jaestefaniah27/scroll_wheel/KEYBOARD_ORBY_V3/RASPBERRY_PROJECT/ORBY_V4/task.md

# Tareas: Diseño y Desarrollo del Firmware Orby

- [x] Analizar el código base existente (`main.cpp`, `pinout.h`, `hardware_oled.h`, `main_diag.cpp`).
- [x] Crear el Plan de Implementación inicial y plantear las preguntas de diseño al usuario.
- [x] Obtener feedback del usuario para determinar el camino a seguir (Opción A vs Opción B).
- [x] Completar y refinar el documento `interaccion_humano_maquina.md`:
    - [x] Detallar la especificación del hardware elegido.
    - [x] Agregar el Diagrama JSD (Jackson System Development).
    - [x] Agregar el Diagrama STN (State Transition Network) de los menús.
    - [x] Definir el protocolo formal de comunicación serial PC-Teclado.
- [x] Desarrollar e implementar el firmware en C++ según el diseño acordado.
- [x] Desarrollar o adaptar la interfaz gráfica en `OrbyGUI` para integrarla con el firmware.
- [ ] Validar e implementar pruebas de verificación integradas.

## Firmware 2.0 — scroll de alta resolución (hecho)

- [x] Descriptor HID de ratón con Resolution Multiplier (usage 0x48) y rueda de 16 bits.
- [x] Callbacks GET/SET_FEATURE para negociar el multiplicador con Windows.
- [x] PID cambiado a 0x4006 para invalidar el descriptor cacheado por el host.
- [x] Intervalo del endpoint HID bajado de 5 ms a 1 ms.
- [x] AS5600: muestreo a 1 kHz, salida a 250 Hz, filtro EMA sobre la posición,
      banda muerta de arranque y comprobación del imán cada 500 ms en vez de por
      cada iteración del bucle.
- [x] Acumulador de scroll que conserva el resto (era la causa directa de los saltos).
- [x] Sensibilidad configurable de 6 a 240 clics por vuelta (por defecto 60).
- [x] Telemetría `WHEEL:` agregada a 20 Hz para no saturar el CDC.

## Firmware 2.0 — configuración editable (hecho)

- [x] Perfiles mutables en RAM con persistencia versionada en Flash.
- [x] Banco de bitmaps OLED personalizados (20 huecos por perfil).
- [x] Escritura en Flash por perfil, para no dejar el USB mudo durante el borrado.
- [x] Comandos `GET_STATE`, `GET_PROFILE`, `SET_NAME`, `SET_LABEL`, `SET_KEYMAP`,
      `SET_SCROLL`, `SET_SCROLL_INV`, `GET_SCROLL`, `OLED_CHUNK`, `OLED_CLEAR`,
      `RESET_DEFAULTS`.

## OrbyGUI 2.0 (hecho)

- [x] Sin recursos remotos: tipografía del sistema e iconos SVG en línea.
- [x] Empaquetado con electron-builder (`npm run dist`).
- [x] Consola con búfer circular, filtro, pausa e historial.
- [x] Botón «Guardar en Flash» con indicador de cambios pendientes.
- [x] Editor de perfiles real, leyendo del firmware (sin datos duplicados).
- [x] Captura de atajos pulsándolos en el teclado del PC.
- [x] Vista de calibración de la rueda con estado de la alta resolución.
- [x] Editor de iconos OLED con importación de imagen y difuminado.
- [x] Editor OLED v2: lienzo a altura completa con zoom 3×-28×, selector de
      destino como réplica del teclado (icono real + atajo de cada tecla),
      capa flotante movible y escalable para imagen y texto, suavizado de
      bordes previo al umbral y 11 fuentes del sistema.
- [x] `GET_OLED` en el firmware para leer los bitmaps guardados.

## Encoders y rueda configurables (hecho)

- [x] Modelo `RotaryAction` con 8 huecos por perfil: dos encoders (giro horario,
      antihorario y pulsación) más los dos sentidos de la rueda magnética.
- [x] Tipos: nada, multimedia, atajo de teclado, desplazamiento vertical,
      desplazamiento horizontal (AC Pan) y zoom (Ctrl + rueda).
- [x] Tabla de teclas de consumo ampliada a 16 entradas conservando los índices
      antiguos. Corregidas las de brillo: el código usaba 0x00B0/0x00B1, que en
      la página de consumo son Play y Pause, no brillo.
- [x] Cola de paneo horizontal junto a la vertical en el informe de ratón.
- [x] Comandos `SET_ROTARY` y volcado `PROF:<n>:ROT:...` en `GET_PROFILE`.
- [x] Editor en la vista Perfiles, con espejado automático del sentido contrario
      en las acciones de desplazamiento.

## Protección de la configuración (hecho)

- [x] Migración de ajustes entre versiones de formato en vez de descartarlos.
      Los bitmaps OLED viven en su propia región de Flash y sobreviven al
      flasheo, pero la máscara de huecos ocupados está en el sector de ajustes:
      invalidarla equivalía a perder los iconos.
- [x] Rutas de migración desde `0xDEB001CE` (v1) y `0xDEB00204` (v2).
- [x] Copia de seguridad completa a un archivo JSON del PC (perfiles, mandos e
      iconos en hexadecimal) con restauración.
- [x] Guía de uso en `OrbyGUI/README.md`.

## Auto-cambio de perfil por aplicación (hecho)

- [x] Detector de ventana activa sin módulos nativos: PowerShell de vida larga
      con P/Invoke a `GetForegroundWindow`, arrancado con `-EncodedCommand`.
- [x] Motor de reglas con prioridad por orden y comparación contra ejecutable,
      título de ventana o ambos.
- [x] Perfil de reserva cuando ninguna regla encaja.
- [x] Configuración local en `%APPDATA%\OrbyGUI\orby-config.json` (no ocupa Flash).
- [x] Vista con estado en vivo, sugerencias rápidas y botón «añadir la app actual».

## Arranque de la app (hecho)

- [x] `OrbyGUI.bat`: doble clic → instala si hace falta, compila y abre.
- [x] Eliminada la dependencia `wait-on` (no estaba instalada y rompía `npm run dev`);
      Electron reintenta la carga del servidor de Vite.
- [x] Modo desarrollo por flag `--dev` en vez de deducirlo de `app.isPackaged`.
- [x] Aviso claro al conectar un teclado con firmware anterior al 2.0.

## Firmware 3.0 — perfiles variables, capa SUPER en los mandos y rueda por perfil (hecho)

- [x] Perfiles con alta y baja en caliente: `ADD_PROFILE`, `DUP_PROFILE`,
      `DEL_PROFILE`. Al borrar se desplazan también el tramo del banco de
      bitmaps y su máscara, que van indexados por perfil.
- [x] Los mandos giratorios pasan de 8 a 16 huecos: 0-7 capa normal y 8-15 capa
      SUPER. Al migrar y al crear un perfil, SUPER arranca copiando la normal,
      así que quien no la toque no nota el cambio.
- [x] La calibración de la rueda deja de ser global: vive en el perfil y con un
      valor por capa (`SET_PSCROLL`, volcado `PROF:<n>:SCR:<capa>:...`).
- [x] Menú físico de perfiles con tantas opciones como perfiles haya, en lugar
      de las cuatro fijas.
- [x] Formato de ajustes `0xDEB00300` con migración desde `0xDEB00205` (v3),
      `0xDEB00204` (v2) y `0xDEB001CE` (v1): no se descarta nada.
- [x] `GET_STATE` informa del recuento y del tope (`STATE:PROFILES:<n>:<max>`).

## OrbyGUI 3.0 (hecho)

- [x] Dashboard con la disposición real: 12 teclas a la izquierda y, a su
      derecha, los dos encoders arriba y la rueda como disco grande debajo, que
      gira los mismos grados que la rueda física.
- [x] Perfiles y macros con la réplica del teclado del editor de iconos: cada
      tecla enseña su icono real, y el inspector tiene «Editar icono», que salta
      al editor con ese perfil, tecla y capa ya seleccionados.
- [x] Caché compartida de bitmaps (`src/oled-cache.js`) entre el editor de
      perfiles y el de iconos: leer los 20 huecos por el CDC es lento y se hacía
      dos veces.
- [x] El interruptor NORMAL/SUPER afecta a todo el perfil: teclas, mandos y rueda.
- [x] Crear, duplicar y eliminar perfiles desde la app, con contador de huecos.
- [x] La vista de rueda desaparece del menú lateral y pasa a ser una tarjeta más
      dentro de cada perfil, con su ajuste por capa.
- [x] Cambio automático con tarjetas por aplicación (programa + perfil) y
      tarjeta aparte para el perfil por defecto.
- [x] Fuera el ajuste de brillo de pantallas.
- [x] Copia de seguridad v2: perfiles variables, 16 mandos y rueda por capa;
      al restaurar crea los perfiles que falten.
- [x] Telemetría `WHEEL:<incremento>:<ángulo>`: el firmware manda también el
      ángulo absoluto del AS5600, así que la app dibuja la rueda donde está de
      verdad en vez de acumular incrementos que se descuadran al reconectar.
- [x] Calibración del marcador (`src/wheel-dial.js`): sentido de giro, desfase
      en grados y forma (círculo o raya), compartida por el dashboard y el
      editor y guardada en la configuración local.

## Variaciones de perfil por aplicación (hecho)

- [x] `src/variants.js`: un perfil puede tener variaciones que guardan **solo
      las diferencias** (teclas, mandos y etiquetas) para una app concreta, en
      vez de obligar a duplicar el perfil entero por un atajo.
- [x] Se escriben en la RAM del teclado al detectar la app y se revierten al
      salir, releyendo el valor base de `store.state.profiles`.
- [x] `withBase()` protege «Guardar en Flash»: revierte, guarda y vuelve a
      aplicar, para que la variación no acabe grabada como el perfil.
- [x] Editar el perfil base con una variación puesta reafirma después el hueco
      redefinido (`reassertSlot`), que si no quedaría pisado.
- [x] Interfaz: barra «Según la app» bajo las pestañas, tarjeta de ajustes de la
      variación, marcas ámbar en los huecos redefinidos y botón «Volver al valor
      base» en el inspector.
- [x] Las variaciones siguen a su perfil al borrar otro (reindexado) y se van
      con él si se borra el suyo.
- [x] Cada variación admite **varias aplicaciones** (`matches`), porque el mismo
      retoque suele valer para más de un programa. Migración automática de las
      que guardaban una sola (`match`).

## Firmware 3.1 — tope de 16 perfiles (hecho)

- [x] `MAX_PROFILES` de 8 a 16. El banco de iconos pasa a 116 KB de RAM (BSS
      total 136 KB de 264 KB) y la Flash reservada llega hasta 1672 KB.
- [x] `custom_oled_dirty` de 8 a 16 bits: con un `uint8_t` los perfiles del 9 en
      adelante nunca se habrían llegado a grabar.
- [x] Los ajustes ya no caben en un sector: pasan a dos, y la región de bitmaps
      se desplaza uno. Migración `0xDEB00300` → `0xDEB00310` que rescata los
      iconos de su posición antigua y los marca para reescribir.
- [x] Guarda de disposición (`static_assert`) para que ampliar el tope no se
      coma el final de la Flash sin avisar.
- [x] Menú físico por ventanas de diez pantallas que siguen al cursor, y que se
      abre sobre el perfil que esté puesto en vez de sobre el primero.

## Dueño único de las pantallas (hecho)

Arreglo de un fallo latente que salió a la luz al meter la primera intro: se
veía la chispa y a los dos segundos las diez pantallas se quedaban en negro para
siempre.

**Causa:**

- Hay **dos instancias de `HardwareOled`**: `oleds` en Core 1 y `main_oled_ctrl`
  en Core 0 (`main.cpp`), esta última solo para encender y apagar las pantallas
  al entrar y salir del reposo.
- El constructor llama a `gpio_init(Pins::OLED_RST)`, y `gpio_init()` del SDK
  hace `gpio_put(gpio, 0)` antes de nada. Al construir la instancia de Core 0 se
  deja **OLED_RST a nivel bajo**, es decir, las diez SSD1306 en reset
  permanente. Nadie vuelve a subirlo: solo lo hace `init_all_screens()`, que
  Core 0 no llama.
- Hoy no se nota por los pelos: Core 0 llega a construir `main_oled_ctrl` unos
  microsegundos después de lanzar Core 1, y los 21 ms de `init_all_screens()`
  de Core 1 llegan después y vuelven a subir RST. Es una carrera que se gana por
  casualidad.
- La intro movía el arranque de Core 1 dos segundos antes, así que Core 0 pasaba
  a construir su instancia **después** del `init_all_screens()` de Core 1: RST se
  quedaba abajo y las pantallas se apagaban. De ahí el círculo que desaparece.
- El constructor además llama a `spi_init()`, que resetea el periférico. Si pilla
  a Core 1 dentro de un `spi_write_blocking()`, este se queda esperando datos en
  una FIFO que ya no llegarán.

**Arreglado así:**

- [x] Fuera `main_oled_ctrl` de Core 0. El reposo se pide con `displays_on` y
      `display_power_req`, y lo ejecuta Core 1 en su bucle, que es el único
      dueño del bus SPI y de los pines del OLED.
- [x] `gpio_put(Pins::OLED_RST, 1)` en el constructor de `HardwareOled`, para
      que construir la clase no pueda volver a dejar las pantallas en reset.

## Intro de arranque, segundo intento: horneada (hecho)

El problema del primer intento no era solo el reset: diseñar la animación a
ciegas y recompilar el firmware en cada prueba es un ciclo lentísimo. Ahora la
animación se diseña en el PC y el firmware solo la reproduce.

- [x] `tools/anim/index.html`: editor con vista previa, reproducción, barra de
      tiempo y unos treinta parámetros (fases, tipografía, tamaños, ondas,
      gravedad, rozamiento, temblor de la arena...). Doble clic, sin npm.
- [x] La animación se **hornea a píxeles**: se trocea en los diez framebuffers
      de 360 bytes del SSD1306 y eso es lo que se graba. No hay dos
      implementaciones que se puedan desincronizar, y la vista previa se pinta
      desde esos mismos framebuffers ya binarizados.
- [x] Comprimido por longitud de carrera y con máscara de pantallas que cambian:
      95 fotogramas ocupan 38 KB y solo cambian 3,7 pantallas de media, así que
      se ahorra el 63 % del SPI. El peor fotograma son 2,9 ms sobre 33.
- [x] `include/oled_intro.h` pasa a ser un reproductor de 60 líneas. Si no
      existe `orby_intro_data.h` la intro no hace nada y el firmware compila
      igual.
- [x] Verificado de punta a punta: la huella FNV‑1a de los 95×10 framebuffers
      del editor coincide con la que sale de descomprimir el flujo en C.
- [x] Cualquier tecla o pulsador la corta (`intro_skip_req`).

## Calidad del dispositivo (hecho)

### Antirrebote de las teclas

- [x] Las doce teclas se leían en crudo (`!gpio_get()` y a actuar). Los
      pulsadores de los encoders sí tenían antirrebote, las teclas no. Un
      pulsador mecánico rebota de 1 a 5 ms y el bucle gira cada 250 us: un solo
      toque podía colar hasta veinte flancos y repetir el atajo, y un rebote al
      soltar podía reenviar la macro entera.
- [x] Antirrebote por bloqueo de 5 ms: se acepta el primer flanco al instante
      (cero latencia añadida) y se ignora lo que llegue después. SUPER y la
      tecla 12 leen del mismo estado filtrado.

### Salida HID de verdad (`include/hid_out.h`)

- [x] **Había un solo hueco de los seis**: `uint8_t keycodes[6] = {keycode,...}`.
      Mantener A y pulsar B soltaba A, y soltar B mandaba un informe a cero que
      soltaba las dos. Ahora las teclas físicas son estado, cada hueco recuerda
      lo que envió y el informe se recompone de los huecos ocupados.
- [x] **Se bloqueaba hasta 100 ms** (200 en las multimedia) esperando al
      endpoint, dentro del mismo bucle que muestrea el AS5600 a 1 kHz: pulsar
      algo mientras girabas abría un agujero en el muestreo del scroll. Ahora
      nada espera: `pump()` suelta como mucho un informe por vuelta cuando el
      canal está libre, y la rueda tiene preferencia.
- [x] Los giros de encoder van a una cola aparte, porque son eventos puntuales
      que no se pueden fundir con el estado. Dos pasos seguidos del mismo
      encoder producen pulsa-suelta-pulsa-suelta, no una sola pulsación.
- [x] Soltar una tecla ya no consulta el perfil: cambiar de capa con la tecla
      hundida no puede dejarla pegada.
- [x] El Ctrl del zoom pasa a ser un modificador pegajoso que dura mientras se
      siga girando, en vez de pulsarse y soltarse en cada detent con la rueda
      enviada en medio. La rueda no sale hasta que el Ctrl ha llegado al host.
- [x] 30 comprobaciones en `tools/test/` que corren en el PC contra un TinyUSB
      de mentira: rollover, modificadores compartidos, cambio de capa con tecla
      hundida, pulsaciones puntuales, endpoint ocupado, suspensión y zoom.

### Arranque y resistencia

- [x] Los dos segundos de `sleep_ms(2000)` del arranque no llamaban ni una vez
      a `tud_task()`: el teclado estaba en el bus sin contestar a la
      enumeración. Ahora son 300 ms atendiendo al USB mientras tanto.
- [x] `tud_umount_cb` y `tud_suspend_cb` sueltan todo. Si el PC se suspende o
      se tira del cable con una tecla hundida, ya no se queda pegada. Al
      despertar no se reenvía nada a propósito, que sería escribir sin permiso.
- [x] Watchdog de 8 segundos, alimentado por Core 0 solo mientras Core 1 siga
      dando latido (`core1_heartbeat`): un cuelgue de cualquiera de los dos
      cores acaba en reinicio en vez de en un teclado muerto. Los bucles de
      espera largos (mantener la tecla 12, grabar los perfiles) lo alimentan.
- [x] Si el reinicio vino del watchdog se salta la intro, para dejar el teclado
      operativo cuanto antes.

## Rueda: modificadores pegados y paneo de alta resolución (hecho)

### «La rueda no hace scroll si hay alguna tecla pulsada»

No era la contienda por el endpoint: una prueba que reproduce el bucle real
(`tools/test/test_wheel.cpp`) demuestra que con una tecla mantenida salen los 50
informes de rueda de 200 ms y **no se pierde ni una unidad**. El firmware
mandaba el scroll perfectamente.

La causa era el host: una tecla mapeada a `Ctrl+algo` mantiene el Ctrl puesto
mientras esté hundida, y con Ctrl puesto la rueda deja de hacer scroll y hace
zoom (con Shift, scroll horizontal). Es lo mismo que pasaría en cualquier
teclado; lo que lo hacía visible es que un macropad manda atajos, no teclas.

- [x] Las combinaciones con modificador (`mod != 0 && key != 0`) se envían como
      pulsación breve en vez de mantenerse: `ORBY_COMBO_AS_TAP`. Mantener Ctrl+C
      dos segundos no copiaba dos veces, solo dejaba el Ctrl puesto.
- [x] Las teclas sueltas y los modificadores a pelo (Ctrl sin tecla, para usarlo
      con el ratón) **siguen manteniéndose**: hacen falta para el autorrepetido
      y para modificar clics.
- [x] Se pierde el autorrepetido de combinaciones tipo Ctrl+Z. Está en un
      `#define` para poder volver atrás.
- [x] Arreglada de paso una fuga en la compuerta del zoom: si al dejar de girar
      quedaban unidades a medias, se quedaba esperando un Ctrl que ya no iba a
      volver y la rueda enmudecía para siempre.

### Paneo horizontal de alta resolución

- [x] `AC Pan` pasa de 8 a 16 bits y gana **su propio multiplicador de
      resolución**, en una Logical Collection aparte: el host los negocia por
      separado (`g_hires_pan`).
- [x] El paneo acumula en unidades de alta resolución igual que el vertical, con
      el resto conservado. Antes viajaba en detents enteros, así que iba a
      tirones aunque el vertical fuese suave, y por encima de 127 se recortaba.
- [x] Feature report reorganizado: dos bits de multiplicador vertical, dos de
      horizontal y cuatro de relleno, en un byte.
- [x] **PID de 0x4006 a 0x4007.** Windows cachea el descriptor por VID/PID; sin
      subirlo leería el informe descuadrado.
- [x] `SCROLL:OK` gana un cuarto campo con el estado del paneo, al final para no
      romper a quien lea solo tres. La app lo muestra junto al del vertical.
- [x] `tools/test/check_descriptor.py`: valida que las Collection cuadran, que el
      informe declarado coincide con `orby_mouse_report_t` (56 bits, 7 bytes) y
      que hay dos multiplicadores. Un descriptor mal formado no da un error
      bonito: Windows rechaza el dispositivo entero.
- [x] La salida de la rueda sale de `main.cpp` a `include/wheel_out.h`, que es lo
      que permite probarla en el PC.
- [x] Sentido por defecto del paneo **invertido** (`ORBY_PAN_INVERT`), solo el
      horizontal. Se hace en `add_pan()`, que es el único punto por el que pasa
      todo el movimiento horizontal, así que la rueda magnética y los encoders
      configurados como paneo quedan igual. El vertical no se toca y el
      interruptor de invertir de cada perfil sigue funcionando encima.
- [x] (2026-11-04) Los encoders iban al revés: girar a la derecha desplazaba a la
      izquierda. `ORBY_PAN_INVERT` desaparece: `add_pan()` sigue el AC Pan del HID
      (horario = derecha) y la inversión pasa a `wheel_accumulate()`, solo para
      la rueda magnética, que queda como estaba.

## SUPER y menú intercambiados (hecho)

- [x] Ahora **SUPER es la tecla 12** y **el menú la 10**; estaban al revés.
- [x] En el firmware las dos teclas de sistema pasan a tener nombre
      (`KEY_IDX_SUPER` y `KEY_IDX_MENU`, base 0): cambiarlas de sitio otra vez
      es cambiar dos líneas, en vez de perseguir índices sueltos por el bucle.
- [x] La telemetría `KEY_EV` de SUPER sale con el número de tecla correcto, y la
      app deja de comparar contra el 10 a pelo.
- [x] Lo mismo en la app: `KEY_SUPER` y `KEY_MENU` en `store.js`, usados por el
      dashboard, la vista de perfiles y el editor de iconos. Los textos que
      explicaban qué hace cada tecla se generan de esas constantes.
- [x] `tools/test/check_keys.py`: comprueba que firmware y app coinciden en qué
      tecla es cada cosa, y que ninguna de las dos tiene pantalla asignada. Si
      se desincronizan, la app pinta los papeles al revés y el interruptor
      NORMAL/SUPER deja de seguir a la tecla real: un fallo silencioso.
- [x] README de la app actualizado.

## Firmware 4.0 — páginas por perfil (firmware hecho, app pendiente)

Cada perfil tiene de una a cuatro páginas, y una página es un juego completo de
lo que hace el teclado: teclas, etiquetas, mandos, rueda **e iconos**.

### El banco de iconos se muda a la Flash

El problema era solo uno: lo barato de una página son 260 bytes, pero los iconos
son 7424 por página. Con 16 perfiles × 4 páginas serían 464 KB de los 264 KB de
RAM del chip.

- [x] El banco sale de la RAM y vive en Flash de 1024 a 1536 KB: 64 tramos de
      8 KB, uno por (perfil, página). Se **pinta directamente desde ahí** — el
      RP2040 mapea la Flash (XIP), así que al SPI se le pasa un puntero y no hay
      que copiar ni descomprimir.
- [x] **BSS de 140.064 a 53.988 bytes: 86 KB liberados.**
- [x] En RAM solo queda un búfer de 7,4 KB con la página en edición, para que un
      icono recién subido se vea antes de grabarlo.
- [x] Cada perfil se queda con su tramo (`Profile.oled_bank`) mientras viva, así
      borrar un perfil solo reordena metadatos. Con el banco indexado por
      posición habría que arrastrar medio megabyte de Flash.
- [x] Descartada la idea de comprimir: ahorraría Flash que no falta (512 KB de
      1400 libres) a cambio de registros de tamaño variable —cambiar un icono
      obligaría a reescribir el perfil entero— y de que un blob corrupto se lleve
      el perfil en vez de un icono. Buena palanca si algún día hacen falta 8
      páginas o 32 perfiles.

### Migración

- [x] Formato `0xDEB00400`, con rutas desde los cinco anteriores. Lo guardado
      pasa a ser la página 0 de cada perfil.
- [x] **El orden importa**: los iconos viejos se copian antes de reescribir los
      ajustes, porque la región de ajustes nueva pisa la del banco antiguo. Las
      zonas de origen y destino son disjuntas, así que la copia no se destruye a
      sí misma. Lo comprueba `tools/test/check_flash_map.py`.
- [x] Se graba en el formato nuevo en cuanto migra, para no repetir la migración
      —y su desgaste de Flash— en cada arranque.
- [x] Arreglado un cuelgue de arranque que introduje yo: la migración escribe en
      Flash desde `load_settings()`, que corre **antes** de lanzar Core 1, y
      pedía el `multicore_lockout` a un core que todavía no existía. Ahora se
      consulta `multicore_lockout_victim_is_initialized(1)`.
- [x] Los literales de los perfiles de fábrica no se han tocado: tienen su propio
      tipo sin páginas (`DefaultProfile`) y se copian a la página 0, en vez de
      reestructurar 150 líneas de llaves anidadas.

### Las tres formas de cambiar de página

- [x] **Botón de menú, pulsación corta**: siguiente página, en ciclo. La larga
      sigue abriendo el menú de perfiles.
- [x] **Tecla «ir a la página N»** (`0xFD` en el modificador, número en base 1 en
      el keycode).
- [x] **Tecla «estado de páginas»** (`0xFC`): su pantalla enseña `P2/4`, y al
      pulsarla entra al gestor, donde cada pantalla lleva un número, la página
      actual sale en negativo y pulsar un número salta a esa página. La pantalla
      10 sale sin cambiar nada.
- [x] Las acciones especiales van en el campo `modifier`, que un atajo normal
      nunca alcanza, así que no hace falta cambiar la estructura ni migrar.
- [x] Al cambiar de perfil la página vuelve a la primera: el perfil nuevo puede
      tener menos.

### Protocolo

- [x] `SET_PAGE`, `ADD_PAGE`, `DEL_PAGE`, `STATE:PAGE:<actual>:<total>:<tope>` y
      `MAXPAGES` en el ACK (FW=4.0).
- [x] `GET_PROFILE` vuelca primero la página sin numerar —la que lee la app
      actual— y después una por página con el número delante. Los comandos de
      edición que no llevan página actúan sobre la que esté puesta, así que **la
      app actual sigue funcionando** aunque no vea las páginas todavía.

## OrbyGUI 4.0 — páginas en la app (hecho)

- [x] El modelo del perfil pasa a tener `pages[]`, y `labels`, `keys`, `rotary`,
      `scroll` y `oledMask` se convierten en **accesos** (`Object.defineProperty`)
      a la página seleccionada. Así las 2100 líneas de las vistas siguen escritas
      igual y no puede haber dos copias que se desincronicen. No son enumerables,
      para que la copia de seguridad vea la estructura de páginas de verdad.
- [x] `GET_PROFILE` lee todas las páginas; si el firmware es anterior al 4.0 y no
      manda ninguna numerada, lo que llega sin numerar se toma como la única.
- [x] Pestañas de página en el editor de perfiles, con **+** (añade copiando la
      actual) y **−** (elimina, con confirmación). Solo aparecen si el firmware
      las soporta: con `maxPages` a 1 la vista queda exactamente como antes.
- [x] Elegir una pestaña **cambia también la página en el teclado**, porque los
      comandos de edición del firmware actúan sobre la activa. Efecto secundario
      bueno: las pantallas enseñan siempre lo que estás tocando. Solo se permite
      en el perfil activo; en los demás se edita su primera página.
- [x] Las dos acciones nuevas en el inspector de teclas, con su explicación.
      Multimedia y páginas se apropian del campo del modificador, así que tocar
      un modificador sale de ese modo en vez de mezclarse con él.
- [x] **La caché de iconos lleva la página en la clave.** Sin eso, el mismo
      (perfil, hueco) es un icono distinto en cada página y la app enseñaría los
      de la anterior.
- [x] Copia de seguridad v3: guarda `pages` con **todas** las páginas. Antes de
      esto habría guardado solo la que estuviese seleccionada y el usuario no se
      habría enterado hasta querer restaurarla. Al restaurar crea las páginas que
      falten antes de escribir en ellas.
- [x] `tools/test/check_keys.py` comprueba también que firmware y app usan los
      mismos códigos para las tres acciones especiales (`0xFE`, `0xFD`, `0xFC`):
      si divergen, la app graba algo que el teclado no reconoce y la tecla se
      queda muda sin dar ningún error.

## Pendiente

- [ ] Probar en hardware: flashear `build/ORBY_V4.uf2` y verificar el scroll
      suave, la capa SUPER de los mandos y el alta/baja de perfiles.
- [ ] Probar en hardware el arreglo del dueño único, sobre todo que las
      pantallas siguen despertando bien al salir del reposo.
- [ ] Probar en hardware el antirrebote, el rollover (mantener dos teclas a la
      vez) y que el zoom con Ctrl sigue funcionando en el navegador.
- [ ] Probar el paneo horizontal en algo que lo aproveche (Excel, un lienzo de
      Figma, una línea de tiempo) y comprobar que la app enseña «Paneo
      horizontal en alta resolución» tras enchufarlo.
- [ ] `BOOT_SETTLE_MS` está en 300 ms. Si algún arranque se ve raro, era el
      único valor de los tres cambios que es un juicio y no un cálculo.
- [ ] **Páginas: probar en hardware.** Hay copia de seguridad hecha. Lo primero
      que hay que comprobar es que los iconos siguen ahí después de migrar, y
      después el ciclo con el botón de menú, la tecla de salto y el gestor.
- [ ] **Páginas en la app**: hoy la app edita la página que esté puesta y no sabe
      que existen las demás. Falta la interfaz (pestañas de página, alta y baja,
      las dos acciones nuevas en el inspector de teclas) y llevar las páginas a la
      copia de seguridad y a las variaciones por aplicación.
- [ ] Afinar la animación a gusto en `tools/anim` y volver a exportar. Los
      huecos (`Hueco horizontal` y `Hueco vertical`) son lo único que conviene
      calibrar mirando el teclado de verdad.
- [ ] Pruebas de verificación integradas.
