jaestefaniah27/scroll_wheel/KEYBOARD_ORBY_V3/RASPBERRY_PROJECT/ORBY_V4/docs/notas-fw-4.18.md

# Firmware 4.18

## Los mandos giran al revés por defecto

El sentido de giro normal de los dos mandos pasa a ser el contrario al de antes:
el que había que marcar en Ajustes → **Sentido de mandos y rueda**. Vale para
las acciones, los menús y las páginas. La rueda no cambia.

**Si tenías marcados los dos mandos como invertidos**, después de actualizar
vuelven a girar como antes. Desmárcalos en Ajustes para quedarte con el sentido
nuevo. Si no tenías nada marcado, notarás que los mandos giran al revés: es el
cambio.

Trae también la 4.17: la animación al elegir perfil en el menú (los iconos se
recogen hacia el perfil elegido y salen los del perfil nuevo).

Sin cambios en el protocolo ni en el formato de la Flash.
