jaestefaniah27/scroll_wheel/KEYBOARD_ORBY_V3/RASPBERRY_PROJECT/ORBY_V4/OrbyGUI/docs/PUBLICACION.md

# Publicar ORBY como producto

Qué hace falta para que ORBY deje de parecer un proyecto de escritorio: que
Windows no avise al instalar la app, que el teclado se presente como un aparato
con identidad propia, y que haya una página donde descargarlo.

Este documento es la parte operativa del punto correspondiente de
[TODO.md](../../TODO.md). Lo que ya está hecho está hecho; lo que queda son
gestiones con terceros o cosas que cuestan dinero.

---

## 1. Identidad USB

### Estado

Hecho en `src/usb_descriptors.c`:

- VID y PID salen de `ORBY_USB_VID` / `ORBY_USB_PID`, en un solo sitio.
- `bcdDevice` vale `0x0410`, la versión de firmware real (4.1). Antes decía 1.0.
- El número de serie se genera con el ID único de la flash de la Pico, así que
  cada teclado tiene el suyo. Antes todos decían `123456`.
- Los strings dicen lo que el aparato es: `Orby` / `Orby V4` / `Orby V4 Control`
  / `Orby V4 Input`.

Pendiente: **el VID sigue siendo `0xCafe`**, que es el de los ejemplos de
TinyUSB. No es nuestro y no se puede distribuir con él.

### Pedir un PID a Raspberry Pi

Raspberry Pi reparte PIDs gratis bajo su VID `0x2E8A` a productos basados en
RP2040. Es la vía buena: no cuesta nada y el aparato queda enumerado bajo un VID
legítimo con un PID que es solo nuestro.

> Un VID propio de USB-IF cuesta unos 6.000 $ de una vez. No tiene sentido aquí.
> La otra alternativa gratis es pid.codes (VID `0x1209`), que exige proyecto de
> código abierto.

El proceso es una *pull request* al repositorio `raspberrypi/usb-pid`. **Lee su
README antes de abrirla**, porque el formato de la tabla ha cambiado alguna vez.
El contenido a aportar es este:

- **Producto:** ORBY V4
- **Descripción:** teclado macro de 12 teclas con 10 pantallas OLED, dos
  encoders y rueda de scroll de alta resolución, sobre RP2040.
- **Interfaces USB:** HID (teclado, ratón con scroll de alta resolución,
  consumidor) + CDC para la configuración.
- **Repositorio:** https://github.com/jaestefaniah27/scroll_wheel
- **Contacto:** jaestefaniah27@gmail.com

### Cuando lo concedan

Cambiar **en el mismo commit** los dos sitios, o la app deja de encontrar el
teclado:

1. `src/usb_descriptors.c` → `ORBY_USB_VID` a `0x2E8Au` y `ORBY_USB_PID` al
   asignado.
2. `OrbyGUI/electron/serial.js` → añadir la entrada al array `KNOWN_IDS`,
   **sin quitar** la de `cafe`: los teclados ya flasheados siguen ahí fuera.

Ojo con una consecuencia: Windows cachea el *report descriptor* HID por VID/PID.
Al cambiar el VID, el host trata el teclado como un aparato nuevo y vuelve a
leer el descriptor, que es lo que queremos. Pero también significa que las
asociaciones que Windows tuviera guardadas (número de puerto COM, por ejemplo)
se pierden: el teclado aparecerá en un COM distinto la primera vez.

---

## 2. Firmar la aplicación

El aviso azul al instalar es **SmartScreen**, y sale porque el `.exe` no va
firmado. No hay forma de quitarlo sin una firma: la reputación de SmartScreen
para binarios sin firmar se calcula por hash de fichero, así que cada versión
nueva empieza de cero y con el volumen de este proyecto no se limpia nunca.

Un certificado autofirmado **no sirve**: SmartScreen lo ignora y encima obliga
al usuario a instalar la CA a mano. Es peor que no firmar.

Desde junio de 2023 el CA/B Forum obliga a guardar la clave privada en hardware
(FIPS 140-2 nivel 2). Ya no existe la opción de un `.pfx` en el disco.

### Opciones, de menos a más dinero

| Vía | Coste | Requisitos | Resultado |
|---|---|---|---|
| **SignPath Foundation** | 0 € | proyecto de código abierto con licencia OSI, repo público, build en CI | certificado OV real |
| **Microsoft Store** | ~19 €, pago único | cuenta de desarrollador individual, empaquetar en MSIX | firma de Microsoft, **cero SmartScreen** |
| Azure Trusted Signing | ~10 €/mes | entidad legal verificada | OV; la reputación se acumula |
| OV con token USB | 250–400 €/año | entidad legal verificada | igual que el anterior |
| EV con token USB | 400–700 €/año | entidad legal registrada | el mejor, casi inmediato |

**Empezar por SignPath.** Es gratis y es la única opción que no exige ser una
empresa. Si dicen que no, la Store por 19 € es lo siguiente.

### Solicitud a SignPath Foundation

Se pide en `signpath.org` (sección Foundation / open source). Borrador:

> Asunto: Free code signing for ORBY V4 — open-source macro keyboard
>
> Hello,
>
> I maintain ORBY V4, an open-source macro keyboard built on the RP2040. The
> project has two parts: the firmware for the keyboard itself (C++, Pico SDK)
> and OrbyGUI, an Electron desktop app that configures it.
>
> I would like to apply for a free code signing certificate for the OrbyGUI
> Windows installer. Right now it ships unsigned, and every user has to click
> through the SmartScreen warning, which is exactly the habit I do not want to
> teach people who install my software.
>
> - Repository: https://github.com/jaestefaniah27/scroll_wheel
> - What gets signed: the NSIS installer and the app executable, both produced
>   by electron-builder.
> - Build: GitHub Actions, from public sources, reproducible from a tagged
>   commit.
>
> One question before I apply formally: I am considering selling optional
> profile packs for the app in the future, while the app and firmware stay
> open source. Would that conflict with the Foundation's eligibility criteria?
>
> Thank you,
> Jorge

**Antes de mandarlo hay que decidir la licencia.** El repositorio no tiene
ninguna, y SignPath exige una licencia OSI. Es una decisión con consecuencias:
una licencia permisiva (MIT, Apache-2.0) deja que cualquiera fabrique y venda
el teclado; una copyleft fuerte (GPL-3.0) obliga a quien lo haga a publicar sus
cambios. Para hardware que se quiere vender, GPL-3.0 en el firmware y MIT en la
app es un reparto habitual. **No está decidido: hay que elegir a mano.**

### Cuando haya certificado

En `OrbyGUI/package.json`:

1. Subir `electron-builder` de 24.13.3 a 26 o superior (el soporte de Azure
   Trusted Signing, `azureSignOptions`, llegó ahí).
2. Añadir `win.publisherName` con el nombre exacto del certificado.
   `electron-updater` lo usa para validar la firma del instalador que descarga;
   sin él, la actualización automática no comprueba nada.

Hacer las dos cosas el mismo día que se contrate: el trabajo es gratis pero no
sirve de nada suelto.

---

## 3. Publicar una versión

> **La app se actualiza sola, y eso convierte este apartado en obligatorio.**
> `tauri-plugin-updater` pide el `latest.json` de la última release y rechaza
> cualquier instalador cuya firma no cuadre con la clave pública que lleva
> dentro. Una release **sin `latest.json`, o con una firma que no case, deja
> mudo al actualizador de todo el parque instalado y no avisa de nada**: la app
> sigue funcionando y nadie se entera de que dejó de actualizarse.

### La clave de firma

El par se generó una vez con `npm run tauri signer generate` y **no se puede
sustituir sin romper las instalaciones existentes**: cada copia instalada lleva
la clave pública compilada dentro y rechaza lo que venga firmado con otra.

| Qué | Dónde |
|---|---|
| Clave privada | `%USERPROFILE%\.tauri\orby.key` — **fuera del repositorio**, sin contraseña: el fichero *es* el secreto |
| Clave pública | `src-tauri/tauri.conf.json`, en `plugins.updater.pubkey` |

**Si se pierde la privada, no hay arreglo remoto**: hay que publicar una versión
con una clave nueva y que cada usuario la instale a mano. Merece una copia de
seguridad en el gestor de contraseñas o donde vayan las cosas que no se pueden
volver a generar.

### Los pasos

```powershell
cd OrbyGUI
$env:TAURI_SIGNING_PRIVATE_KEY = "$env:USERPROFILE\.tauri\orby.key"
$env:TAURI_SIGNING_PRIVATE_KEY_PASSWORD = ""
npm run tauri:build
```

Con esas dos variables puestas, el empaquetado deja **dos** ficheros en
`src-tauri/target/release/bundle/nsis/`: el `OrbyGUI_<version>_x64-setup.exe` y
su `OrbyGUI_<version>_x64-setup.exe.sig`. Sin ellas el `.sig` no se genera y la
release nace rota.

Con el `.sig` se compone el `latest.json`, que es lo que el actualizador lee:

```json
{
  "version": "1.0.2",
  "notes": "…",
  "pub_date": "2026-08-28T00:00:00Z",
  "platforms": {
    "windows-x86_64": {
      "signature": "<el contenido entero del fichero .sig>",
      "url": "https://github.com/jaestefaniah27/scroll_wheel/releases/download/v1.0.2/OrbyGUI_1.0.2_x64-setup.exe"
    }
  }
}
```

**Los tres ficheros van como assets de la release**: el `.exe`, el `.sig` y el
`latest.json`. El endpoint que consulta la app es
`releases/latest/download/latest.json`, así que la release tiene que ser la
última **y no ir marcada como prerelease** — que es justo el motivo por el que
las de firmware sí lo van.

La huella SHA256 sigue publicándose para quien instale a mano: mientras no haya
certificado, es lo único que distingue nuestro instalador de cualquier otro
fichero con el mismo nombre.

```powershell
Get-FileHash .\src-tauri\target\release\bundle\nsis\OrbyGUI_*_x64-setup.exe -Algorithm SHA256
```

En las notas de la versión, pegar la salida y el recordatorio del aviso:

```markdown
## Instalación

Windows mostrará el aviso de SmartScreen: el instalador todavía no va firmado
(ver docs/PUBLICACION.md). Para continuar: **Más información → Ejecutar de
todas formas**.

Antes de ejecutarlo, comprueba que el fichero es el que publicamos:

    Get-FileHash .\OrbyGUI-Setup.exe -Algorithm SHA256

    SHA256: <pegar aquí>
```

---

## 4. La landing

Vive en `web/index.html`, en la raíz del proyecto ORBY_V4. Es un único fichero
estático, sin build ni dependencias.

Se publica a mano, solo cuando se pide: GitHub Actions no corre en esta cuenta y
Pages sirve la rama `gh-pages` (Settings → Pages → *Deploy from a branch*). Empujar a
`main` **no** publica nada. Para subir landing y WebGUI:

```bash
tools/publicar-web.sh        # necesita GH_TOKEN
```

Queda en `https://jaestefaniah27.github.io/scroll_wheel/`.

Un dominio propio cuesta unos 12 €/año y se conecta desde la misma pantalla de
Pages (campo *Custom domain* + un registro CNAME en el proveedor del dominio).

---

## 5. Lo que queda bloqueado por dinero

Nada de esto se puede adelantar sin presupuesto, pero conviene saber el orden y
el motivo:

- **Certificado de firma** — ver la tabla de arriba. Sin él, SmartScreen sigue.
- **Marca "Orby"** — la CA verifica el nombre legal al emitir el certificado.
  Además, comprobar antes que la marca esté libre.
- **Marcado CE** para vender el teclado en la UE: directiva EMC 2014/30/UE más
  RoHS. La declaración la firma uno mismo, pero hace falta informe de
  laboratorio (EN 55032 emisiones clase B, EN 55035 inmunidad): 1.500–4.000 €.
  Es el mayor coste del proyecto. Solo cuando el hardware esté congelado.
- **Registro RAEE** en España y Ecoembes por el embalaje, que van con lo
  anterior.
- **FCC Part 15 clase B** si se vende en EEUU.
- **Kickstarter**: exige entidad legal, cuenta bancaria, vídeo y coste unitario
  cerrado. Y enviar a la UE sin CE no es una opción.

---

## Apéndice: qué se descartó

**Descriptores Microsoft OS 2.0 (BOS/WCID).** Estaban en la lista y se han
dejado fuera a propósito. En un dispositivo compuesto CDC + HID, Windows ya
enlaza `usbser.sys` por clase desde Windows 10: los descriptores MS OS solo
servirían para colgar una propiedad de registro (`DeviceInterfaceGUIDs`) que
hoy no usa nadie, porque `serial.js` encuentra el puerto por VID/PID. A cambio
obligan a subir `bcdUSB` a `0x0201` y a añadir un descriptor binario escrito a
mano; si sale mal, el aparato no enumera. Coste real, beneficio cero.

Si algún día `serial.js` necesita localizar el puerto por GUID en vez de por
VID/PID, se retoma. Y si se retoma: **nunca declarar un ID de compatibilidad**
en el subconjunto de función del CDC. Declarar `WINUSB` ahí sustituye a
`usbser.sys` y deja el puerto serie inservible.
