jaestefaniah27/scroll_wheel/KEYBOARD_ORBY_V3/RASPBERRY_PROJECT/ORBY_V4/docs/superpowers/plans/2026-11-01-consejos.md

# Consejos Implementation Plan

> **For agentic workers:** REQUIRED SUB-SKILL: Use superpowers:subagent-driven-development (recommended) or superpowers:executing-plans to implement this plan task-by-task. Steps use checkbox (`- [ ]`) syntax for tracking.

**Goal:** Una vista Consejos (bombilla en la barra) con vídeos cortos y accesos directos, y avisos ocasionales dentro de la app que llevan a ella.

**Architecture:** Los consejos son datos en `src/tips.js`; qué consejo toca y cuándo lo decide un módulo puro y probado (`src/web/tips-pick.mjs`). Los vídeos viven en git, un manifiesto con hashes dice cuáles son, y el backend (con la lógica de "qué falta" en `orby-core`) los baja una vez a `%APPDATA%\OrbyGUI\tips\`. La vista y el aviso son JS vanilla sobre `ui.js`, `store.js` y `window.orby`.

**Tech Stack:** JS vanilla ES (sin framework ni TypeScript), `node --test`, Rust (`orby-core` + `src-tauri`), `reqwest` blocking + `sha2` si no está ya en el árbol (comprobar antes de añadir; si hay que añadirlo, sin nada en C).

**Spec:** [docs/superpowers/specs/2026-11-01-consejos-design.md](../specs/2026-11-01-consejos-design.md)

## Global Constraints

- Todo en castellano (UI, comentarios, commits, docs). Los comentarios explican el **por qué**.
- Sin framework y sin TypeScript en el renderer.
- Colores solo por tokens de `:root` con valor en claro **y** oscuro; nada de `rgba()` a mano (usa `rgba(var(--primary-rgb), a)`).
- Avisos con el aspecto de los `toast` de `src/ui.js`; **no** notificaciones de Windows.
- Un método nuevo en `window.orby` toca las tres vías: `src/tauri/orby-tauri.js`, `electron/preload.js`, `src/web/orby-web.js`; `test/superficie-orby.test.mjs` debe seguir pasando.
- Lógica que se pueda probar sin red ni teclado va en `orby-core`, no en `src-tauri/src/`.
- Vídeos: mp4 H.264, ≤ 480 px de ancho, 5-10 s, sin audio, ≤ 300 KB cada uno; en `OrbyGUI/tips-video/`.
- Cadencia: como mucho 1 aviso al día y no antes de 2 minutos de uso; solo con ventana visible, teclado conectado, `state.dirty === false` y sin otro `toast` en pantalla; nunca repetir un consejo.
- Config local (`getConfig`/`setConfig`) guarda `consejos` (bool, por defecto `true`), `consejosVistos` (ids), `consejoUltimoAviso` (ms epoch).
- El código funciona con **ningún** vídeo presente (hueco «Vídeo próximamente»).
- Descarga de vídeos desde `raw.githubusercontent.com/jaestefaniah27/scroll_wheel/main/KEYBOARD_ORBY_V3/RASPBERRY_PROJECT/ORBY_V4/OrbyGUI/tips-video/`.
- No publicar release ni subir versión en este plan.

## Review Focus

1. Manifiesto roto, vacío o con un `sha256` mal escrito: no debe romper el arranque ni dejar la app sin consejos (se ignora y se usa lo ya descargado).
2. Descarga cortada o con hash que no coincide: el fichero parcial no se queda como válido ni se enseña.
3. Config sin las claves nuevas, o con `consejosVistos` que incluye ids que ya no existen: se tratan como vacío / se ignoran.
4. Reloj que va hacia atrás (`consejoUltimoAviso` en el futuro): no bloquea los avisos para siempre.
5. Consejo cuyo `requiere` no tiene el firmware conectado, o ningún teclado conectado: no se avisa y en la lista sale atenuado.

---

### Task 1: Lógica del manifiesto de vídeos en `orby-core`

**Files:**
- Create: `OrbyGUI/src-tauri/crates/orby-core/src/consejos.rs`
- Modify: `OrbyGUI/src-tauri/crates/orby-core/src/lib.rs` (añadir `pub mod consejos;`)

**Interfaces:**
- Produces:
  - `pub struct EntradaVideo { pub id: String, pub fichero: String, pub bytes: u64, pub sha256: String }`
  - `pub fn leer_manifiesto(json: &str) -> Vec<EntradaVideo>` — tolerante: JSON inválido → vacío; entradas sin id/fichero/sha de 64 hex o con `fichero` que contenga `/`, `\` o `..` se descartan una a una.
  - `pub fn faltan(manifiesto: &[EntradaVideo], presentes: &[(String, String)]) -> Vec<EntradaVideo>` — `presentes` son pares `(fichero, sha256 calculado)` de lo que hay en disco; devuelve las entradas cuyo fichero no está o cuyo hash no coincide.
  - `pub fn sha256_hex(datos: &[u8]) -> String`

- [ ] **Step 1: Tests** (en el propio `consejos.rs`, `#[cfg(test)]`): `manifiesto_valido_se_lee`, `json_invalido_da_vacio`, `entrada_con_ruta_peligrosa_se_descarta` (`"../x.mp4"`, `"a/b.mp4"`), `sha_mal_formado_se_descarta`, `faltan_devuelve_los_que_no_estan`, `faltan_devuelve_los_de_hash_distinto`, `faltan_vacio_si_todo_coincide`, `sha256_de_cadena_vacia_es_el_conocido` (`e3b0c442...b855`).
- [ ] **Step 2:** `cd OrbyGUI/src-tauri && cargo test -p orby-core consejos` → FALLA (no compila).
- [ ] **Step 3: Implementar** lo de Interfaces. Comprobar antes `Cargo.toml` de `orby-core` y del árbol por `sha2`; si no está, añadirlo con `default-features = false`.
- [ ] **Step 4:** el mismo comando → todos PASAN.
- [ ] **Step 5: Commit** `feat(consejos): lógica del manifiesto de vídeos en orby-core`.

### Task 2: Descarga de vídeos y `window.orby.tips` en las tres vías

**Files:**
- Create: `OrbyGUI/src-tauri/src/tips.rs`
- Modify: `OrbyGUI/src-tauri/src/main.rs` (módulo + `generate_handler!` + lanzar `tips::sincronizar_al_arrancar` en `setup`), `OrbyGUI/src-tauri/tauri.conf.json` (permitir servir ficheros locales al webview solo desde la carpeta de vídeos), `OrbyGUI/src/tauri/orby-tauri.js`, `OrbyGUI/electron/preload.js`, `OrbyGUI/src/web/orby-web.js`, `OrbyGUI/src/platform.js` (`PC_ONLY` solo si hace falta)
- Test: `OrbyGUI/test/superficie-orby.test.mjs` (existente, debe seguir pasando)

**Interfaces:**
- Consumes: `orby_core::consejos::{leer_manifiesto, faltan, sha256_hex, EntradaVideo}`.
- Produces (`window.orby`, mismos nombres en las tres vías):
  - `tips.videoSrc(id: string): Promise<string | null>` — URL usable en `<video src>`; `null` si ese vídeo no existe o no está bajado. Tauri: fichero local ya verificado; Web: URL cruda de GitHub (HEAD no necesario: el `<video>` gestiona el `error`); Electron: `null`.
  - `tips.sync(): Promise<{ descargados: number, fallos: number }>` — baja los que falten. Web y Electron: `{descargados:0, fallos:0}`.

- [ ] **Step 1:** Ejecutar `node --test test/superficie-orby.test.mjs` y anotar que pasa antes de tocar nada.
- [ ] **Step 2: `tips.rs`**: carpeta `%APPDATA%\OrbyGUI\tips\` (la misma base que `config.rs`, **no** `app_config_dir()`, ver el comentario de `config::ruta`); comandos `#[tauri::command] tips_video_src(id) -> Option<String>` y `tips_sync() -> Value`; escritura a `*.part` y renombrado solo tras comprobar `sha256_hex`; manifiesto bajado de `…/tips-video/manifest.json` con el agente `firmware::AGENTE`, y, si no hay red, el último guardado en la carpeta. `sincronizar_al_arrancar` corre en un hilo, sin bloquear el arranque, ignora los errores (los registra con `log`).
- [ ] **Step 3:** Registrar comandos y módulo en `main.rs`; en `tauri.conf.json` habilitar el protocolo de assets con alcance **solo** a la carpeta de vídeos reales (`%APPDATA%\OrbyGUI\tips\**`; ojo: `$APPDATA` de Tauri resuelve a `com.orby.gui`, no a `OrbyGUI`).
- [ ] **Step 4:** Añadir el espacio de nombres `tips` en las tres vías con las firmas de Interfaces.
- [ ] **Step 5:** `node --test test/superficie-orby.test.mjs` → PASA; `cargo build` en `src-tauri` compila.
- [ ] **Step 6: Commit** `feat(consejos): descarga única de vídeos y window.orby.tips`.

### Task 3: Qué consejo toca y cuándo (módulo puro)

**Files:**
- Create: `OrbyGUI/src/web/tips-pick.mjs`
- Test: `OrbyGUI/test/tips-pick.test.mjs`

**Interfaces:**
- Produces:
  - `export const MIN_USO_MS = 120000; export const ENTRE_AVISOS_MS = 86400000;`
  - `export function puedeAvisar(c: { ahora:number, inicioApp:number, ultimoAviso:number|null, activo:boolean, visible:boolean, conectado:boolean, sinGuardar:boolean, hayAviso:boolean }): boolean`
  - `export function siguienteConsejo(tips: Array<{id:string, requiere?:string}>, vistos: string[], soporta: (clave:string)=>boolean): string | null` — primero de la lista no visto cuyo `requiere` (si lo hay) cumple `soporta`.

- [ ] **Step 1: Tests** (`node:test`): `no_avisa_antes_de_dos_minutos`, `avisa_pasados_dos_minutos`, `no_avisa_dos_veces_el_mismo_dia`, `avisa_al_dia_siguiente`, `ultimoAviso_en_el_futuro_no_bloquea` (reloj hacia atrás: se trata como si hubiera pasado el plazo), `no_avisa_con_cambios_sin_guardar`, `no_avisa_desconectado`, `no_avisa_con_la_ventana_oculta`, `no_avisa_con_otro_aviso_en_pantalla`, `no_avisa_si_consejos_apagados`, `siguiente_salta_vistos`, `siguiente_salta_los_que_requieren_algo_que_falta`, `siguiente_ignora_ids_vistos_que_ya_no_existen`, `siguiente_devuelve_null_si_no_queda_ninguno`.
- [ ] **Step 2:** `node --test test/tips-pick.test.mjs` → FALLA.
- [ ] **Step 3: Implementar** las dos funciones sin tocar DOM ni almacenamiento.
- [ ] **Step 4:** mismo comando → PASA. También `node --test test/*.mjs` completo.
- [ ] **Step 5: Commit** `feat(consejos): reglas de cuándo avisar y qué consejo toca`.

### Task 4: Datos de los consejos y vista Consejos con la bombilla

**Files:**
- Create: `OrbyGUI/src/tips.js`, `OrbyGUI/src/views/tips.js`
- Modify: `OrbyGUI/index.html` (botón `btn-tips` entre `btn-theme` y `btn-profiles`; contenedor `view-tips`), `OrbyGUI/src/main.js` (`VIEWS`, `VIEW_TITLES`, `switchView` marca `on`, listener conmutador como `btn-settings`), `OrbyGUI/src/icons.js` (icono `bulb`), `OrbyGUI/src/views/settings.js` (`openTarget` acepta `{ card: <id> }` además de `section`), `OrbyGUI/src/styles/index.css` (tarjeta de consejo, vídeo pequeño)
- Test: `OrbyGUI/test/tips-datos.test.mjs`

**Interfaces:**
- Consumes: `tips.videoSrc(id)` (Task 2), `compat.supports(info, clave)`.
- Produces:
  - `export const TIPS: Array<{ id, categoria, titulo, texto, requiere?, accion?: { etiqueta, vista, destino? } }>` con los 19 consejos de la tabla del spec; `accion.vista` es una clave de `VIEWS` y `accion.destino` el id de tarjeta/apartado que esa vista abre vía `openTarget`.
  - `export function render()`, `export function init()`, `export function openTarget(params: { id?: string })` (hace scroll a la tarjeta de ese consejo y la marca vista) en `views/tips.js`.

- [ ] **Step 1: Tests de datos**: `ids_unicos`, `categorias_validas` (las seis del spec), `cada_requiere_existe_en_FEATURES` (importar `FEATURES` de `compat.js`), `cada_accion_apunta_a_una_vista_real` (la lista de vistas válidas se escribe en el test), `textos_no_vacios`. `node --test test/tips-datos.test.mjs` → FALLA.
- [ ] **Step 2:** Escribir `tips.js` (texto de cada consejo verificado contra `docs/COMPATIBILIDAD.md` y el comportamiento real) hasta que pase el test.
- [ ] **Step 3:** Vista: tarjetas por categoría; vídeo `<video muted loop playsinline autoplay>` ~320 px de ancho, cargado con `videoSrc`; si es `null` o da `error`, hueco «Vídeo próximamente»; consejo con `requiere` no soportado → atenuado con «Necesita firmware X» (tomar `since` de `FEATURES`) y sin botón; botón de acceso directo llama a `switchView`/navegación con `openTarget`. Usar `nav.js` si ya expone el navegador (`setNavigator`).
- [ ] **Step 4:** Para cada `accion` de `TIPS`, comprobar a mano con `npm run tauri:dev` que el botón llega a la tarjeta correcta (anotar en el commit cuáles). Si una tarjeta no tiene `id`, añadírselo.
- [ ] **Step 5:** Tests de todo `node --test test/*.mjs` → PASAN.
- [ ] **Step 6: Commit** `feat(consejos): vista Consejos con bombilla y accesos directos`.

### Task 5: Aviso en la app y ajuste para apagarlo

**Files:**
- Create: `OrbyGUI/src/tips-notice.js`
- Modify: `OrbyGUI/src/ui.js` (`toast` acepta `{ onClick, ms, icon }` sin romper las llamadas actuales), `OrbyGUI/src/main.js` (arrancar el planificador tras el arranque), `OrbyGUI/index.html` y `OrbyGUI/src/views/settings.js` (interruptor «Mostrar consejos» en General), `OrbyGUI/src/styles/index.css` (aviso con bombilla y X)

**Interfaces:**
- Consumes: `puedeAvisar`, `siguienteConsejo`, `MIN_USO_MS` (Task 3), `TIPS` (Task 4), `getConfig`/`setConfig`, `state.connected`, `state.dirty`.
- Produces: `export function iniciarAvisos(): void` — comprueba cada 60 s; al avisar guarda `consejosVistos` + `consejoUltimoAviso` y muestra un toast de ~8 s «¿Sabías que…? {título}» que, al pulsarlo, abre la vista Consejos en esa tarjeta; la X lo cierra.

- [ ] **Step 1:** Ampliar `toast` con opciones; las llamadas existentes (`toast(msg, kind, ms)`) siguen igual.
- [ ] **Step 2:** `tips-notice.js`: lee config al arrancar (claves ausentes = valores por defecto de Global Constraints), llama a `puedeAvisar` con `hayAviso = document.querySelector('#toast-host .toast') !== null`.
- [ ] **Step 3:** Interruptor en Ajustes → General que escribe `consejos`; con `false` no hay avisos pero la bombilla sigue funcionando.
- [ ] **Step 4:** Verificar en `npm run tauri:dev` con `MIN_USO_MS` reducido temporalmente (volver a 120000): sale el aviso, pulsarlo abre el consejo, no vuelve a salir hasta mañana, con el interruptor apagado no sale.
- [ ] **Step 5:** `node --test test/*.mjs` → PASAN.
- [ ] **Step 6: Commit** `feat(consejos): aviso dentro de la app y ajuste para apagarlo`.

### Task 6: Carpeta de vídeos, manifiesto y documentación

**Files:**
- Create: `OrbyGUI/tips-video/manifest.json` (`{"schema":1,"videos":[]}` inicial), `OrbyGUI/tips-video/README.md` (cómo grabar y qué formato: ver Global Constraints), `tools/consejos/manifiesto.py` (recorre `tips-video/*.mp4` y regenera `manifest.json` con `id` = nombre sin extensión, `bytes`, `sha256`; aborta si algún mp4 pesa más de 300 KB)
- Modify: `CLAUDE.md` de `ORBY_V4` (una entrada breve: dónde están los consejos, los vídeos y cómo se añade uno), `docs/COMPATIBILIDAD.md` solo si cambia algo (no debería)

**Interfaces:**
- Consumes: el formato que lee `leer_manifiesto` (Task 1): `{ "schema":1, "videos":[{ "id", "fichero", "bytes", "sha256" }] }`.

- [ ] **Step 1:** Escribir el script y probarlo con dos mp4 de prueba (no se commitean); comprobar que el JSON generado lo acepta `cargo test -p orby-core consejos` (añadir ese caso de lectura con el JSON real).
- [ ] **Step 2:** Documentar el flujo: grabar → comprimir → copiar a `tips-video/<id>.mp4` → `python tools/consejos/manifiesto.py` → commit; la app lo baja en el siguiente arranque.
- [ ] **Step 3:** `cargo test -p orby-core` y `node --test test/*.mjs` → PASAN.
- [ ] **Step 4: Commit** `feat(consejos): carpeta de vídeos, generador de manifiesto y docs`.

---

## Autocomprobación

- **Cobertura del spec:** bombilla y vista (T4), aviso en la app y cadencia (T3, T5), acceso directo (T4), datos (T4), vídeos en git + descarga única + hueco (T1, T2, T4, T6), interruptor (T5), contrato de las tres vías (T2), 19 consejos (T4). Tareas del tablero: fuera del repo (spec).
- **Tipos:** `tips.videoSrc`/`tips.sync` (T2) las usa T4; `puedeAvisar`/`siguienteConsejo`/`MIN_USO_MS` (T3) las usa T5; `TIPS` (T4) las usa T5; formato del manifiesto (T1) lo produce T6.
- **Proporción:** el plan da firmas, nombres de test y valores del spec; los cuerpos los escribe quien construye.
