jaestefaniah27/scroll_wheel/KEYBOARD_ORBY_V3/RASPBERRY_PROJECT/ORBY_V4/OrbyGUI/docs/notas-v1.1.2.md

# OrbyGUI 1.1.2

Va con el **firmware 4.13**: la app avisa al conectar y lo instala desde Ajustes.

## Novedades

- **SUPER + menú en el teclado:** con SUPER mantenida, la pulsación corta de
  la tecla de menú retrocede de página y la larga abre el menú principal.
- **Pantallas del Inicio a resolución real:** las réplicas OLED del dashboard
  se dibujan ajustando cada píxel a la rejilla del monitor. Ya no se pierden
  columnas cuando la réplica mide menos de 72 px.

## Compatibilidad

Reconoce el firmware 4.13 y aprovecha sus nuevos comandos.
