jaestefaniah27/scroll_wheel/3d/ORVY_V4_KEYBOARD.step

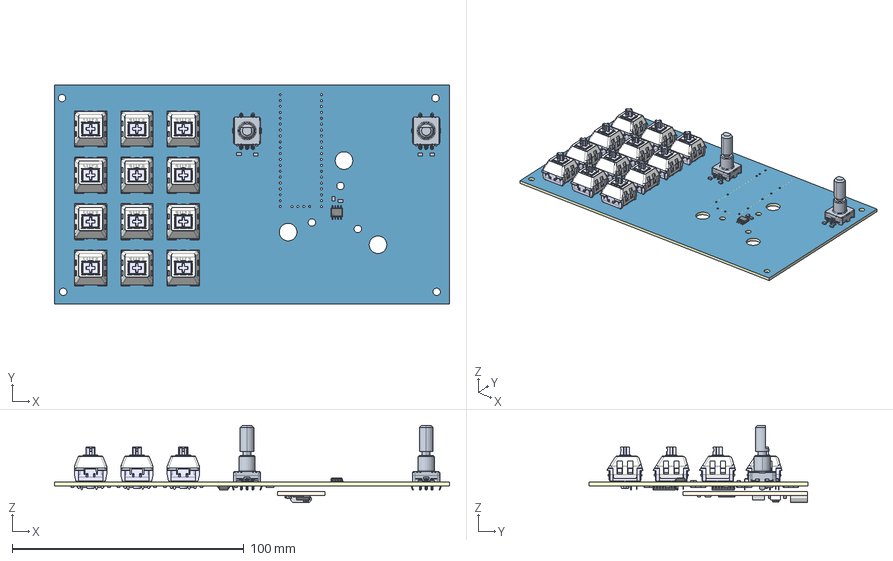
[picture p14: CAD file, 2026-05-25]
3d/ORVY_V4_KEYBOARD.step
170.4 x 94.4 x 33.4 mm
Board~DWvM
TopCopper~DWvM
BottomCopper~DWvM
TopFpcStiffener~DWvM
BottomFpcStiffener~DWvM
SW-TH_EC11E18244A5~ec11e18244a5.stp~DWvM x 2
RP PICO PURPLE~Purple Pico.step~DWvM
Key with slot Socket~Kailh Polia.step~DWvM x 60
SOIC-8_L5.0-W4.0-P1.27-LS6.0-BL~SOIC-8_L5.0-W4.0-P1.27-LS6.0-BL~DWvM
SW-SMD_4P-L4.2-W3.4-P2.15-LS5.2~SW-SMD_ 4P-L4.2-W3.4-H2.5-P2.15-LS5.2~DWvM
FPCC10~FPC-SMD_16P-P0.50_XUNPU_FPC-0.5HF-16PWBR-H20~FPC-SMD_16P-P0.50_ XUNPU_FPC-0.5HF-16PWBR-H20~DWvM x 10
R1~R0805~R0805_L2.0-W1.3-H0.6~DWvM x 2
C4~C0805~C0805_L2.0-W1.3-H1.3~DWvM x 46
SOIC-16_L9.9-W3.9-P1.27-LS6.0-BL~SOIC-16_ L9.9-W3.9-H1.8-LS6.0-P1.27~DWvM x 2
