jaestefaniah27/scroll_wheel/KEYBOARD_ORBY_V3/3D/Rejilla.3mf

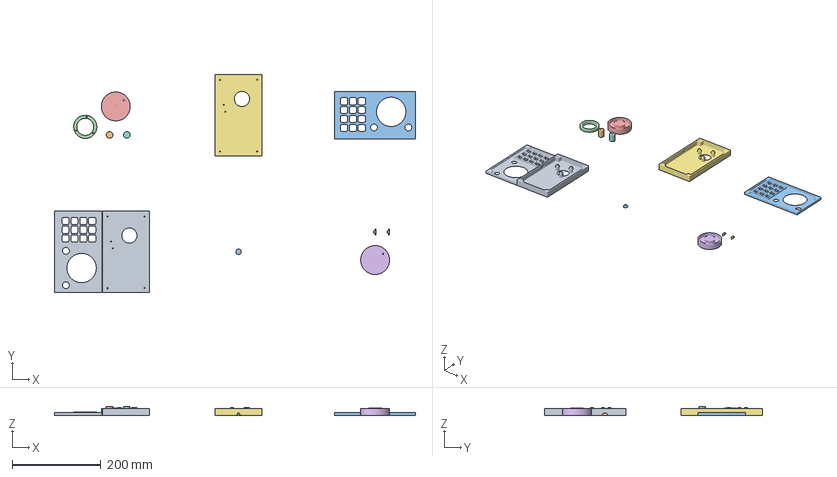
[picture p15: CAD file, 2026-08-01]
KEYBOARD_ORBY_V3/3D/Rejilla.3mf
811.9 x 489.6 x 21.0 mm
Base x 2
MiniTapa x 3
Tapa x 2
tapaEncoder x 2
Rejilla x 2
Outter_rodamiento
