jaestefaniah27/scroll_wheel/KEYBOARD_ORBY_V3/3D/MiniTapa.3mf

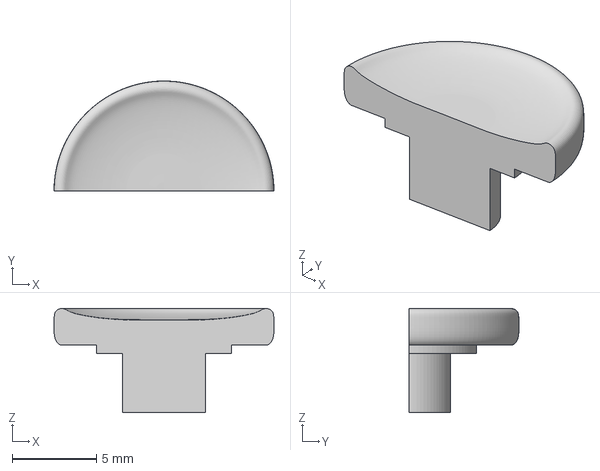
[picture p16: CAD file, 2026-08-01]
KEYBOARD_ORBY_V3/3D/MiniTapa.3mf
13.1 x 6.53 x 6.18 mm
