jaestefaniah27/scroll_wheel/KEYBOARD_ORBY_V3/3D/Tapa.3mf

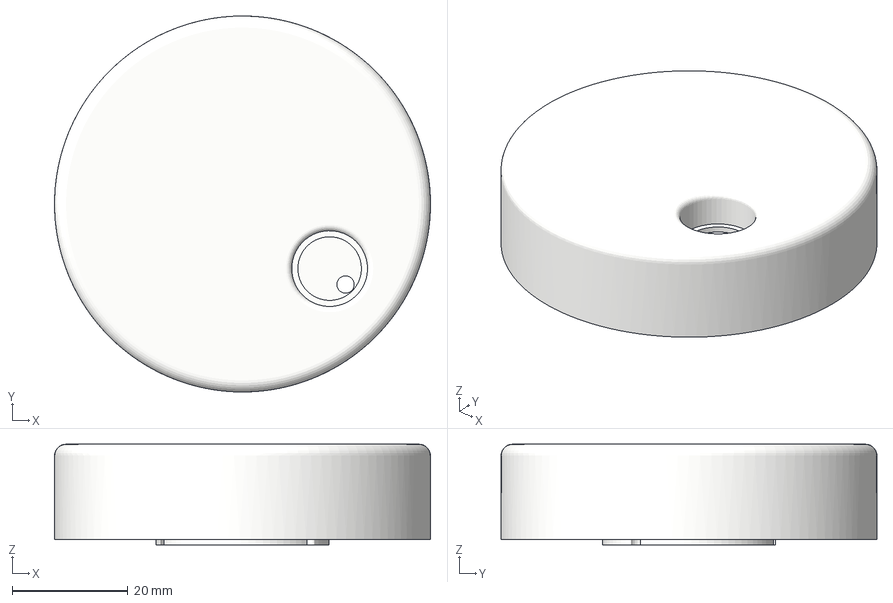
[picture p17: CAD file, 2026-08-01]
KEYBOARD_ORBY_V3/3D/Tapa.3mf
65.0 x 65.0 x 17.4 mm
