jaestefaniah27/scroll_wheel/KEYBOARD_ORBY_V3/3D/Outter_rodamiento.3mf

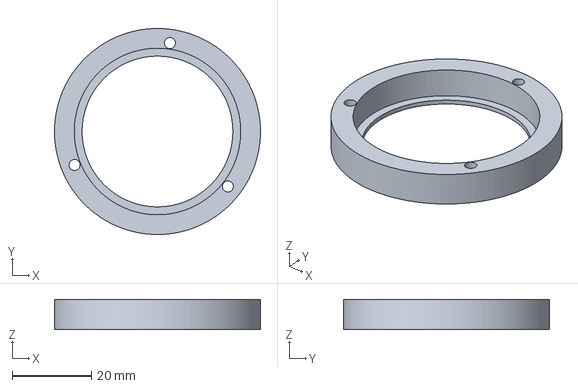
[picture p18: CAD file, 2026-07-27]
KEYBOARD_ORBY_V3/3D/Outter_rodamiento.3mf
52.1 x 52.1 x 7.70 mm
