jaestefaniah27/scroll_wheel/KEYBOARD_ORBY_V3/3D/tapaEncoder.3mf

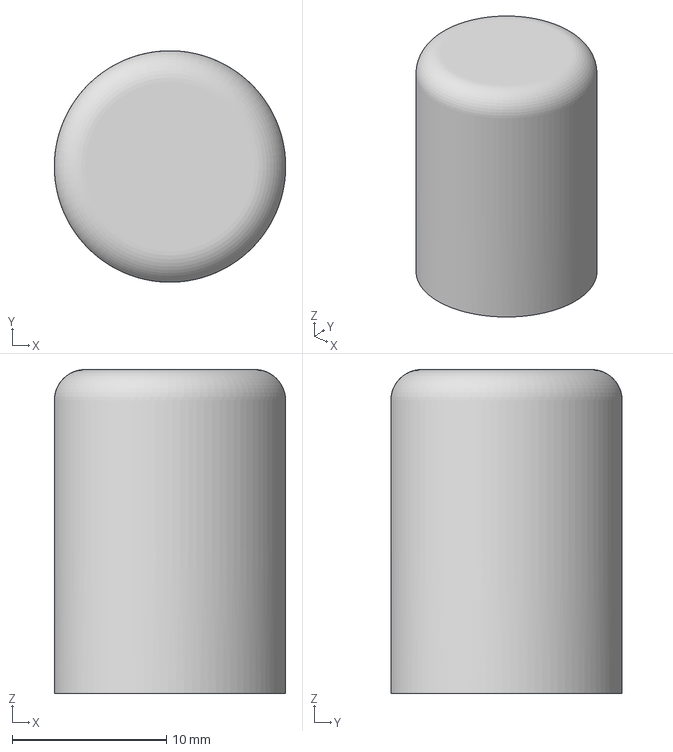
[picture p19: CAD file, 2026-07-27]
KEYBOARD_ORBY_V3/3D/tapaEncoder.3mf
15.0 x 15.0 x 21.0 mm
