jaestefaniah27/scroll_wheel/KEYBOARD_ORBY_V3/3D/Base.3mf

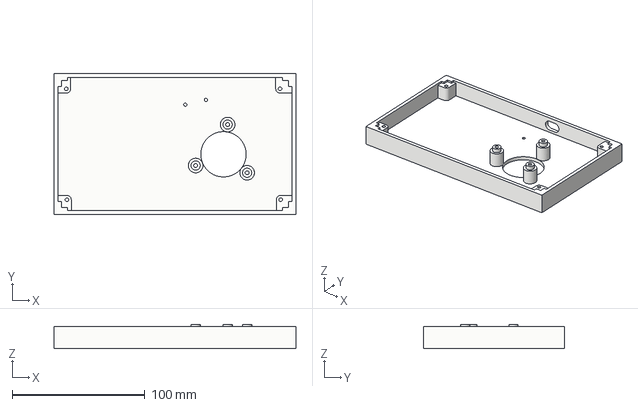
[picture p20: CAD file, 2026-07-27]
KEYBOARD_ORBY_V3/3D/Base.3mf
182.4 x 106.4 x 18.4 mm
