jaestefaniah27/scroll_wheel/KEYBOARD_ORBY_V3/3D/ORBY.step

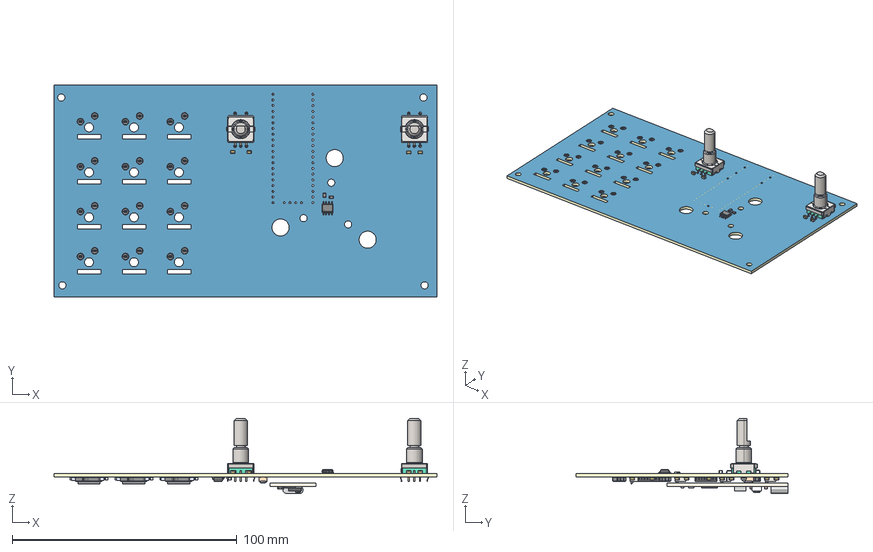
[picture p21: CAD file, 2026-03-11]
KEYBOARD_ORBY_V3/3D/ORBY.step
170.4 x 94.4 x 33.4 mm
Board~GKqA
TopCopper~GKqA
BottomCopper~GKqA
TopFpcStiffener~GKqA
BottomFpcStiffener~GKqA
R0805~R0805_L2.0-W1.3-H0.6~GKqA x 2
SOIC-8_L5.0-W4.0-P1.27-LS6.0-BL~SOIC-8_L5.0-W4.0-P1.27-LS6.0-BL~GKqA
Key with slot Socket~PG151101S11--3DModel-STEP-1.STEP~GKqA x 12
RP PICO PURPLE~Purple Pico.step~GKqA
C0805~C0805_L2.0-W1.3-H1.3~GKqA x 46
SW-TH_EC11E18244A5~SW-TH_ EC11E18244A5-L11.7-W12.0-H24.5-P2.5-LS14.5~GKqA x 2
SW-SMD_4P-L4.2-W3.4-P2.15-LS5.2~SW-SMD_ 4P-L4.2-W3.4-H2.5-P2.15-LS5.2~GKqA
FPC-SMD_16P-P0.50_XUNPU_FPC-0.5HF-16PWBR-H20~FPC-SMD_16P-P0.50_XUNPU_ FPC-0.5HF-16PWBR-H20~GKqA x 10
SOIC-16_L9.9-W3.9-P1.27-LS6.0-BL~SOIC-16_ L9.9-W3.9-H1.8-LS6.0-P1.27~GKqA x 2
