jaestefaniah27/scroll_wheel/(list of files, cad)

Other CAD files:
KEYBOARD_ORBY_V3/3D/MiniTapa_media.3mf
