jaestefaniah27/scroll_wheel/KEYBOARD_ORBY_V3/RASPBERRY_PROJECT/ORBY_V4/OrbyGUI/docs/TODO.md

### Consejos: commiteados, sin publicar (2026-11-02)

La vista Consejos (bombilla de la barra), los avisos y la descarga de vídeos están en `main`
pero **no se ha subido versión ni publicado nada**: salen con la próxima release de la app, junto
con el resto de cambios. Diseño y plan en `docs/superpowers/` (`specs/` y `plans/`, 2026-11-01).

* [ ] Al preparar esa release: subir la versión (tres ficheros, ver `docs/PUBLICACION.md`) y
  comprobar que `OrbyGUI/tips-video/manifest.json` está en `main` (la app lo baja de GitHub).
* [ ] Verlo en `npm run tauri:dev`: solo se ha comprobado midiendo el DOM en un arnés, sin
  captura. Mirar el aspecto de la vista, del aviso y de la tarjeta en modo claro y oscuro.
* [ ] Probar con el teclado conectado que cada acceso directo cae en su tarjeta y que los
  consejos con `requiere` salen atenuados con un firmware antiguo.
* [ ] Vídeos (tablero orvy.es/admin/tablero, tareas 55-58): probar los gestos, grabarlos,
  comprimirlos a `tips-video/<id>.mp4` y ejecutar `python tools/consejos/manifiesto.py`.
  La descarga única a `%APPDATA%\OrbyGUI\tips\` no se ha probado de punta a punta hasta que
  haya al menos un vídeo subido.
* [ ] Revisar los textos de `OrbyGUI/src/tips.mjs` (tarea 58 del tablero).

### Pendiente con el teclado y el PC delante (firmware 4.17, 2026-10-30)

La animación de elegir perfil (succión y explosión, tipo `PICK`) está en `main` y solo se ha
probado en simulación (`tools/test/test_anim.cpp`) y compilando en Linux. Falta en casa:

* [x] Flashear la 4.17 con `.\flash.ps1` (cerrar antes OrbyGUI desde la bandeja: **Salir**).
* [x] Probarla en el teclado de verdad, con cada forma de elegir perfil:
  * tecla de menú mantenida y tocar un perfil («menú + perfil»);
  * menú principal → Perfiles → elegir;
  * mando de menú (`SET_MENUENC`): mantener, girar y soltar;
  * con más de diez perfiles, eligiendo uno de la segunda ventana (el origen es
    `perfil - perf_menu_first`: comprobar que sale de la pantalla correcta);
  * elegir el perfil que ya estaba puesto: tiene que cerrar el menú como antes, sin succión.
* [x] Juzgar el ritmo en los OLED reales. Si la succión va demasiado rápida o lenta, se cambia
  `SUCK` en `include/oled_anim.h` **y** en `OrbyGUI/src/oled-anim.mjs`, y se regenera el
  dorado (`tools/test/anim_golden.cpp`). Cambiar solo la velocidad del grupo «perfil»
  en Ajustes también la mueve, pero junto con la onda de cambiar de perfil.
* [ ] Ver en `npm run tauri:dev` que el Inicio repite la animación con el espejo
  (`EV:SCR:GO:9:<ritmo>:<origen>`) y que sale de la misma pantalla que en el teclado.
* [x] Pasar `tools/test/run.ps1` en Windows: en verde (2026-10-30), y los 62 tests de Node con Node 22.
* [x] Publicada (prerelease) como `fw-v4.18` en vez de `fw-v4.17`, junto con los mandos
  al revés por defecto, y con Orvy 1.1.4, que es la que la instala (2026-10-30).

* [ ] Añadir biblioteca de perfiles para que los usuarios no tengan que crear los suyos desde cero. Los usuarios pueden aportar al pool de perfiles en el apartado perfiles de la comunidad. Los usuarios tienen que aportar Nombre del perfil y descripción. EN la biblioteca de perfiles sale el número total de atajos, el número de páginas, etc.
* [ ] He pensado en monetizar perfiles o paquetes de perfiles: el software básico es gratis pero hay que pagar una baja cantidad de € para obtener acceso a un paquete de perfiles para unos cuantos programas como Altium, excel, word, etc, o pagar cada uno por separado. Estudiar viavilidad de esto.
* [ ] **Que ORBY parezca un producto, no un proyecto.** La app ya es algo que usaría a diario
  y por lo que pagaría. Hace falta: que Windows no avise al instalar, que el teclado no se
  presente como un cacharro de pruebas al enchufarlo, y una web para venderlo.
  Evaluado el 2026-08-08 y partido en las tareas de abajo.
  Guía operativa: [OrbyGUI/docs/PUBLICACION.md](OrbyGUI/docs/PUBLICACION.md).

  **Se puede hacer ya, pero depende de terceros (0 €)**

  * [ ] Pedir un PID gratis bajo el VID de Raspberry Pi (`0x2E8A`) con una PR a
    `raspberrypi/usb-pid`. El texto está redactado en PUBLICACION.md § 1.
    Sigue con `0xCafe`, el VID de los *ejemplos* de TinyUSB: no es nuestro y no se puede
    distribuir así. Ocupar un PID del VID de Raspberry Pi sin concesión sería peor.
    Hacerlo **antes** de vender la primera unidad: cambiar el VID después deja a las ya
    vendidas en otro puerto COM.
  * [ ] Elegir licencia del repositorio. No tiene ninguna, y SignPath exige licencia OSI.
    Decisión con consecuencias: permisiva deja que cualquiera fabrique y venda el
    teclado; copyleft obliga a publicar los cambios. Bloquea lo de abajo.
  * [ ] Escribir a SignPath Foundation: certificados OV **gratis** para proyectos open source.
    Borrador listo en PUBLICACION.md § 2, con la pregunta sobre si los paquetes de
    perfiles de pago chocan con su criterio.

  **Casi gratis, cuando haya algo suelto**

  * [ ] 💰 Cuenta de desarrollador de Microsoft Store: ~19 €, **pago único**. La Store firma
    con el certificado de Microsoft → cero SmartScreen, sin certificado propio. Requiere
    empaquetar en MSIX (`electron-builder` ya trae target `appx`). Mejor relación
    resultado/dinero de toda la lista.
  * [ ] 💰 Dominio propio, ~12 €/año.

  **💰 BLOQUEADO — sin presupuesto ahora mismo**

  * [ ] Certificado de firma propio, si SignPath no sale. Desde junio de 2023 la clave privada
    tiene que vivir en hardware (FIPS 140-2 nivel 2): ya no vale un `.pfx` en disco.
    Azure Trusted Signing ~10 €/mes es lo barato; OV con token 250–400 €/año;
    EV 400–700 €/año. Todos exigen entidad legal verificada (autónomo vale).
  * [ ] Subir `electron-builder` de 24.13.3 a 26 (soporte de `azureSignOptions`) y añadir
    `win.publisherName` en `package.json`, que `electron-updater` lo necesita para validar
    la firma de las actualizaciones. El trabajo es gratis pero no sirve de nada sin
    certificado: hacerlo el mismo día que se contrate.
  * [ ] Registrar la marca "Orby". La CA verifica el nombre legal al emitir el certificado, y
    si se vende conviene tenerla antes.
  * [ ] Marcado CE para vender el teclado en la UE: directiva EMC 2014/30/UE + RoHS. La
    declaración la firmas tú, pero necesitas informe de laboratorio (EN 55032 emisiones
    clase B, EN 55035 inmunidad): 1.500–4.000 €. Es el mayor coste del proyecto entero.
    Solo cuando el hardware esté congelado.
  * [ ] Registro RAEE en España y Ecoembes por el embalaje. Va con lo anterior.
  * [ ] FCC Part 15 clase B si se vende en EEUU.
  * [ ] Kickstarter: exige entidad legal, cuenta bancaria, vídeo y coste unitario cerrado.
    Y enviar a la UE sin CE no es una opción.
* [ ] Añadir la opción a multimedia de una tecla que sea la hora. Añadir también la opción de una tecla que sea la fecha.
* [ ] Necesito investigar si gracias a la nueva funcionalidad de plugins, se puede hacer un plugin para que en chrome poder ejecutar ciertas acciones como: ir a la página número N del documento que tengo abierto ahora mismo. Y de manera similar a esto, si se podría hacer un plugin por ejemplo para altium, y poder realizar acciones de altium más fácilmente gracias al plugin, por ejemplo que el plugin detecte automáticamente si estás en un esquemático, en un diseño pcb, etc, y cambie de página de un perfil automáticamente (por ejemplo tener una página para esquemáticos, otra para layout, etc, y que el plugin ayude con la experiencia de crear los atajos ofreciendo ayudas). Lo mismo con un plugin para work o excel y cosas así. Después, evaluar si merece la pena que la existencia de estos plugins venga directamente en la app como funcionalidades disponibles, o es mejor que se mantengan como plugins separados disponibles a descargar desde la propia app por ejemplo.

  * **Investigación (2026-08-10):**
    * **Chrome:** Es posible mediante una *Chrome Extension* utilizando **Native Messaging** para comunicarse con la app de escritorio (OrbyGUI). La app registra un "Native Messaging Host" en el registro de Windows. La extensión puede leer la URL actual, inyectar scripts para leer el contexto (HTML) y comunicarse bidireccionalmente. *Nota:* Interactuar con el visor de PDFs nativo de Chrome para ir a una página concreta es muy limitado (sandboxing), aunque sí se puede controlar el scroll y estado de páginas web normales.
    * **Altium Designer:** Altium no expone fácilmente su contexto en tiempo real a ejecutables externos de forma directa. Para lograrlo (saber si estás en esquemático o PCB), hay que desarrollar un **Custom Plugin (Extensión DLL)** usando el Altium SDK (Delphi/C#) que corra *dentro* de Altium y acceda a `SchServer` y `PCBServer`. Este plugin podría comunicarse con OrbyGUI vía WebSockets o IPC para avisarle de cambios de contexto y que OrbyGUI cambie de página de perfil automáticamente.
    * **Word/Excel (Office):** Windows ofrece la interfaz **COM (ActiveX)**. Se pueden usar scripts (PowerShell) o pequeños binarios C# que se conecten a la instancia de Word/Excel, lean el estado actual del documento e intercepten eventos.
    * **¿Integrados o separados?** Dado que requieren componentes de terceros (una extensión en la Chrome Web Store, una DLL compilada para Altium, interacciones COM), **es mejor mantenerlos como plugins separados**. Incluirlos en la app base aumentaría el peso, la probabilidad de falsos positivos en antivirus y la complejidad de mantenimiento. OrbyGUI debería ofrecer un sistema de "Marketplace" o descargas bajo demanda.

### Ideas Estratégicas para la Tienda de Plugins (Marketplace)

Para hacer que el ecosistema Orby resulte muy atractivo "out-of-the-box" aprovechando su hardware único (10 OLEDs, encoders rotativos, rueda magnética alta resolución), se priorizarán los siguientes plugins de terceros:

* [ ] **Hardware Monitor (CPU / GPU / RAM):**

  * Leer estadísticas vía API de Windows (WMI/LibreHardwareMonitor).
  * Aprovechar las pantallas OLED para dibujar gráficos de barras, porcentajes y temperaturas en tiempo real. Un "dashboard" de hardware autónomo.
* [ ] **Control de Streaming (OBS Studio):**

  * Conectarse vía WebSocket a OBS.
  * Actualizar texto/iconos OLED según las escenas disponibles. Feedback de luces intermitentes en la OLED al estar grabando (REC) o transmitiendo.
* [ ] **Integración de Teletrabajo / Audio (Teams / Discord / Spotify):**

  * Muteo universal a nivel de sistema/aplicación, con un icono en la OLED mostrando si el micrófono está capturando audio para dar seguridad.
  * Uso de los encoders para controlar los niveles de volumen de aplicaciones específicas de manera separada (audio routing).
* [ ] **Desarrollo de la Tienda de Plugins (Marketplace):**

  * Crear la interfaz de usuario dentro de OrbyGUI para explorar, descargar e instalar plugins creados por la comunidad o de forma oficial.
  * Diseñar la arquitectura del repositorio/backend donde se alojarán los plugins para su descarga.
