jaestefaniah27/scroll_wheel/KEYBOARD_ORBY_V3/RASPBERRY_PROJECT/ORBY_V4/image/TODO/1786187446749.png

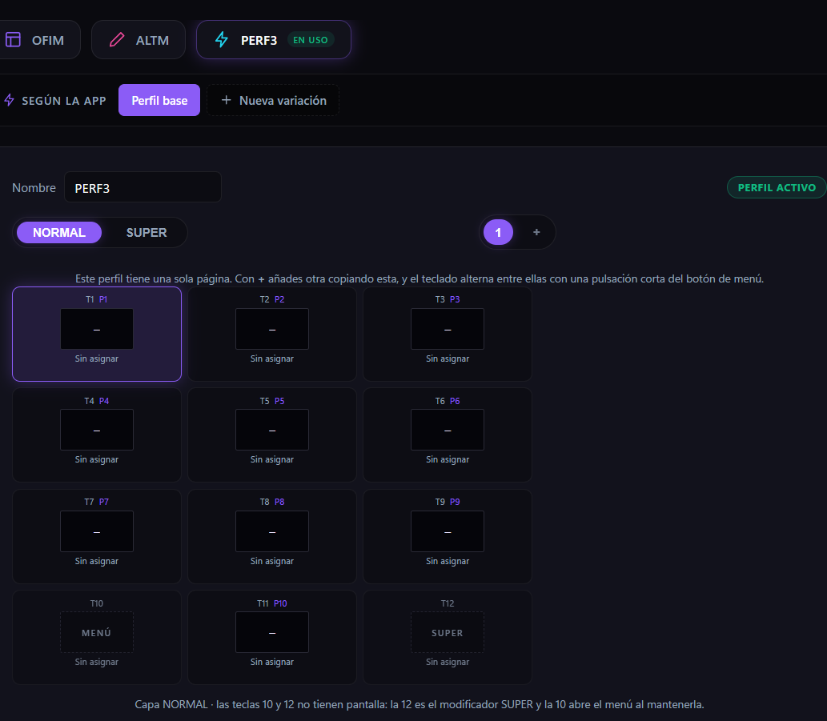
KEYBOARD_ORBY_V3/RASPBERRY_PROJECT/ORBY_V4/image/TODO/1786187446749.png
