jaestefaniah27/scroll_wheel/KEYBOARD_ORBY_V3/RASPBERRY_PROJECT/ORBY_V4/main.cpp

#include <stdio.h>
#include <string.h>
#include <stdlib.h>
#include <stdarg.h>
#include "pico/stdlib.h"
#include "pico/multicore.h"
#include "pico/rand.h"
#include "hardware/flash.h"
#include "hardware/sync.h"
#include "hardware/watchdog.h"
#include "pico/bootrom.h"
#include "bsp/board.h"
#include "tusb.h"
#include "class/cdc/cdc_device.h"
#include "orby_version.h"
#include "pinout.h"
#include "config_hash.h"
#include "hardware_encoder.h"
#include "hardware_oled.h"
#include "oled_ui.h"
#include "oled_anim.h"
#include "macro_store.h"
#include "oled_intro.h"
#include "hid_hires.h"
#include "hid_out.h"
#include "wheel_out.h"
#include "ptp_out.h"
#include "hardware_as5600.h"

// Las combinaciones con modificador (Ctrl+C y compañía) se envían como
// pulsación breve en vez de mantenerse mientras la tecla esté hundida.
//
// El motivo: un macropad manda atajos, y mantener Ctrl+C dos segundos no copia
// dos veces, solo deja el Ctrl puesto en el host. Con el Ctrl puesto, la rueda
// deja de hacer scroll y pasa a hacer zoom; con Shift, pasa a scroll
// horizontal. Se pierde el autorrepetido de combinaciones como Ctrl+Z: si lo
// prefieres al revés, pon esto a 0.
//
// Las teclas sueltas (sin modificador) y los modificadores a pelo (Ctrl sin
// tecla, para usarlos con el ratón) SÍ se mantienen.
#define ORBY_COMBO_AS_TAP 1

// Acciones especiales de tecla. Van en el campo `modifier` del mapeo, que para
// un atajo normal nunca llega tan alto, así que no hace falta cambiar la
// estructura ni migrar nada.
#define KEYACT_CONSUMER   0xFE  // keycode = índice de la tabla multimedia
#define KEYACT_GOTO_PAGE  0xFD  // keycode = número de página (1..MAX_PAGES)
#define KEYACT_PAGE_STATE 0xFC  // enseña la página actual y abre el gestor
#define KEYACT_MACRO      0xFB  // keycode = id de la macro; la ejecuta el PC, no el teclado

// Las dos teclas de sistema: no llevan pantalla y no envían atajos. Son índices
// base 0 dentro de key_pins, así que la tecla N está en N-1.
//   - SUPER, mantenida, cambia de capa todo el perfil (teclas, mandos y rueda).
//   - MENÚ, mantenida un segundo, abre el menú de perfiles en las pantallas.
// Antes estaban al revés (SUPER en la 10 y el menú en la 12); cambiarlas de
// sitio es cambiar estas dos líneas.
#define KEY_IDX_SUPER 11   // Tecla 12
#define KEY_IDX_MENU   9   // Tecla 10

// Mapeos nativos de teclado para las 12 teclas
struct KeyAction {
    uint8_t modifier;
    uint8_t keycode;
};

// ==========================================
// ACCIONES DE LOS MANDOS GIRATORIOS
// ==========================================
// Cubren los dos encoders EC11 y la rueda magnética. Antes estaban cableadas
// en el bucle principal (volumen y brillo fijos), así que no había forma de
// cambiarlas por perfil.
enum RotaryType : uint8_t {
    ROT_NONE = 0,
    ROT_CONSUMER,   // keycode = índice de la tabla de teclas de consumo
    ROT_KEY,        // modifier + keycode HID
    ROT_SCROLL_V,   // rueda vertical (bidireccional por sí misma)
    ROT_SCROLL_H,   // paneo horizontal AC Pan
    ROT_ZOOM,       // pellizco de touchpad (4.24); Ctrl + rueda si el host no lo admite
    // Navegación (4.15): para poder dejar libre la tecla de menú. ROT_PAGE es
    // bidireccional como los desplazamientos (una acción cubre los dos
    // sentidos: horario avanza de página, antihorario retrocede). ROT_MENU es
    // discreta, para el clic: keycode = qué menú abre (ROT_MENU_*).
    ROT_PAGE,
    ROT_MENU,
};
#define ROT_TYPE_LAST ROT_MENU

enum RotaryMenu : uint8_t {
    ROT_MENU_PROFILES = 0,  // selector de perfiles
    ROT_MENU_PAGES    = 1,  // gestor de páginas
    ROT_MENU_MAIN     = 2,  // menú principal (ajustes)
};

struct RotaryAction {
    uint8_t type;
    uint8_t modifier;
    uint8_t keycode;
};

// Índices de la tabla get_consumer_key_from_index(). Los del 1 al 6 se
// conservan tal cual para no invalidar los perfiles ya existentes; del 7 en
// adelante son los que necesitan los encoders configurables.
#define CONS_VOL_UP        7
#define CONS_VOL_DOWN      8
#define CONS_MUTE          9
#define CONS_BRIGHT_UP    10
#define CONS_BRIGHT_DOWN  11

// Huecos de acciones giratorias dentro de cada perfil. La lista se repite dos
// veces: 0-7 en capa normal y 8-15 con SUPER mantenida, igual que las teclas.
enum RotarySlot : uint8_t {
    ROT_ENC1_CW = 0, ROT_ENC1_CCW, ROT_ENC1_CLICK,
    ROT_ENC2_CW,     ROT_ENC2_CCW, ROT_ENC2_CLICK,
    ROT_WHEEL_CW,    ROT_WHEEL_CCW,
    ROT_LAYER_STRIDE
};
#define ROT_SLOT_COUNT (ROT_LAYER_STRIDE * 2)

// Índice del hueco giratorio según la capa activa.
static inline uint8_t rot_slot(uint8_t base, bool super) {
    return (uint8_t)(base + (super ? ROT_LAYER_STRIDE : 0));
}

// La sensibilidad de la rueda también es un ajuste del perfil, y con dos
// valores: uno por capa. Así un mismo perfil puede desplazar fino en normal y
// a saltos largos con SUPER.
#define SCROLL_DETENTS_MIN     3
#define SCROLL_DETENTS_MAX   240
#define SCROLL_DETENTS_DEFAULT 60

// ==========================================
// PÁGINAS
// ==========================================
// Una página es un juego completo de «lo que hace el teclado»: teclas,
// etiquetas, mandos, rueda e iconos. Un perfil tiene de una a MAX_PAGES y se
// alterna entre ellas con la pulsación corta del botón de menú, con una tecla de
// salto directo o desde el gestor de páginas.
//
// Cada página cuesta 260 bytes de RAM, así que multiplicarlas es barato. Lo que
// NO cabía eran los iconos (7680 bytes por página): por eso el banco de iconos
// se ha mudado a la Flash y se pinta directamente de ahí. Ver FLASH_OLED_OFFSET.
#define MAX_PAGES 4

struct Page {
    char oled_labels[20][8];    // 0-9 Normal, 10-19 SUPER
    KeyAction key_mappings[24]; // 0-11 Normal, 12-23 SUPER
    RotaryAction rotary[ROT_SLOT_COUNT];
    uint8_t scroll_detents[2];  // [0] normal, [1] SUPER
    uint8_t scroll_invert[2];
};

struct Profile {
    char    name[8];
    uint8_t page_count;         // 1..MAX_PAGES
    // Tramo del banco de iconos de la Flash que le pertenece. Es fijo mientras
    // el perfil viva: así borrar un perfil solo reordena metadatos, en vez de
    // obligar a arrastrar medio megabyte de iconos por la Flash.
    uint8_t oled_bank;
    uint8_t padding[2];
    Page    pages[MAX_PAGES];
};

// Cuántos perfiles caben. Los cuatro primeros son los de fábrica; el resto se
// crean desde la app con ADD_PROFILE o DUP_PROFILE.
#define MAX_PROFILES      16
// Cuántos perfiles puede tener activos el teclado (desde la 4.27). La Flash
// sigue reservando sitio para MAX_PROFILES: quien ya tenía más de nueve no
// pierde ninguno, pero no puede crear más hasta desactivar alguno (la app los
// guarda comprimidos en el archivo de perfiles, PSTORE_*).
#define MAX_ACTIVE_PROFILES 9
#define DEFAULT_PROFILES  4

// Los perfiles de fábrica se declaran sin páginas —solo nombre, etiquetas y
// teclas— y se copian a la página 0 al arrancar. Así los literales de abajo, que
// son 150 líneas de llaves anidadas, no hay que tocarlos al añadir páginas.
struct DefaultProfile {
    char name[8];
    char oled_labels[20][8];
    KeyAction key_mappings[24];
};

// Perfiles de fábrica. Se copian a `profiles` (RAM) al arrancar; la app de
// escritorio puede editar la copia en RAM y persistirla con SAVE_STATE.
const DefaultProfile default_profiles[DEFAULT_PROFILES] = {
    // OFIM (Ofimática y Productividad General)
    {
        "OFIM",
        {
            // Normal Labels (0-9)
            "COPY", "PAST", "CUT", "UNDO", "REDO", "ALL", "SAVE", "FIND", "CLSE", "SNAP",
            // SUPER Labels (10-19)
            "EXCL", "WORD", "BROW", "CALC", "TASK", "LOCK", "PLAY", "STOP", "NEXT", "PREV"
        },
        {
            // Normal Key Mappings (0-11)
            { KEYBOARD_MODIFIER_LEFTCTRL, HID_KEY_C }, // Tecla 1 -> Ctrl+C
            { KEYBOARD_MODIFIER_LEFTCTRL, HID_KEY_V }, // Tecla 2 -> Ctrl+V
            { KEYBOARD_MODIFIER_LEFTCTRL, HID_KEY_X }, // Tecla 3 -> Ctrl+X
            { KEYBOARD_MODIFIER_LEFTCTRL, HID_KEY_Z }, // Tecla 4 -> Ctrl+Z
            { KEYBOARD_MODIFIER_LEFTCTRL, HID_KEY_Y }, // Tecla 5 -> Ctrl+Y
            { KEYBOARD_MODIFIER_LEFTCTRL, HID_KEY_A }, // Tecla 6 -> Ctrl+A
            { KEYBOARD_MODIFIER_LEFTCTRL, HID_KEY_S }, // Tecla 7 -> Ctrl+S
            { KEYBOARD_MODIFIER_LEFTCTRL, HID_KEY_F }, // Tecla 8 -> Ctrl+F
            { KEYBOARD_MODIFIER_LEFTCTRL, HID_KEY_W }, // Tecla 9 -> Ctrl+W
            { 0,                          0         }, // Tecla 10 -> NADA (menu)
            { KEYBOARD_MODIFIER_LEFTGUI | KEYBOARD_MODIFIER_LEFTSHIFT, HID_KEY_S }, // Tecla 11 -> Win+Shift+S (OLED 10)
            { 0,                          0         }, // Tecla 12 -> NADA (SUPER)
            
            // SUPER Key Mappings (12-23)
            { KEYBOARD_MODIFIER_LEFTCTRL | KEYBOARD_MODIFIER_LEFTALT | KEYBOARD_MODIFIER_LEFTSHIFT, HID_KEY_E }, // Tecla 1 -> Excel (Ctrl+Alt+Shift+E)
            { KEYBOARD_MODIFIER_LEFTCTRL | KEYBOARD_MODIFIER_LEFTALT | KEYBOARD_MODIFIER_LEFTSHIFT, HID_KEY_W }, // Tecla 2 -> Word (Ctrl+Alt+Shift+W)
            { 0xFE,                       1         }, // Tecla 3 -> Browser (Consumer idx 1)
            { 0xFE,                       2         }, // Tecla 4 -> Calculator (Consumer idx 2)
            { KEYBOARD_MODIFIER_LEFTCTRL | KEYBOARD_MODIFIER_LEFTSHIFT, HID_KEY_ESCAPE }, // Tecla 5 -> Task Manager (Ctrl+Shift+Esc)
            { KEYBOARD_MODIFIER_LEFTGUI,  HID_KEY_L }, // Tecla 6 -> Lock PC (Win+L)
            { 0xFE,                       3         }, // Tecla 7 -> Play/Pause (Consumer idx 3)
            { 0xFE,                       4         }, // Tecla 8 -> Stop (Consumer idx 4)
            { 0xFE,                       5         }, // Tecla 9 -> Next (Consumer idx 5)
            { 0,                          0         }, // Tecla 10 -> NADA (menu)
            { 0xFE,                       6         }, // Tecla 11 -> Prev (Consumer idx 6)
            { 0,                          0         }  // Tecla 12 -> NADA (SUPER)
        }
    },
    // PHTS (Adobe Photoshop)
    {
        "PHTS",
        {
            // Normal Labels (0-9)
            "BRSH", "ERAS", "PENC", "UNDO", "REDO", "LASS", "CROP", "MOVE", "NEWL", "DUPL",
            // SUPER Labels (10-19)
            "ZOOM", "HAND", "TEXT", "GRAD", "PEN", "SHAP", "EYE", "SELC", "SLIC", "PATH"
        },
        {
            // Normal Key Mappings (0-11)
            { 0,                          HID_KEY_B }, // Brush (B)
            { 0,                          HID_KEY_E }, // Eraser (E)
            { 0,                          HID_KEY_N }, // Pencil (N)
            { KEYBOARD_MODIFIER_LEFTCTRL, HID_KEY_Z }, // Undo (Ctrl+Z)
            { KEYBOARD_MODIFIER_LEFTCTRL | KEYBOARD_MODIFIER_LEFTSHIFT, HID_KEY_Z }, // Redo (Ctrl+Shift+Z)
            { 0,                          HID_KEY_L }, // Lasso (L)
            { 0,                          HID_KEY_C }, // Crop (C)
            { 0,                          HID_KEY_V }, // Move (V)
            { KEYBOARD_MODIFIER_LEFTCTRL | KEYBOARD_MODIFIER_LEFTSHIFT, HID_KEY_N }, // New Layer (Ctrl+Shift+N)
            { 0,                          0         }, // Tecla 10 -> NADA (menu)
            { KEYBOARD_MODIFIER_LEFTCTRL, HID_KEY_J }, // Duplicate Layer (Ctrl+J)
            { 0,                          0         }, // Tecla 12 -> NADA (SUPER)
            
            // SUPER Key Mappings (12-23)
            { 0,                          HID_KEY_Z }, // Zoom (Z)
            { 0,                          HID_KEY_H }, // Hand (H)
            { 0,                          HID_KEY_T }, // Text (T)
            { 0,                          HID_KEY_G }, // Gradient (G)
            { 0,                          HID_KEY_P }, // Pen (P)
            { 0,                          HID_KEY_U }, // Shape (U)
            { 0,                          HID_KEY_I }, // Eyedropper (I)
            { 0,                          HID_KEY_M }, // Marquee Selection (M)
            { 0,                          HID_KEY_K }, // Slice (K)
            { 0,                          0         }, // Tecla 10 -> NADA (menu)
            { 0,                          HID_KEY_A }, // Path Selection (A)
            { 0,                          0         }  // Tecla 12 -> NADA (SUPER)
        }
    },
    // ALTM (Altium Designer)
    {
        "ALTM",
        {
            // Normal Labels (0-9)
            "WIRE", "PORT", "PAD", "UNDO", "REDO", "VIA", "MOVE", "TRAC", "FIT", "3D",
            // SUPER Labels (10-19)
            "SCH", "PCB", "LIB", "COMP", "GRID", "MEAS", "RULE", "ERC", "DRC", "GEN"
        },
        {
            // Normal Key Mappings (0-11)
            { 0,                          HID_KEY_W }, // Place Wire (W)
            { 0,                          HID_KEY_R }, // Place Port (R)
            { 0,                          HID_KEY_P }, // Place Pad (P)
            { KEYBOARD_MODIFIER_LEFTCTRL, HID_KEY_Z }, // Undo (Ctrl+Z)
            { KEYBOARD_MODIFIER_LEFTCTRL, HID_KEY_Y }, // Redo (Ctrl+Y)
            { 0,                          HID_KEY_V }, // Place Via (V)
            { 0,                          HID_KEY_M }, // Move (M)
            { 0,                          HID_KEY_T }, // Track (T)
            { 0,                          HID_KEY_F }, // View Fit (F)
            { 0,                          0         }, // Tecla 10 -> NADA (menu)
            { 0,                          HID_KEY_3 }, // 3D View (3)
            { 0,                          0         }, // Tecla 12 -> NADA (SUPER)
            
            // SUPER Key Mappings (12-23)
            { 0,                          HID_KEY_D }, // SCH Doc options (D)
            { KEYBOARD_MODIFIER_LEFTALT,  HID_KEY_D }, // PCB Options (Alt+D)
            { 0,                          HID_KEY_L }, // Library options (L)
            { KEYBOARD_MODIFIER_LEFTCTRL, HID_KEY_Z }, // Undo (Ctrl+Z)
            { KEYBOARD_MODIFIER_LEFTCTRL, HID_KEY_Y }, // Redo (Ctrl+Y)
            { 0,                          HID_KEY_G }, // Grid Toggle (G)
            { KEYBOARD_MODIFIER_LEFTCTRL, HID_KEY_M }, // Measure (Ctrl+M)
            { KEYBOARD_MODIFIER_LEFTALT,  HID_KEY_R }, // Design Rules (Alt+R)
            { KEYBOARD_MODIFIER_LEFTALT,  HID_KEY_D }, // Run DRC (Alt+D)
            { 0,                          0         }, // Tecla 10 -> NADA (menu)
            { KEYBOARD_MODIFIER_LEFTALT,  HID_KEY_O }, // Options (Alt+O)
            { 0,                          0         }  // Tecla 12 -> NADA (SUPER)
        }
    },
    // PREM (Adobe Premiere Pro)
    {
        "PREM",
        {
            // Normal Labels (0-9)
            "CUT", "SELC", "PLAY", "UNDO", "REDO", "MARK", "LINK", "RIPL", "EXPO", "NEST",
            // SUPER Labels (10-19)
            "SLIP", "SLID", "PEN", "HAND", "TEXT", "ZOOM", "TRIM", "RATE", "ROLL", "SPED"
        },
        {
            // Normal Key Mappings (0-11)
            { 0,                          HID_KEY_C }, // Razor Tool (C)
            { 0,                          HID_KEY_V }, // Selection Tool (V)
            { 0,                          HID_KEY_SPACE }, // Play/Pause (Space)
            { KEYBOARD_MODIFIER_LEFTCTRL, HID_KEY_Z }, // Undo (Ctrl+Z)
            { KEYBOARD_MODIFIER_LEFTCTRL, HID_KEY_Y }, // Redo (Ctrl+Y)
            { 0,                          HID_KEY_M }, // Marker (M)
            { KEYBOARD_MODIFIER_LEFTCTRL, HID_KEY_L }, // Link (Ctrl+L)
            { KEYBOARD_MODIFIER_LEFTSHIFT, HID_KEY_DELETE }, // Ripple Delete (Shift+Delete)
            { KEYBOARD_MODIFIER_LEFTCTRL, HID_KEY_M }, // Export (Ctrl+M)
            { 0,                          0         }, // Tecla 10 -> NADA (menu)
            { 0,                          HID_KEY_N }, // Nest (N)
            { 0,                          0         }, // Tecla 12 -> NADA (SUPER)
            
            // SUPER Key Mappings (12-23)
            { 0,                          HID_KEY_Y }, // Slip Tool (Y)
            { 0,                          HID_KEY_U }, // Slide Tool (U)
            { 0,                          HID_KEY_P }, // Pen Tool (P)
            { 0,                          HID_KEY_H }, // Hand Tool (H)
            { 0,                          HID_KEY_T }, // Type Tool (T)
            { 0,                          HID_KEY_Z }, // Zoom Tool (Z)
            { KEYBOARD_MODIFIER_LEFTSHIFT, HID_KEY_T }, // Trim (Shift+T)
            { 0,                          HID_KEY_R }, // Rate Stretch (R)
            { KEYBOARD_MODIFIER_LEFTALT,  HID_KEY_R }, // Roll Tool (Alt+R)
            { 0,                          0         }, // Tecla 10 -> NADA (menu)
            { KEYBOARD_MODIFIER_LEFTCTRL, HID_KEY_R }, // Speed (Ctrl+R)
            { 0,                          0         }  // Tecla 12 -> NADA (SUPER)
        }
    }
};

// Copia viva y editable de los perfiles. `profile_count` es cuántos existen de
// verdad; el resto del array son huecos libres.
Profile profiles[MAX_PROFILES];
volatile uint8_t profile_count = DEFAULT_PROFILES;

// ==========================================
// BITMAPS OLED PERSONALIZADOS
// ==========================================
// 20 huecos por página: 10 pantallas × 2 capas (Normal / SUPER). Con páginas,
// la unidad es (perfil, página): 16 × 4 = 64 tramos de 8 KB, medio megabyte.
//
// Eso NO cabe en RAM —serían 464 KB de los 264 KB del chip—, así que el banco
// vive solo en la Flash y se pinta directamente de ahí: el RP2040 la mapea en el
// espacio de direcciones (XIP), así que al SPI se le pasa un puntero a Flash y no
// hace falta ni copiar ni descomprimir nada.
//
// En RAM queda únicamente un búfer de preparación con el tramo que se está
// editando, para que un icono recién subido se vea antes de grabarlo.
#define OLED_FB_SIZE         360
#define OLED_KEY_SLOTS       20   // pantallas × capas (normal/SUPER)
#define OLED_PROFILE_SLOT    20   // hueco extra, solo en la página 0: icono del perfil
#define OLED_SLOTS           21
#define OLED_PAGE_STRIDE     7680 // 21*360 = 7560, redondeado a página de 256

// Un bit por hueco ocupado, por perfil y página. Vive en los ajustes: perderla
// equivale a perder los iconos.
static uint32_t custom_oled_mask[MAX_PROFILES][MAX_PAGES];

// Búfer de preparación: el tramo (perfil, página) que se está editando ahora.
// staging_dirty dice si tiene cambios sin grabar.
static uint8_t oled_staging[OLED_PAGE_STRIDE] __attribute__((aligned(4)));
static uint8_t staging_profile = 0xFF;   // 0xFF = vacío
static uint8_t staging_page    = 0xFF;
static bool    staging_dirty   = false;

// ==========================================
// ESTADO COMPARTIDO (SHARED STATE)
// ==========================================
enum AppMode {
    MODE_NORMAL,
    MODE_MENU_MAIN,
    MODE_MENU_PERF,
    MODE_MENU_REPO,
    MODE_MENU_INFO,
    MODE_MENU_PAGES,   // gestor de páginas: un número por pantalla
    MODE_MENU_SCROLL,  // invertir sentido de la rueda (normal / SUPER)
    MODE_MENU_RESET,   // confirmar reset de fábrica (por defecto en NO)
    MODE_GAME          // la app pinta las diez pantallas y lee las entradas (GAME:1)
};

// Pantallas del modo juego: las pinta la app con GAME_FB y Core 1 las copia en
// cada refresco. Core 0 escribe y Core 1 lee sin candado: lo peor que puede
// pasar es un fotograma a medias, que el siguiente repinta.
static uint8_t  game_fb[10][OLED_FB_SIZE];

// Fotograma binario en camino (GAME_BIN). Los bytes crudos van a un búfer
// aparte y solo se copian a game_fb cuando está entero: Core 1 puede estar
// leyendo game_fb en cualquier momento, y así no pinta una pantalla a medias.
static uint8_t  game_rx[10][OLED_FB_SIZE];
static uint16_t game_bin_mask = 0;     // qué pantallas trae (bit 0 = pantalla 1)
static uint32_t game_bin_need = 0;     // bytes que faltan; 0 = no hay fotograma en camino
static uint32_t game_bin_pos  = 0;     // byte dentro de la pantalla en curso
static uint32_t game_bin_scr  = 0;     // pantalla (0-9) que se está llenando
static uint32_t game_bin_seq  = 0;     // número del fotograma + 1; 0 = sin número
// Core 0 anota el último fotograma pedido y Core 1 el último que ha pintado
// de verdad: el acuse que ve la app sale del segundo, no de haber recibido.
static volatile uint32_t game_seq_req  = 0;
static volatile uint32_t game_seq_done = 0;
// Cuándo acabó Core 1 de mandar al panel ese fotograma, en µs del reloj del teclado
// (time_us_32). Va en el acuse junto con el número: con él y con el instante de cada
// tecla (KEY_EV en juego), un juego de reflejos mide de pantalla a dedo sin que entre
// en la cuenta ni el USB ni lo que tarde el PC en atender. Se escribe antes que
// game_seq_done, así que quien ve el número nuevo ve ya su instante.
static volatile uint32_t game_shown_us = 0;
// Último comando GAME_* recibido. Si la app se cuelga o se cierra a media
// partida, el teclado no puede quedarse con las pantallas secuestradas: pasados
// GAME_TIMEOUT_MS sin noticias vuelve solo al uso normal.
static uint32_t game_last_ms = 0;
static constexpr uint32_t GAME_TIMEOUT_MS = 3000;
// Entrar desde el selector de perfiles lo decide el teclado, y la app tiene que enterarse
// (GAME:OPEN) y contestar. Si la app está viva pero sin ventana, abrirla lleva unos
// segundos: hasta el primer GAME:1 se espera más, y solo si había app a la que esperar.
static bool game_espera_app = false;
static constexpr uint32_t GAME_ESPERA_MS = 12000;

// Opciones del menú principal, en el orden de sus pantallas. Ayuda entró en la
// 4.28 delante de Salir, que sigue siendo la última.
enum MainMenuOpt : uint8_t { MM_PROFILES, MM_SLEEP, MM_WHEEL, MM_RESET, MM_INFO, MM_HELP, MM_EXIT,
                             MAIN_MENU_OPTS };

// Qué tecla (índice base 0) hay debajo de cada pantalla. Las pantallas 1 a 9 van
// con las teclas 1 a 9, y la pantalla 10 con la tecla 11.
static inline uint8_t key_index_for_screen(uint8_t screen_num) {
    return (screen_num <= 9) ? (uint8_t)(screen_num - 1) : (uint8_t)10;
}

volatile AppMode current_mode = MODE_NORMAL;
volatile uint8_t active_profile_idx = 0;   // 0=OFIM, 1=PHTS, 2=ALTM, 3=PREM
volatile uint8_t active_page = 0;          // Página en uso del perfil activo
volatile uint8_t reposo_timeout_min = 5;    // 5 minutos por defecto (0=OFF)

// Qué hace la tecla 10. MENUKEY_MENU es lo de siempre (corta = página, larga =
// perfiles). MENUKEY_NORMAL la deja como una tecla más, con su acción de la
// página: entonces las páginas y el menú se llevan desde un encoder (ROT_PAGE,
// ROT_MENU). Es global y no del perfil a propósito: si fuera del perfil, uno
// sin encoder de menú dejaría al usuario sin forma de salir de él. Y aun así
// el menú principal sigue a mano siempre: los dos encoders pulsados 2 s.
//
// Se guarda en el byte de relleno de Settings, que las versiones anteriores
// graban a cero: un teclado que se actualiza conserva su tecla de menú.
#define MENUKEY_MENU   0
#define MENUKEY_NORMAL 1
volatile uint8_t menu_key_mode = MENUKEY_MENU;

static inline bool menu_key_is_menu() { return menu_key_mode == MENUKEY_MENU; }

// Sentido de los mandos (4.16). Un bit por mando: 0 encoder izquierdo, 1
// derecho, 2 rueda. Con el bit puesto, el giro llega al revés a todo lo demás
// (acciones, menús, páginas); la telemetría por CDC sigue siendo la del giro
// real, porque es lo que dibuja la app. Es global y no del perfil: cómo está
// montado o cómo le gusta girar a cada uno no cambia con la aplicación.
//
// Se guarda en el byte de relleno de Settings (que antes grababan a cero), así
// que los teclados que se actualizan arrancan con el sentido de siempre.
#define ROTINV_ENC1  0x01
#define ROTINV_ENC2  0x02
#define ROTINV_WHEEL 0x04
#define ROTINV_ALL   0x07
volatile uint8_t rot_invert_mask = 0;

// Desde la 4.18 los dos mandos giran por defecto al revés que el encoder:
// es el sentido que se acabó prefiriendo, y antes había que marcar «invertir»
// en cada teclado. El bit de rot_invert_mask sigue significando «al revés de
// lo normal», ahora sobre este sentido nuevo. La rueda no cambia.
#define ROTINV_FABRICA (ROTINV_ENC1 | ROTINV_ENC2)

static inline int girar(uint8_t bit, int delta) {
    return ((rot_invert_mask ^ ROTINV_FABRICA) & bit) ? -delta : delta;
}

// Mando que hace de menú: 0 ninguno, 1 izquierdo, 2 derecho. Es el hueco de la
// tecla 10 hecho mando. Girarlo cambia de página; mantenerlo pulsado abre el
// selector de perfiles (con SUPER, el gestor de páginas), se gira sin soltarlo
// hasta el elemento que se quiere y al soltarlo se elige. Lo que cada perfil
// tenga asignado a ese mando se ignora: es global por la misma razón que
// menu_key_mode, para no dejar a nadie sin forma de llegar a los menús.
volatile uint8_t menu_encoder = 0;

// El menú lo lleva UNA sola cosa: la tecla 10 o un mando. Con dueño, el
// «Abrir menú» que un perfil deje en cualquier otro mando se ignora: si no, dos
// gestos distintos abrirían el selector y el usuario no sabría cuál manda. Las
// páginas no se reparten así: ROT_PAGE vale siempre, en el mando que sea.
static inline bool menu_owned() { return menu_key_is_menu() || menu_encoder != 0; }

// Velocidad de las animaciones estilo Apple (oled_anim.h). Cada grupo tiene un
// ritmo base, en % del muelle "de fábrica" de SpringBoard (ver
// OledAnim::set_rate), y el usuario elige un % sobre esa base: 100 es lo que
// sale de fábrica. Las bases son las que se eligieron a mano con los sliders de
// la 4.8/4.9 mirando el teclado. Orden: OledAnim::Group.
static const uint16_t ANIM_BASE_PCT[OledAnim::G_COUNT] = {200, 65, 200, 140, 100};
volatile uint8_t anim_speed_pct[OledAnim::G_COUNT] = {100, 100, 100, 100, 100};

static void apply_anim_speed() {
    for (uint8_t g = 0; g < OledAnim::G_COUNT; g++)
        OledAnim::set_rate((OledAnim::Group)g, ANIM_BASE_PCT[g] * anim_speed_pct[g] / 10000.0f);
}

// Ritmo de fábrica para quien venga de un formato de ajustes sin anim_speed
// relativo: lo de antes era otra escala, y la base nueva ya es lo que eligió.
static void set_default_anim_speed() {
    for (uint8_t g = 0; g < OledAnim::G_COUNT; g++) anim_speed_pct[g] = 100;
}
volatile uint8_t selected_menu_idx = 0;     // Opción de menú activa (0 a 4)
volatile bool super_active = false;         // Estado de la tecla modificadora SUPER
volatile bool system_refresh_req = false;   // Flag para actualizar pantallas
// Qué pantallas van en negativo ahora mismo (bit 0 = pantalla 1). Core 0 la
// reconstruye entera en cada vuelta del bucle a partir de las teclas pulsadas,
// nunca por flancos sueltos: así no puede quedarse un bit encendido si un
// flanco se pierde. Core 1 la copia al SSD1306.
volatile uint16_t active_inversions = 0;

// Pulsación corta de la tecla de menú: por debajo de esto es ruido, no un dedo.
// Un toque humano no baja de 40 ms ni queriendo.
#define MENU_TAP_MIN_MS 30

// Cuántos pulsos demasiado cortos se han descartado en la tecla de menú. Es el
// termómetro de la avería: si sube sola con el teclado quieto, la línea de la
// tecla 10 está metiendo ruido y hay que mirar el hardware, no el firmware.
volatile uint32_t menu_tap_glitches = 0;

// --- Modo ayuda (firmware 4.28) ---
// Desde la 4.28 las teclas llevan el icono grande y sin nombre debajo (a 24x22
// con el nombre en 7 px no se leía ni lo uno ni lo otro). Para cuando un icono
// no basta, el modo ayuda cambia cada icono por su nombre en grande. Se entra
// con doble toque de SUPER o desde Ayuda en el menú principal.
volatile bool help_active = false;
static uint32_t help_since_ms = 0;
// Dos toques de SUPER más juntos que esto (de pulsación a pulsación) son un
// doble toque.
#define HELP_TAP_MS 300

// Cómo se sale, en Settings::help_exit. El 0 es 10 s porque ese byte era
// relleno a cero hasta la 4.27, y 10 s es lo de fábrica.
enum : uint8_t { HELPX_10S = 0, HELPX_KEY = 1, HELPX_5S = 2, HELPX_30S = 3, HELPX_MANUAL = 4 };
static uint8_t help_exit = HELPX_10S;

// Por el CDC va en segundos, que se entiende sin tabla: 0 al pulsar una tecla,
// 255 solo a mano.
static int help_exit_secs(uint8_t x) {
    switch (x) {
    case HELPX_KEY:    return 0;
    case HELPX_5S:     return 5;
    case HELPX_30S:    return 30;
    case HELPX_MANUAL: return 255;
    default:           return 10;
    }
}
static int help_exit_from_secs(int s) {
    switch (s) {
    case 0:   return HELPX_KEY;
    case 5:   return HELPX_5S;
    case 10:  return HELPX_10S;
    case 30:  return HELPX_30S;
    case 255: return HELPX_MANUAL;
    default:  return -1;
    }
}

// --- Encendido de las pantallas (reposo) ---
// Core 0 detecta la inactividad, pero quien manda al SSD1306 es Core 1: las
// pantallas y el bus SPI tienen un único dueño. Construir un segundo
// HardwareOled desde Core 0 dejaba OLED_RST a nivel bajo (gpio_init() pone la
// salida a cero), es decir, las diez pantallas en reset permanente.
volatile bool displays_on = true;
volatile bool display_power_req = false;

// OLED_REINIT: reinits pedidos por pantalla. Es a la vez el pedido y el
// contador que se devuelve (para ver si siempre es la 9). Solo lo escribe Core 0;
// Core 1 apunta aparte cuántos ha servido, así nadie pisa lo del otro.
volatile uint16_t oled_reinit_count[10] = {0};

// L4 de la fase 6: reset completo de las diez (RST común y secuencia de
// arranque), que Core 1 hace y luego repinta. Lo pide Core 0 al entrar en un
// juego y cuando la app aparece; oled_full_resets cuenta las veces.
volatile bool oled_full_reset_req = false;
volatile uint16_t oled_full_resets = 0;

// La intro de arranque la reproduce Core 1 y no se puede cortar: mientras dura,
// incluida la apertura de los iconos que la cierra, Core 0 no atiende teclas,
// mandos ni rueda. Empieza a true para que no quede un hueco entre que arranca
// el bucle de Core 0 y Core 1 empieza a reproducir. intro_skip_req solo la
// salta entera, tras un reinicio por watchdog.
volatile bool intro_running = true;
volatile bool intro_skip_req = false;
// Qué intro sale: 0 una al azar cada vez (la de fábrica: es lo que leen los
// ajustes de antes de la 4.25, que tenían relleno a cero en su sitio) y n la
// n-ésima de intro_clips, desde 1.
volatile uint8_t intro_variant = 0;

// La intro que toca ahora. Al azar, sin repetir la última que se ha visto
// mientras el teclado sigue encendido (al pedirla desde la app varias veces
// seguidas, cada vez sale otra).
static uint8_t intro_pick() {
    static int8_t ultima = -1;
    uint8_t n;
    if (intro_variant >= 1 && intro_variant <= INTRO_COUNT) {
        n = (uint8_t)(intro_variant - 1);
    } else if (INTRO_COUNT > 1 && ultima >= 0) {
        n = (uint8_t)((ultima + 1 + get_rand_32() % (INTRO_COUNT - 1)) % INTRO_COUNT);
    } else {
        n = (uint8_t)(get_rand_32() % INTRO_COUNT);
    }
    ultima = (int8_t)n;
    return n;
}
// La app pide verla otra vez para que se pueda elegir mirando el teclado.
volatile bool intro_play_req = false;
static bool intro_should_skip() { return intro_skip_req; }

// Latido de Core 1. Core 0 solo alimenta el watchdog mientras esto siga
// cambiando: si Core 1 se queda colgado con el bus SPI a medias, el teclado se
// reinicia en vez de quedarse mudo hasta que alguien lo desenchufe.
volatile uint32_t core1_heartbeat = 0;

// ==========================================
// CONFIGURACIÓN DE LA RUEDA DE SCROLL
// ==========================================
// Cuántos "detents" (clics de rueda de ratón clásica) equivalen a una vuelta
// completa de la rueda magnética. 60 = valor por defecto. Desde la versión 3.0
// ya no es un ajuste global: vive en el perfil, con un valor por capa, así que
// se consulta siempre a través de estos accesos.
// La página activa del perfil activo. Todo lo que el teclado hace «ahora mismo»
// sale de aquí.
static inline Page& cur_page() {
    return profiles[active_profile_idx].pages[active_page];
}

static inline uint8_t cur_scroll_detents() {
    uint8_t v = cur_page().scroll_detents[super_active ? 1 : 0];
    return (v < SCROLL_DETENTS_MIN || v > SCROLL_DETENTS_MAX) ? SCROLL_DETENTS_DEFAULT : v;
}

static inline bool cur_scroll_invert() {
    return cur_page().scroll_invert[super_active ? 1 : 0] != 0;
}

// ==========================================
// DISPOSICIÓN DE LA FLASH
// ==========================================
//   0 –  220 KB   el programa (con los iconos y la fuente de las pantallas)
//        ...libre...
//    896 – 1024 KB  secuencias que reproduce el propio teclado (desde la 4.14)
//   1024 – 1536 KB  banco de iconos: 64 tramos (16 perfiles × 4 páginas) de 8 KB
//   1536 – 1560 KB  ajustes: perfiles con sus páginas y las máscaras de iconos
//   1560 – 1592 KB  secuencias hasta la 4.13: solo se leen para traérselas
//        ...libre...
//   1600 – 1824 KB  copia de las macros del PC, dos bancos de 112 KB (macro_store.h)
//   1824 – 2048 KB  archivo de los perfiles desactivados, otros dos de 112 KB (desde la 4.27;
//                   hasta la 4.26 el banco 1 de macros ocupaba aquí 224 KB)
//
// El banco acaba justo donde empiezan los ajustes. Está debajo y no encima
// porque encima no cabía: 1536 + 512 se sale de los 2 MB del módulo.
//
// Con las páginas, la unidad del banco pasa de «un perfil» a «una página de un
// perfil», y el tramo que le toca a cada perfil se guarda en `Profile.oled_bank`
// en vez de ser su índice. Así borrar un perfil solo reordena metadatos: mover
// medio megabyte de iconos por la Flash llevaría segundos y gastaría ciclos de
// borrado a cambio de nada.
#define FLASH_OLED_OFFSET    (1024 * 1024)
#define FLASH_OLED_SLICE     (2 * FLASH_SECTOR_SIZE)  // 8 KB por (perfil, página)
#define FLASH_OLED_AT(bank, pg) \
    (FLASH_OLED_OFFSET + (((bank) * MAX_PAGES) + (pg)) * FLASH_OLED_SLICE)

#define FLASH_TARGET_OFFSET  (1536 * 1024)
#define FLASH_SETTINGS_SECTORS 6
#define FLASH_SETTINGS_BYTES (FLASH_SETTINGS_SECTORS * FLASH_SECTOR_SIZE)

// El banco no puede solaparse con los ajustes ni salirse de la Flash.
static_assert(FLASH_OLED_AT(MAX_PROFILES - 1, MAX_PAGES - 1) + FLASH_OLED_SLICE
                  <= FLASH_TARGET_OFFSET,
              "El banco de iconos se come la región de ajustes");
static_assert(FLASH_TARGET_OFFSET + FLASH_SETTINGS_BYTES <= PICO_FLASH_SIZE_BYTES,
              "Los ajustes se salen de la Flash del módulo");

// Disposiciones anteriores, solo para rescatar los iconos al actualizar. Hasta
// la versión 3.1 el banco iba detrás de los ajustes, con un tramo por perfil.
#define FLASH_OLED_OFFSET_V5 (FLASH_TARGET_OFFSET + 2 * FLASH_SECTOR_SIZE)
#define FLASH_OLED_AT_V5(p)  (FLASH_OLED_OFFSET_V5 + (p) * FLASH_OLED_SLICE)
#define FLASH_OLED_OFFSET_V3 (FLASH_TARGET_OFFSET + FLASH_SECTOR_SIZE)
#define FLASH_OLED_AT_V3(p)  (FLASH_OLED_OFFSET_V3 + (p) * FLASH_OLED_SLICE)

// Versiones del bloque de ajustes. Cada cambio de estructura necesita un magic
// nuevo, pero NO se descarta lo guardado: se migra campo a campo. Los bitmaps
// OLED viven en su propia región y sobreviven a todo esto, pero la máscara de
// huecos ocupados está aquí, así que perderla equivale a perder los iconos.
#define SETTINGS_MAGIC_V1 0xDEB001CE  // original: solo ajustes básicos
#define SETTINGS_MAGIC_V2 0xDEB00204  // + perfiles editables, scroll y bitmaps
#define SETTINGS_MAGIC_V3 0xDEB00205  // + acciones de encoders y rueda
#define SETTINGS_MAGIC_V4 0xDEB00300  // + nº de perfiles variable (tope 8), capa
                                      //   SUPER en los mandos y scroll por perfil
#define SETTINGS_MAGIC_V5 0xDEB00310  // + tope de 16 perfiles: los ajustes pasan
                                      //   a dos sectores y la región de bitmaps
                                      //   se desplaza uno
#define SETTINGS_MAGIC_V6 0xDEB00400  // + páginas por perfil: el banco de iconos
                                      //   se muda a 1024 KB con un tramo por
                                      //   (perfil, página) y sale de la RAM
#define SETTINGS_MAGIC_V7 0xDEB00410  // - current_brightness: el registro de
                                      //   contraste nunca hizo nada en esta
                                      //   placa (ver hardware_oled.h), campo
                                      //   eliminado
#define SETTINGS_MAGIC_V8 0xDEB00420  // + anim_speed: velocidad por grupo de
                                      //   las animaciones de oled_anim.h
#define SETTINGS_MAGIC    0xDEB00430  // anim_speed pasa a ser % sobre
                                      //   ANIM_BASE_PCT, no sobre el muelle de
                                      //   Apple: misma disposición, otra escala

// Diseños antiguos, conservados solo para poder leer lo ya grabado.
struct ProfileV2 {
    char name[8];
    char oled_labels[20][8];
    KeyAction key_mappings[24];
};

struct ProfileV3 {
    char name[8];
    char oled_labels[20][8];
    KeyAction key_mappings[24];
    RotaryAction rotary[ROT_LAYER_STRIDE];  // solo capa normal
};

struct SettingsV1 {
    uint32_t magic;
    uint8_t  active_profile_idx;
    uint8_t  current_brightness;
    uint8_t  reposo_timeout_min;
    uint8_t  padding;
};

struct SettingsV2 {
    uint32_t  magic;
    uint8_t   active_profile_idx;
    uint8_t   current_brightness;
    uint8_t   reposo_timeout_min;
    uint8_t   scroll_detents_per_rev;
    uint8_t   scroll_invert;
    uint8_t   padding[3];
    uint32_t  custom_oled_mask[4];
    ProfileV2 profiles[4];
};

struct SettingsV3 {
    uint32_t  magic;
    uint8_t   active_profile_idx;
    uint8_t   current_brightness;
    uint8_t   reposo_timeout_min;
    uint8_t   scroll_detents_per_rev;
    uint8_t   scroll_invert;
    uint8_t   padding[3];
    uint32_t  custom_oled_mask[4];
    ProfileV3 profiles[4];
};

// Perfil de las versiones 3.0 y 3.1: el de antes de las páginas. Se conserva
// para poder leer lo que ya está grabado en la Flash.
struct ProfileV5 {
    char name[8];
    char oled_labels[20][8];
    KeyAction key_mappings[24];
    RotaryAction rotary[ROT_SLOT_COUNT];
    uint8_t scroll_detents[2];
    uint8_t scroll_invert[2];
};

// Formato 3.0: mismo perfil, pero con tope de 8.
#define SETTINGS_V4_PROFILES 8
struct SettingsV4 {
    uint32_t  magic;
    uint8_t   active_profile_idx;
    uint8_t   current_brightness;
    uint8_t   reposo_timeout_min;
    uint8_t   profile_count;
    uint8_t   padding[4];
    uint32_t  custom_oled_mask[SETTINGS_V4_PROFILES];
    ProfileV5 profiles[SETTINGS_V4_PROFILES];
};

// Formato 3.1: tope de 16 perfiles, todavía sin páginas.
struct SettingsV5 {
    uint32_t  magic;
    uint8_t   active_profile_idx;
    uint8_t   current_brightness;
    uint8_t   reposo_timeout_min;
    uint8_t   profile_count;
    uint8_t   padding[4];
    uint32_t  custom_oled_mask[MAX_PROFILES];
    ProfileV5 profiles[MAX_PROFILES];
};

// Formato 4.0: idéntico al 4.1 salvo por current_brightness, que se guardaba
// pero nunca llegó a hacer nada en el hardware. Se conserva solo para poder
// leer lo ya grabado en la Flash de teclados en uso.
struct SettingsV6 {
    uint32_t magic;
    uint8_t  active_profile_idx;
    uint8_t  current_brightness;
    uint8_t  reposo_timeout_min;
    uint8_t  profile_count;
    uint8_t  active_page;
    uint8_t  padding[3];
    uint32_t custom_oled_mask[MAX_PROFILES][MAX_PAGES];
    Profile  profiles[MAX_PROFILES];
};

// Formato 4.1: idéntico al actual salvo por anim_speed, que no existía (todas
// las animaciones iban al ritmo de fábrica, 100%).
struct SettingsV7 {
    uint32_t magic;
    uint8_t  active_profile_idx;
    uint8_t  reposo_timeout_min;
    uint8_t  profile_count;
    uint8_t  active_page;
    uint8_t  padding[3];
    uint32_t custom_oled_mask[MAX_PROFILES][MAX_PAGES];
    Profile  profiles[MAX_PROFILES];
};

struct Settings {
    uint32_t magic;
    uint8_t  active_profile_idx;
    uint8_t  reposo_timeout_min;
    uint8_t  profile_count;
    uint8_t  active_page;
    // Era relleno hasta la 4.14, siempre a cero: por eso no hace falta magic
    // nuevo. Cero es MENUKEY_MENU, lo que hacía la tecla hasta entonces.
    uint8_t  menu_key_mode;
    // Relleno hasta la 4.15, siempre a cero: cero es «sin invertir» y «sin
    // mando de menú», lo que hacía el teclado hasta entonces.
    uint8_t  rot_invert_mask;
    uint8_t  menu_encoder;
    uint8_t  anim_speed[OledAnim::G_COUNT];  // % por grupo, ver OledAnim::Group
    // Relleno hasta la 4.24, siempre a cero: cero es una intro al azar.
    uint8_t  intro;
    // Relleno hasta la 4.27, siempre a cero: cero es HELPX_10S, lo de fábrica.
    uint8_t  help_exit;
    uint8_t  padding2[1];
    uint32_t custom_oled_mask[MAX_PROFILES][MAX_PAGES];
    Profile  profiles[MAX_PROFILES];
};

// El blob de ajustes se programa redondeado a página de 256 bytes.
#define SETTINGS_BLOB_SIZE (((sizeof(Settings) + FLASH_PAGE_SIZE - 1) / FLASH_PAGE_SIZE) * FLASH_PAGE_SIZE)

static uint8_t settings_blob[SETTINGS_BLOB_SIZE];

// Guardas de disposición: si los perfiles crecen y dejan de caber, hay que
// ampliar la región reservada en lugar de pisar el banco de iconos.
static_assert(SETTINGS_BLOB_SIZE <= FLASH_SETTINGS_BYTES,
              "Los ajustes ya no caben en la región reservada de Flash");
static_assert(OLED_SLOTS * OLED_FB_SIZE <= OLED_PAGE_STRIDE,
              "El stride por página no cubre sus 21 bitmaps");
static_assert(OLED_PAGE_STRIDE % FLASH_PAGE_SIZE == 0,
              "flash_range_program exige múltiplos de página");

// ==========================================
// SECUENCIAS (MACROS) QUE EJECUTA EL PROPIO TECLADO
// ==========================================
// Antes toda secuencia la ejecutaba el PC al recibir "MACRO:<id>" por CDC (ver
// trigger_macro más abajo), así que dejaban de funcionar en cuanto la app no
// estaba abierta. Los pasos que no dependen de saber nada del host —esperar,
// pulsar una tecla, mover el ratón un delta relativo, hacer clic— se guardan y
// reproducen aquí. Solo la posición ABSOLUTA del cursor (exige conocer la
// resolución/escala de la pantalla del PC, que el teclado no puede saber) sigue
// yendo por CDC: una secuencia que la use se queda en el camino viejo (ver
// trigger_macro: sin copia jugable en el teclado, avisa por CDC como antes).
//
// Eran 64 hasta la 4.13, y se quedaban cortas: hasta Orvy 1.1.3 la app no
// liberaba el id de una macro que ya no usa ninguna tecla (cambiar de pestaña,
// pegar una tecla o instalar un perfil de la biblioteca estrenan uno), así que
// con el uso los ids pasaban de 63. Una secuencia rehecha a partir de ahí estrenaba un id que el
// teclado no podía guardar, y aunque solo llevara teclas y clics se quedaba
// tachada sin la app (una configuración real ya iba por el id 160). La app lee
// este número del handshake (MAXMACROS), así que subirlo basta para que vuelvan
// a caber sin tocar la app. Se sube hasta el tope duro, 255: el id viaja en el
// keycode de la tecla, que es un byte.
#define MACRO_MAX_COUNT  255
// Cada paso "real" (tecla, clic, movimiento) que añade el editor se guarda con
// una espera delante (menos el primero), así que el tope efectivo de pasos
// jugables en el teclado es la mitad de este número, no el número entero.
#define MACRO_MAX_STEPS  48

enum MacroStepType : uint8_t {
    MSTEP_NONE      = 0,
    MSTEP_DELAY     = 1,  // a = milisegundos de espera
    MSTEP_KEY       = 2,  // a = modificador HID, b = keycode HID (pulsación breve)
    MSTEP_MOVE      = 3,  // a = dx, b = dy: desplazamiento relativo del ratón (-127..127)
    MSTEP_CLICK     = 4,  // a = botón: 0 izquierdo, 1 central, 2 derecho
    // a = dx, b = dy: desplazamiento desde la esquina inferior derecha hasta el
    // punto que se quería (normalmente números negativos o cero: la app calcula
    // x - ancho_pantalla, y - alto_pantalla al capturar la posición). El ratón
    // HID solo sabe mover en relativo, así que primero se manda un
    // desplazamiento positivo grande (más que cualquier escritorio real) para
    // que el sistema operativo lo recorte solo contra esa esquina —eso SIEMPRE
    // pasa, haga lo que haga la aceleración del puntero, porque el recorte es
    // lo último que se aplica— y desde esa esquina conocida se viaja en
    // relativo hasta el punto final.
    //
    // TODO(homing-absoluto): el reproductor manda exactamente lo que se le
    // pide —comprobado byte a byte con MACRO_TEST— pero el resultado en
    // pantalla depende del multiplicador de "velocidad del puntero" de
    // Windows (no de la aceleración/"mejorar precisión", eso no influye), que
    // no se puede leer ni anular desde aquí. Sin una calibración (mandar un
    // desplazamiento conocido, medir cuánto se movió de verdad y guardar el
    // factor en la app) la posición absoluta no es fiable, así que la app NO
    // sube pasos de este tipo por ahora (aparcado a petición del usuario). El
    // reproductor y el protocolo (SET_MACRO_STEP tipo 5, MACRO_TEST para
    // depurar) se dejan tal cual para retomarlo con la calibración.
    MSTEP_HOME_MOVE = 5,
    // a, b y gap llevan un carácter cada uno: (modificador << 8) | keycode HID, y
    // 0 es "aquí se acaba". Tres por paso, y no una tecla por paso, porque las
    // secuencias tienen 48 pasos y un texto con esperas entre letras no cabría
    // ni en la mitad. Qué tecla da cada carácter lo decide la app según la
    // distribución del teclado del PC (src/web/text-keys.mjs): el teclado solo
    // las pulsa. Un firmware anterior salta este tipo sin hacer nada, por eso
    // la app no sube texto sin la bandera MACROTEXT.
    MSTEP_TEXT      = 6,
};

struct MacroStep {
    uint8_t type;
    int16_t a;
    int16_t b;
    // Solo se usan en MSTEP_KEY y MSTEP_CLICK (ver sameStep en profiles.js):
    // repetir el mismo paso `repeat` veces, con `gap` ms de espera entre cada
    // una, sin que cuente como pasos de más ni en la lista ni contra
    // MACRO_MAX_STEPS. En el resto de tipos se suben en 1/0 y no se miran.
    uint8_t repeat;
    int16_t gap;
};

struct FlashMacro {
    uint8_t   step_count;
    MacroStep steps[MACRO_MAX_STEPS];
};

// Copia viva y editable, igual que `profiles`: lo que se reproduce sale de
// aquí, y la Flash es solo persistencia entre arranques.
static FlashMacro macros[MACRO_MAX_COUNT];

// Con 255 secuencias (120 KB) ya no caben en su hueco de antes, entre los
// ajustes y el almacén de macros (40 KB), así que se mudan al hueco libre que hay
// debajo del banco de iconos. El programa ocupa unos 680 KB desde la 4.26, casi
// todo intros a 120 fps (orby_intro_data.h, unos 450 KB), y tiene que acabar
// antes de los 896 KB donde empieza esto: el enlazador no lo comprueba.
#define FLASH_MACROS_OFFSET  (FLASH_OLED_OFFSET - FLASH_MACROS_BYTES)
#define FLASH_MACROS_SECTORS 32
#define FLASH_MACROS_BYTES   (FLASH_MACROS_SECTORS * FLASH_SECTOR_SIZE)
// Otra firma que la de la 4.13: lo que hubiera en este hueco de antes (nada que
// escribiera este firmware) no se puede tomar por secuencias.
#define MACROS_MAGIC 0xDEB0AC11

// Hasta la 4.13: 64 secuencias detrás de los ajustes. Solo se lee, para traerse
// las del usuario al arrancar por primera vez con este firmware.
#define FLASH_MACROS_OFFSET_V1 (FLASH_TARGET_OFFSET + FLASH_SETTINGS_BYTES)
#define MACROS_MAGIC_V1        0xDEB0AC10
#define MACRO_MAX_COUNT_V1     64

// En Flash: la firma y detrás `macros` tal cual. Se escribe sector a sector
// desde la propia copia viva en vez de montar antes el bloque entero en otro
// búfer: ese búfer serían otros 120 KB de RAM, solo para guardar.
#define MACROS_FLASH_LEN     (sizeof(uint32_t) + sizeof(macros))
#define MACROS_FLASH_SECTORS ((MACROS_FLASH_LEN + FLASH_SECTOR_SIZE - 1) / FLASH_SECTOR_SIZE)
static uint8_t macros_sector[FLASH_SECTOR_SIZE];

static_assert(FLASH_MACROS_OFFSET % FLASH_SECTOR_SIZE == 0,
              "La región de las secuencias tiene que empezar en un sector");
static_assert(MACROS_FLASH_LEN <= FLASH_MACROS_BYTES,
              "Las secuencias ya no caben en su región reservada de Flash");
static_assert(MACRO_MAX_COUNT <= 255,
              "El id de una macro viaja en el keycode de la tecla, que es un byte");
static_assert(FLASH_MACROS_OFFSET_V1 + sizeof(uint32_t) + MACRO_MAX_COUNT_V1 * sizeof(FlashMacro)
                  <= FLASH_TARGET_OFFSET + FLASH_SETTINGS_BYTES + 8 * FLASH_SECTOR_SIZE,
              "El formato viejo ocupaba sus 8 sectores, ni uno más");

// Solo se reescriben los sectores que han cambiado. Son 31, y borrarlos todos
// de una vez era más de un segundo con las interrupciones cortadas (USB y
// pantallas parados) en cada guardado automático, casi siempre para dejar lo
// mismo: lo normal es que cambie una secuencia, o ninguna. De paso la Flash
// gasta ciclos de borrado solo donde hace falta.
//
// El sector 0, el de la firma, va el último: si se va la luz en el primer
// guardado tras actualizar, la región nueva se queda sin firma y el arranque
// siguiente vuelve a leer las de la 4.13, en vez de dar por buena una a medias.
static void save_macros() {
    const uint32_t magic = MACROS_MAGIC;
    const uint8_t* src = (const uint8_t*)macros;

    for (uint32_t k = 1; k <= MACROS_FLASH_SECTORS; k++) {
        const uint32_t sec  = k % MACROS_FLASH_SECTORS;
        const uint32_t base = sec * FLASH_SECTOR_SIZE;
        for (uint32_t i = 0; i < FLASH_SECTOR_SIZE; i++) {
            const uint32_t at = base + i;
            macros_sector[i] = at < sizeof(magic)    ? ((const uint8_t*)&magic)[at]
                             : at < MACROS_FLASH_LEN ? src[at - sizeof(magic)]
                             : 0;
        }
        if (memcmp(macros_sector, (const uint8_t*)(XIP_BASE + FLASH_MACROS_OFFSET + base),
                   FLASH_SECTOR_SIZE) == 0) continue;

        tud_task();
        watchdog_update();
        const bool lock = multicore_lockout_victim_is_initialized(1);
        uint32_t ints = save_and_disable_interrupts();
        if (lock) multicore_lockout_start_blocking();
        flash_range_erase(FLASH_MACROS_OFFSET + base, FLASH_SECTOR_SIZE);
        flash_range_program(FLASH_MACROS_OFFSET + base, macros_sector, FLASH_SECTOR_SIZE);
        if (lock) multicore_lockout_end_blocking();
        restore_interrupts(ints);
    }
}

static void load_macros() {
    memset(macros, 0, sizeof(macros));
    if (*(const uint32_t*)(XIP_BASE + FLASH_MACROS_OFFSET) == MACROS_MAGIC) {
        memcpy(macros, (const uint8_t*)(XIP_BASE + FLASH_MACROS_OFFSET + sizeof(uint32_t)), sizeof(macros));
    } else if (*(const uint32_t*)(XIP_BASE + FLASH_MACROS_OFFSET_V1) == MACROS_MAGIC_V1) {
        // Mismo FlashMacro, solo cambian sitio y cuántas caben: las 64 de antes
        // pasan a ser las 64 primeras. Se quedan en RAM hasta el próximo
        // SAVE_STATE, que ya las escribe en la región nueva; mientras tanto se
        // vuelven a leer de la vieja en cada arranque, que sigue intacta.
        memcpy(macros, (const uint8_t*)(XIP_BASE + FLASH_MACROS_OFFSET_V1 + sizeof(uint32_t)),
               MACRO_MAX_COUNT_V1 * sizeof(FlashMacro));
    }
    // Un recuento imposible (Flash borrada a 0xFF bajo una firma buena) haría
    // que el reproductor leyera pasos fuera del array: esa secuencia se da por
    // vacía y la ejecuta el PC hasta que la app la vuelva a subir.
    for (uint16_t i = 0; i < MACRO_MAX_COUNT; i++) {
        if (macros[i].step_count > MACRO_MAX_STEPS) memset(&macros[i], 0, sizeof(macros[i]));
    }
}

// ==========================================
// ALMACÉN DE LAS MACROS DEL PC (ver include/macro_store.h)
// ==========================================
static_assert(FLASH_MACROS_OFFSET + FLASH_MACROS_BYTES <= FLASH_OLED_OFFSET,
              "Las secuencias del teclado pisan el banco de iconos");
static_assert(FLASH_MACROS_OFFSET_V1 + 8 * FLASH_SECTOR_SIZE <= MStore::OFFSET,
              "El almacén de macros pisa las secuencias de la 4.13, que aún se leen");
static_assert(MStore::PS_OFFSET + 2 * MStore::BANK <= PICO_FLASH_SIZE_BYTES,
              "El archivo de perfiles se sale de la Flash del módulo");
static_assert(MStore::PAGE == FLASH_PAGE_SIZE && MStore::SECTOR == FLASH_SECTOR_SIZE,
              "macro_store.h asume la página y el sector de la Flash del RP2040");

static const uint8_t* mstore_read(uint32_t off) {
    return (const uint8_t*)(XIP_BASE + off);
}

// Las dos operaciones de Flash con Core 1 apartado, como write_oled_slice.
static void mstore_erase(uint32_t off, uint32_t len) {
    const bool lock = multicore_lockout_victim_is_initialized(1);
    uint32_t ints = save_and_disable_interrupts();
    if (lock) multicore_lockout_start_blocking();
    flash_range_erase(off, len);
    if (lock) multicore_lockout_end_blocking();
    restore_interrupts(ints);
}

static void mstore_program(uint32_t off, const uint8_t* data, uint32_t len) {
    const bool lock = multicore_lockout_victim_is_initialized(1);
    uint32_t ints = save_and_disable_interrupts();
    if (lock) multicore_lockout_start_blocking();
    flash_range_program(off, data, len);
    if (lock) multicore_lockout_end_blocking();
    restore_interrupts(ints);
}

// El almacén se revisa al arrancar, antes de que exista el USB: ahí solo toca
// alimentar el perro guardián.
static void mstore_idle() {
    if (tud_inited()) tud_task();
    watchdog_update();
}

static const MStore::Ops MSTORE_OPS = { mstore_read, mstore_erase, mstore_program, mstore_idle };
static MStore::Store mstore(MSTORE_OPS);
// Perfiles desactivados, comprimidos por la app (firmware 4.27).
static MStore::Store pstore(MSTORE_OPS, MStore::PROFILES);

// ==========================================
// ACCESO A LOS ICONOS
// ==========================================
// Un icono se lee de la Flash mapeada, salvo que su página sea la que se está
// editando: entonces sale del búfer de preparación, para que un icono recién
// subido se vea en la pantalla antes de grabarlo.
static inline bool staging_holds(uint8_t profile, uint8_t page) {
    return staging_profile == profile && staging_page == page;
}

static inline uint32_t oled_bank_of(uint8_t profile) {
    return profiles[profile].oled_bank;
}

static const uint8_t* oled_slot_ptr(uint8_t profile, uint8_t page, uint8_t slot) {
    if (staging_holds(profile, page)) return &oled_staging[slot * OLED_FB_SIZE];
    return (const uint8_t*)(XIP_BASE + FLASH_OLED_AT(oled_bank_of(profile), page)
                            + slot * OLED_FB_SIZE);
}

static inline bool oled_slot_used(uint8_t profile, uint8_t page, uint8_t slot) {
    return (custom_oled_mask[profile][page] & (1u << slot)) != 0;
}

// Graba el búfer de preparación en su tramo de Flash. Se llama al terminar de
// editar una página y antes de empezar con otra.
static void flush_oled_staging();

// Deja en el búfer la página indicada, leyéndola de la Flash, después de grabar
// la que hubiera antes.
static void load_oled_staging(uint8_t profile, uint8_t page) {
    if (staging_holds(profile, page)) return;
    flush_oled_staging();
    memcpy(oled_staging,
           (const uint8_t*)(XIP_BASE + FLASH_OLED_AT(oled_bank_of(profile), page)),
           OLED_PAGE_STRIDE);
    staging_profile = profile;
    staging_page    = page;
    staging_dirty   = false;
}

// ==========================================
// HUELLA DE LA CONFIGURACIÓN (CRC32)
// ==========================================
// La serialización canónica y el CRC viven en include/config_hash.h, compartidos
// con la prueba del PC (tools/test/test_config_hash.cpp) y espejados en la app
// (OrbyGUI/src/hash.js). Aquí solo se enganchan a los datos del firmware.
//
// Los iconos salen del búfer de preparación si su página es la que se está
// editando, así que uno recién subido y todavía sin grabar ya cuenta: la app
// también lo tiene en su modelo.
static uint32_t crc32_profile(uint8_t idx) {
    const Profile& p = profiles[idx];
    uint8_t pages = p.page_count;
    if (pages < 1) pages = 1;
    if (pages > MAX_PAGES) pages = MAX_PAGES;

    return crc32_profile_of(
        p.name, pages, p.pages,
        [idx](uint8_t pg) { return custom_oled_mask[idx][pg]; },
        [idx](uint8_t pg, uint8_t slot) { return oled_slot_ptr(idx, pg, slot); },
        // Un perfil lleno son 28 KB de bitmaps: se refresca el perro guardián
        // por página para que un GET_HASH con todo ocupado no lo dispare.
        []() { watchdog_update(); });
}

// Deja en `out` la huella de cada perfil y devuelve la global.
static uint32_t crc32_snapshot(uint32_t* out) {
    for (uint8_t i = 0; i < profile_count; i++) out[i] = crc32_profile(i);
    return crc32_snapshot_of((uint8_t)profile_count, (uint8_t)reposo_timeout_min, out);
}

// Los perfiles de fábrica solo declaran teclas y etiquetas; las acciones
// giratorias se rellenan aquí para no repetirlas en los cuatro literales.
static void apply_default_rotaries(Page& p) {
    p.rotary[ROT_ENC1_CW]    = { ROT_CONSUMER, 0, CONS_VOL_UP };
    p.rotary[ROT_ENC1_CCW]   = { ROT_CONSUMER, 0, CONS_VOL_DOWN };
    p.rotary[ROT_ENC1_CLICK] = { ROT_CONSUMER, 0, CONS_MUTE };
    p.rotary[ROT_ENC2_CW]    = { ROT_CONSUMER, 0, CONS_BRIGHT_UP };
    p.rotary[ROT_ENC2_CCW]   = { ROT_CONSUMER, 0, CONS_BRIGHT_DOWN };
    p.rotary[ROT_ENC2_CLICK] = { ROT_NONE, 0, 0 };
    p.rotary[ROT_WHEEL_CW]   = { ROT_SCROLL_V, 0, 0 };
    p.rotary[ROT_WHEEL_CCW]  = { ROT_SCROLL_V, 0, 0 };
    // La capa SUPER arranca igual que la normal: quien no la toque no nota el
    // cambio, y quien la edite obtiene dos juegos de mandos en un solo perfil.
    for (uint8_t s = 0; s < ROT_LAYER_STRIDE; s++) {
        p.rotary[ROT_LAYER_STRIDE + s] = p.rotary[s];
    }
}

static void apply_default_scroll(Page& p) {
    p.scroll_detents[0] = SCROLL_DETENTS_DEFAULT;
    p.scroll_detents[1] = SCROLL_DETENTS_DEFAULT;
    p.scroll_invert[0]  = 0;
    p.scroll_invert[1]  = 0;
}

// Página en blanco: teclas sin atajo y pantallas sin etiqueta. Antes se rellenaban
// con "T1".."T10" y había que borrarlas una a una antes de poder usarla; se parte
// del lienzo vacío, que es lo que se espera al crear algo nuevo.
// Los mandos sí conservan sus valores por defecto: una página que llega con la
// rueda y los encoders muertos no es un lienzo, es una avería.
static void make_blank_page(Page& pg) {
    memset(&pg, 0, sizeof(pg));
    apply_default_rotaries(pg);
    apply_default_scroll(pg);
}

// Perfil recién creado desde la app: una sola página, en blanco.
static void make_blank_profile(Profile& p, uint8_t number, uint8_t bank) {
    memset(&p, 0, sizeof(p));
    snprintf(p.name, sizeof(p.name), "PERF%u", (unsigned)number);
    p.page_count = 1;
    p.oled_bank  = bank;
    make_blank_page(p.pages[0]);
}

void load_defaults() {
    memset(profiles, 0, sizeof(profiles));
    profile_count = DEFAULT_PROFILES;
    for (int i = 0; i < DEFAULT_PROFILES; i++) {
        Profile& p = profiles[i];
        memcpy(p.name, default_profiles[i].name, sizeof(p.name));
        p.page_count = 1;
        p.oled_bank  = (uint8_t)i;
        // Los literales de fábrica solo traen etiquetas y teclas, y van a la
        // página 0; el resto de páginas no existe todavía.
        memcpy(p.pages[0].oled_labels, default_profiles[i].oled_labels,
               sizeof(p.pages[0].oled_labels));
        memcpy(p.pages[0].key_mappings, default_profiles[i].key_mappings,
               sizeof(p.pages[0].key_mappings));
        apply_default_rotaries(p.pages[0]);
        apply_default_scroll(p.pages[0]);
    }
    // Los perfiles que aún no existen se quedan con su tramo de banco reservado,
    // para que al crearlos no haya que buscar hueco.
    for (int i = DEFAULT_PROFILES; i < MAX_PROFILES; i++) profiles[i].oled_bank = (uint8_t)i;

    memset(custom_oled_mask, 0, sizeof(custom_oled_mask));
    staging_profile = staging_page = 0xFF;
    staging_dirty = false;
    active_profile_idx = 0;
    active_page = 0;
    reposo_timeout_min = 5;
    menu_key_mode = MENUKEY_MENU;
    rot_invert_mask = 0;
    menu_encoder = 0;
    help_exit = HELPX_10S;
    set_default_anim_speed();
}

// Graba un tramo del banco. Es la única función que escribe iconos en la Flash.
static void write_oled_slice(uint8_t bank, uint8_t page, const uint8_t* src) {
    tud_task();
    watchdog_update(); // borrar y programar 8 KB ronda los 120 ms

    // La migración escribe iconos desde load_settings(), que corre ANTES de
    // lanzar Core 1: pedirle entonces que se aparte bloquearía para siempre
    // esperando a un core que todavía no existe.
    const bool lock = multicore_lockout_victim_is_initialized(1);

    uint32_t ints = save_and_disable_interrupts();
    if (lock) multicore_lockout_start_blocking();
    flash_range_erase(FLASH_OLED_AT(bank, page), FLASH_OLED_SLICE);
    flash_range_program(FLASH_OLED_AT(bank, page), src, OLED_PAGE_STRIDE);
    if (lock) multicore_lockout_end_blocking();
    restore_interrupts(ints);
}

static void flush_oled_staging() {
    if (!staging_dirty || staging_profile >= MAX_PROFILES) return;
    write_oled_slice(oled_bank_of(staging_profile), staging_page, oled_staging);
    staging_dirty = false;
}

void save_settings() {
    // Primero los iconos pendientes: si se cortara la corriente a medias, es
    // mejor tener los iconos sin la máscara que la máscara sin los iconos.
    flush_oled_staging();

    Settings* s = (Settings*)settings_blob;
    memset(settings_blob, 0, sizeof(settings_blob));

    s->magic                  = SETTINGS_MAGIC;
    s->active_profile_idx     = active_profile_idx;
    s->reposo_timeout_min     = reposo_timeout_min;
    s->profile_count          = profile_count;
    s->active_page            = active_page;
    s->menu_key_mode          = menu_key_mode;
    s->rot_invert_mask        = rot_invert_mask;
    s->menu_encoder           = menu_encoder;
    // memcpy no admite un origen volatile: se copia campo a campo.
    for (uint8_t g = 0; g < OledAnim::G_COUNT; g++) s->anim_speed[g] = anim_speed_pct[g];
    s->intro                  = intro_variant;
    s->help_exit              = help_exit;
    memcpy(s->custom_oled_mask, custom_oled_mask, sizeof(custom_oled_mask));
    memcpy(s->profiles, profiles, sizeof(profiles));

    tud_task();
    watchdog_update();
    const bool lock = multicore_lockout_victim_is_initialized(1);
    uint32_t ints = save_and_disable_interrupts();
    if (lock) multicore_lockout_start_blocking();
    flash_range_erase(FLASH_TARGET_OFFSET, FLASH_SETTINGS_BYTES);
    flash_range_program(FLASH_TARGET_OFFSET, settings_blob, SETTINGS_BLOB_SIZE);
    if (lock) multicore_lockout_end_blocking();
    restore_interrupts(ints);
}

// Migración del banco de iconos: los formatos anteriores lo tenían detrás de los
// ajustes con un tramo por perfil, y ahora está en 1024 KB con un tramo por
// (perfil, página). Los iconos viejos pasan a ser la página 0 de cada perfil.
//
// Las dos zonas son disjuntas (origen 1544-1672 KB, destino 1024-1536 KB), así
// que se puede copiar en orden y sin solapamientos. Eso sí: hay que copiar ANTES
// de reescribir los ajustes, porque la región de ajustes nueva sí pisa la del
// banco viejo.
static void migrate_oled_bank(uint32_t old_slice_at(uint8_t), uint8_t count) {
    for (uint8_t p = 0; p < count && p < MAX_PROFILES; p++) {
        if (!custom_oled_mask[p][0]) continue;
        memcpy(oled_staging, (const uint8_t*)(XIP_BASE + old_slice_at(p)), OLED_PAGE_STRIDE);
        write_oled_slice(profiles[p].oled_bank, 0, oled_staging);
    }
    staging_profile = staging_page = 0xFF;
    staging_dirty = false;
}

static uint32_t old_slice_v5(uint8_t p) { return FLASH_OLED_AT_V5(p); }
static uint32_t old_slice_v3(uint8_t p) { return FLASH_OLED_AT_V3(p); }

// Convierte un perfil sin páginas en uno de una sola página.
static void adopt_v5_profile(Profile& dst, const ProfileV5& src, uint8_t bank) {
    memset(&dst, 0, sizeof(dst));
    memcpy(dst.name, src.name, sizeof(dst.name));
    dst.page_count = 1;
    dst.oled_bank  = bank;
    memcpy(dst.pages[0].oled_labels,  src.oled_labels,  sizeof(dst.pages[0].oled_labels));
    memcpy(dst.pages[0].key_mappings, src.key_mappings, sizeof(dst.pages[0].key_mappings));
    memcpy(dst.pages[0].rotary,       src.rotary,       sizeof(dst.pages[0].rotary));
    dst.pages[0].scroll_detents[0] = src.scroll_detents[0];
    dst.pages[0].scroll_detents[1] = src.scroll_detents[1];
    dst.pages[0].scroll_invert[0]  = src.scroll_invert[0];
    dst.pages[0].scroll_invert[1]  = src.scroll_invert[1];
}

static void sanitize_loaded() {
    if (profile_count < 1) profile_count = 1;
    if (profile_count > MAX_PROFILES) profile_count = MAX_PROFILES;
    if (active_profile_idx >= profile_count) active_profile_idx = 0;

    // Los tramos del banco tienen que ser válidos y no repetirse: dos perfiles
    // compartiendo tramo se pisarían los iconos.
    bool taken[MAX_PROFILES] = { false };
    for (uint8_t i = 0; i < MAX_PROFILES; i++) {
        uint8_t b = profiles[i].oled_bank;
        if (b >= MAX_PROFILES || taken[b]) {
            for (uint8_t c = 0; c < MAX_PROFILES; c++) {
                if (!taken[c]) { b = c; break; }
            }
            profiles[i].oled_bank = b;
        }
        taken[b] = true;
    }

    for (uint8_t i = 0; i < MAX_PROFILES; i++) {
        if (profiles[i].page_count < 1) profiles[i].page_count = 1;
        if (profiles[i].page_count > MAX_PAGES) profiles[i].page_count = MAX_PAGES;

        for (uint8_t pg = 0; pg < MAX_PAGES; pg++) {
            for (uint8_t l = 0; l < 2; l++) {
                uint8_t d = profiles[i].pages[pg].scroll_detents[l];
                if (d < SCROLL_DETENTS_MIN || d > SCROLL_DETENTS_MAX) {
                    profiles[i].pages[pg].scroll_detents[l] = SCROLL_DETENTS_DEFAULT;
                }
                profiles[i].pages[pg].scroll_invert[l] =
                    profiles[i].pages[pg].scroll_invert[l] ? 1 : 0;
            }
        }
    }

    if (active_page >= profiles[active_profile_idx].page_count) active_page = 0;
}

void load_settings() {
    const uint32_t magic = *(const uint32_t*)(XIP_BASE + FLASH_TARGET_OFFSET);

    if (magic == SETTINGS_MAGIC) {
        const Settings* s = (const Settings*)(XIP_BASE + FLASH_TARGET_OFFSET);
        active_profile_idx     = s->active_profile_idx;
        reposo_timeout_min     = s->reposo_timeout_min;
        profile_count          = s->profile_count;
        active_page            = s->active_page;
        menu_key_mode          = (s->menu_key_mode == MENUKEY_NORMAL) ? MENUKEY_NORMAL : MENUKEY_MENU;
        rot_invert_mask        = s->rot_invert_mask & ROTINV_ALL;
        menu_encoder           = (s->menu_encoder <= 2) ? s->menu_encoder : 0;
        // Teclados de la 4.16 al 4.18 podían guardar los dos a la vez.
        if (menu_encoder) menu_key_mode = MENUKEY_NORMAL;
        for (uint8_t g = 0; g < OledAnim::G_COUNT; g++) anim_speed_pct[g] = s->anim_speed[g];
        // Una intro que este firmware no trae (bajado de versión): al azar.
        intro_variant          = (s->intro <= INTRO_COUNT) ? s->intro : 0;
        help_exit              = (s->help_exit <= HELPX_MANUAL) ? s->help_exit : HELPX_10S;
        memcpy(profiles, s->profiles, sizeof(profiles));
        memcpy(custom_oled_mask, s->custom_oled_mask, sizeof(custom_oled_mask));
        sanitize_loaded();
        return;
    }

    // Formato 4.8/4.9: la misma disposición, pero anim_speed contaba sobre el
    // muelle de Apple. Esos valores son justo los que pasaron a ser la base, así
    // que traducirlos daría ~100 de todas formas: se arranca en 100.
    if (magic == SETTINGS_MAGIC_V8) {
        const Settings* s = (const Settings*)(XIP_BASE + FLASH_TARGET_OFFSET);
        active_profile_idx     = s->active_profile_idx;
        reposo_timeout_min     = s->reposo_timeout_min;
        profile_count          = s->profile_count;
        active_page            = s->active_page;
        set_default_anim_speed();
        memcpy(profiles, s->profiles, sizeof(profiles));
        memcpy(custom_oled_mask, s->custom_oled_mask, sizeof(custom_oled_mask));
        sanitize_loaded();
        save_settings();
        return;
    }

    // Formato 4.1: mismos campos que el actual salvo por anim_speed, que no
    // existía (no había nada que elegir: todo iba al 100%). Al venir de ahí se
    // adopta el nuevo ritmo de fábrica, más rápido en lo que no era ya bueno:
    // nadie había tenido ocasión de ajustarlo a mano.
    if (magic == SETTINGS_MAGIC_V7) {
        const SettingsV7* s = (const SettingsV7*)(XIP_BASE + FLASH_TARGET_OFFSET);
        active_profile_idx     = s->active_profile_idx;
        reposo_timeout_min     = s->reposo_timeout_min;
        profile_count          = s->profile_count;
        active_page            = s->active_page;
        set_default_anim_speed();
        memcpy(profiles, s->profiles, sizeof(profiles));
        memcpy(custom_oled_mask, s->custom_oled_mask, sizeof(custom_oled_mask));
        sanitize_loaded();
        save_settings();
        return;
    }

    // Formato 4.0: mismos campos que el actual salvo por current_brightness,
    // que se descarta (nunca hizo nada en el hardware).
    if (magic == SETTINGS_MAGIC_V6) {
        const SettingsV6* s = (const SettingsV6*)(XIP_BASE + FLASH_TARGET_OFFSET);
        active_profile_idx     = s->active_profile_idx;
        reposo_timeout_min     = s->reposo_timeout_min;
        profile_count          = s->profile_count;
        active_page            = s->active_page;
        set_default_anim_speed();
        memcpy(profiles, s->profiles, sizeof(profiles));
        memcpy(custom_oled_mask, s->custom_oled_mask, sizeof(custom_oled_mask));
        sanitize_loaded();
        save_settings();
        return;
    }

    // --- Formatos sin páginas (3.0 y 3.1) ---
    // Lo guardado se convierte en la página 0 de cada perfil, y sus iconos se
    // copian del banco viejo al nuevo ANTES de reescribir los ajustes: la región
    // de ajustes nueva se solapa con la del banco antiguo.
    if (magic == SETTINGS_MAGIC_V5 || magic == SETTINGS_MAGIC_V4) {
        const bool v5 = (magic == SETTINGS_MAGIC_V5);
        const SettingsV5* s5 = (const SettingsV5*)(XIP_BASE + FLASH_TARGET_OFFSET);
        const SettingsV4* s4 = (const SettingsV4*)(XIP_BASE + FLASH_TARGET_OFFSET);

        active_profile_idx = v5 ? s5->active_profile_idx : s4->active_profile_idx;
        reposo_timeout_min = v5 ? s5->reposo_timeout_min : s4->reposo_timeout_min;
        profile_count      = v5 ? s5->profile_count      : s4->profile_count;
        active_page        = 0;
        set_default_anim_speed();

        const uint8_t count = v5 ? MAX_PROFILES : SETTINGS_V4_PROFILES;
        memset(profiles, 0, sizeof(profiles));
        memset(custom_oled_mask, 0, sizeof(custom_oled_mask));
        for (uint8_t i = 0; i < MAX_PROFILES; i++) {
            if (i < count) {
                adopt_v5_profile(profiles[i], v5 ? s5->profiles[i] : s4->profiles[i], i);
                custom_oled_mask[i][0] = v5 ? s5->custom_oled_mask[i] : s4->custom_oled_mask[i];
            } else {
                profiles[i].oled_bank = i;
            }
        }
        sanitize_loaded();
        // El banco viejo de la 3.1 iba dos sectores detrás de los ajustes; el de
        // la 3.0, uno.
        migrate_oled_bank(v5 ? old_slice_v5 : old_slice_v3, count);
        // Se graba ya en el formato nuevo: si no, la migración se repetiría en
        // cada arranque y reescribiría los iconos una y otra vez.
        save_settings();
        return;
    }

    if (magic == SETTINGS_MAGIC_V3) {
        // Formato anterior a los perfiles variables: cuatro perfiles con los
        // mandos en una sola capa y un scroll global. Se conserva todo y se
        // duplica la capa normal en SUPER, que es el comportamiento previo.
        const SettingsV3* s = (const SettingsV3*)(XIP_BASE + FLASH_TARGET_OFFSET);
        active_profile_idx = s->active_profile_idx;
        reposo_timeout_min = s->reposo_timeout_min;
        profile_count      = 4;
        set_default_anim_speed();
        memset(profiles, 0, sizeof(profiles));
        memset(custom_oled_mask, 0, sizeof(custom_oled_mask));
        memcpy(custom_oled_mask, s->custom_oled_mask, sizeof(s->custom_oled_mask));

        for (int i = 0; i < MAX_PROFILES; i++) profiles[i].oled_bank = (uint8_t)i;
        for (int i = 0; i < 4; i++) {
            Page& pg = profiles[i].pages[0];
            profiles[i].page_count = 1;
            memcpy(profiles[i].name, s->profiles[i].name, sizeof(profiles[i].name));
            memcpy(pg.oled_labels,  s->profiles[i].oled_labels,  sizeof(pg.oled_labels));
            memcpy(pg.key_mappings, s->profiles[i].key_mappings, sizeof(pg.key_mappings));
            for (uint8_t r = 0; r < ROT_LAYER_STRIDE; r++) {
                pg.rotary[r] = s->profiles[i].rotary[r];
                pg.rotary[ROT_LAYER_STRIDE + r] = s->profiles[i].rotary[r];
            }
            pg.scroll_detents[0] = s->scroll_detents_per_rev;
            pg.scroll_detents[1] = s->scroll_detents_per_rev;
            pg.scroll_invert[0]  = s->scroll_invert;
            pg.scroll_invert[1]  = s->scroll_invert;
        }
        sanitize_loaded();
        migrate_oled_bank(old_slice_v3, 4);
        save_settings();
        return;
    }

    if (magic == SETTINGS_MAGIC_V2) {
        // Formato anterior a las acciones giratorias. Se conserva todo lo que
        // costó trabajo —perfiles, etiquetas, atajos y la máscara de iconos— y
        // solo se rellenan de fábrica los mandos, que antes no existían.
        const SettingsV2* s = (const SettingsV2*)(XIP_BASE + FLASH_TARGET_OFFSET);
        active_profile_idx = s->active_profile_idx;
        reposo_timeout_min = s->reposo_timeout_min;
        profile_count      = 4;
        set_default_anim_speed();
        memset(profiles, 0, sizeof(profiles));
        memset(custom_oled_mask, 0, sizeof(custom_oled_mask));
        for (int i = 0; i < 4; i++) custom_oled_mask[i][0] = s->custom_oled_mask[i];

        for (int i = 0; i < MAX_PROFILES; i++) profiles[i].oled_bank = (uint8_t)i;
        for (int i = 0; i < 4; i++) {
            Page& pg = profiles[i].pages[0];
            profiles[i].page_count = 1;
            memcpy(profiles[i].name, s->profiles[i].name, sizeof(profiles[i].name));
            memcpy(pg.oled_labels,  s->profiles[i].oled_labels,  sizeof(pg.oled_labels));
            memcpy(pg.key_mappings, s->profiles[i].key_mappings, sizeof(pg.key_mappings));
            apply_default_rotaries(pg);
            apply_default_scroll(pg);
            pg.scroll_detents[0] = s->scroll_detents_per_rev;
            pg.scroll_detents[1] = s->scroll_detents_per_rev;
            pg.scroll_invert[0]  = s->scroll_invert;
            pg.scroll_invert[1]  = s->scroll_invert;
        }
        sanitize_loaded();
        migrate_oled_bank(old_slice_v3, 4);
        save_settings();
        return;
    }

    if (magic == SETTINGS_MAGIC_V1) {
        // El formato original solo guardaba tres ajustes; el resto es de fábrica.
        const SettingsV1* s = (const SettingsV1*)(XIP_BASE + FLASH_TARGET_OFFSET);
        load_defaults();
        active_profile_idx = s->active_profile_idx;
        reposo_timeout_min = s->reposo_timeout_min;
        sanitize_loaded();
        return; // no había bitmaps guardados que rescatar
    }

    load_defaults();
}

// ==========================================
// GESTIÓN DE PERFILES (CREAR / DUPLICAR / BORRAR)
// ==========================================
// Cada perfil se queda con su tramo del banco de iconos (`oled_bank`) mientras
// viva, así que reordenar la lista solo mueve metadatos: los iconos se quedan
// donde están y se siguen encontrando por el tramo, no por el índice. Antes, con
// el banco indexado por posición, borrar un perfil obligaba a arrastrar el tramo
// de todos los siguientes; ahora eso serían medio megabyte de Flash por nada.

// Copia los iconos de un perfil a otro, página a página. Es lo único que sí
// obliga a escribir en la Flash, y solo pasa al duplicar un perfil a mano.
static void oled_copy_profile(uint8_t dst, uint8_t src) {
    flush_oled_staging();
    for (uint8_t pg = 0; pg < MAX_PAGES; pg++) {
        custom_oled_mask[dst][pg] = custom_oled_mask[src][pg];
        if (!custom_oled_mask[src][pg]) continue;
        memcpy(oled_staging,
               (const uint8_t*)(XIP_BASE + FLASH_OLED_AT(profiles[src].oled_bank, pg)),
               OLED_PAGE_STRIDE);
        write_oled_slice(profiles[dst].oled_bank, pg, oled_staging);
    }
    staging_profile = staging_page = 0xFF;
    staging_dirty = false;
}

// Devuelve el índice del perfil nuevo, o -1 si ya no caben más.
static int profile_add(int copy_from) {
    if (profile_count >= MAX_ACTIVE_PROFILES) return -1;

    uint8_t idx = profile_count;
    // El tramo de banco que ya tenía reservado este hueco se conserva: los
    // huecos libres arrastran su tramo desde load_defaults / sanitize_loaded.
    uint8_t bank = profiles[idx].oled_bank;

    if (copy_from >= 0 && copy_from < (int)profile_count) {
        profiles[idx] = profiles[copy_from];
        profiles[idx].oled_bank = bank;   // el suyo, no el del original
        profile_count = idx + 1;
        oled_copy_profile(idx, (uint8_t)copy_from);
    } else {
        make_blank_profile(profiles[idx], (uint8_t)(idx + 1), bank);
        for (uint8_t pg = 0; pg < MAX_PAGES; pg++) custom_oled_mask[idx][pg] = 0;
        profile_count = idx + 1;
    }
    return idx;
}
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
int main() {
    board_init();
    tusb_init();
    HidOut::init();

    // Margen para que se asienten las alimentaciones antes de arrancar el resto.
    // Antes eran dos segundos de sleep_ms() a secas, sin llamar ni una vez a
    // tud_task(): el dispositivo estaba en el bus pero no contestaba a la
    // enumeración, lo que la retrasaba y de vez en cuando la hacía fallar.
    // Ahora se atiende al USB mientras se espera, y basta con mucho menos.
    #define BOOT_SETTLE_MS 300
    absolute_time_t settle = make_timeout_time_ms(BOOT_SETTLE_MS);
    while (!time_reached(settle)) {
        tud_task();
        sleep_us(500);
    }

    // Cargar configuración de Flash
    load_settings();
    load_macros();
    mstore.scan();
    // Antes de que nadie escriba en el archivo de perfiles: ahí empezaba el banco 1
    // de macros hasta la 4.26.
    MStore::adopt_wide_bank(MSTORE_OPS, mstore);
    pstore.scan();

    // Si venimos de un reinicio por watchdog, algo se colgó: nada de intro, a
    // dejar el teclado operativo cuanto antes.
    if (watchdog_caused_reboot()) intro_skip_req = true;

    multicore_launch_core1(core1_entry);

    // Ocho segundos, que es el tope del RP2040. Lo alimenta el bucle de abajo
    // solo si Core 1 sigue dando señales de vida: así un cuelgue de cualquiera
    // de los dos cores acaba en un reinicio en vez de en un teclado muerto que
    // hay que desenchufar.
    watchdog_enable(8000, 1);

    HardwareEncoder rueda_izq(pio0, Pins::ENC1_A, 1);
    HardwareEncoder rueda_der(pio0, Pins::ENC2_A, -1);

    HardwareAs5600 wheel;
    wheel.init();

    const uint8_t key_pins[12] = {
        Pins::KEY_1, Pins::KEY_2, Pins::KEY_3, Pins::KEY_4,
        Pins::KEY_5, Pins::KEY_6, Pins::KEY_7, Pins::KEY_8,
        Pins::KEY_9, Pins::KEY_10, Pins::KEY_11, Pins::KEY_12
    };
    bool last_key_state[12] = {false};

    // Antirrebote de las doce teclas, por integración: un nivel nuevo solo se da
    // por bueno cuando se ha leído igual durante KEY_DEBOUNCE_US seguidos.
    //
    // Antes era por bloqueo (se aceptaba el primer flanco al instante y se
    // ignoraban los 5 ms siguientes). Eso filtra el rebote de un contacto sano,
    // pero da por buena una pulsación entera a partir de ruido: basta un único
    // muestreo distinto para dar la tecla por pulsada, y otro 5 ms después para
    // darla por soltada. Con la tecla de menú, cuya pulsación corta cambia de
    // página, cada pareja de picos así era un cambio de página, y como el cambio
    // repinta las diez pantallas —y ese repintado es justo la fuente de ruido—
    // se realimentaba: el teclado se quedaba pasando páginas a unas decenas por
    // segundo sin que nadie lo tocara.
    //
    // Cuesta 5 ms de latencia en el flanco (antes, cero). Es lo que hace
    // cualquier teclado y no se nota; la alternativa era seguir tragándose picos.
    // key_edge_us[i] guarda desde cuándo el pin discrepa del estado filtrado: un
    // solo muestreo que vuelva a coincidir pone el reloj a cero y el pico muere.
    #define KEY_DEBOUNCE_US 5000
    bool     key_stable[12]  = {false};
    uint32_t key_edge_us[12] = {0};
    // El instante en que el pin empezó a cambiar, antes del antirrebote: es cuando se
    // pulsó de verdad. Los 5 ms del filtro no deben contar como tiempo de reacción.
    uint32_t key_flanco_us[12] = {0};

    // Lo que se tocó durante la intro no cuenta hasta soltarlo: una tecla
    // sujeta al acabar no debe dispararse sola, ni una soltada después debe
    // valer como pulsación corta de la tecla de menú. 0-11 teclas, 12-13
    // pulsadores de los mandos.
    bool held_in_intro[14] = {false};

    const uint8_t key_to_oled[12] = {
        1, 2, 3, 4, 5, 6, 7, 8, 9,  // Teclas 1-9 → OLED 1-9
        0,   // Tecla 10 → sin pantalla
        10,  // Tecla 11 → OLED 10
        0    // Tecla 12 → sin pantalla
    };

    for (int i = 0; i < 12; i++) {
        gpio_init(key_pins[i]);
        gpio_set_dir(key_pins[i], GPIO_IN);
        gpio_pull_up(key_pins[i]);
    }

    gpio_init(Pins::ENC1_SW);
    gpio_set_dir(Pins::ENC1_SW, GPIO_IN);
    gpio_pull_up(Pins::ENC1_SW);

    gpio_init(Pins::ENC2_SW);
    gpio_set_dir(Pins::ENC2_SW, GPIO_IN);
    gpio_pull_up(Pins::ENC2_SW);

    int enc1_sw_debounce_cnt = 0;
    bool stable_enc1_sw_state = false;
    int enc2_sw_debounce_cnt = 0;
    bool stable_enc2_sw_state = false;

    // Control de inactividad / reposo
    uint32_t last_activity_time = to_ms_since_boot(get_absolute_time());
    bool is_sleeping = false;

    // Telemetría de la rueda, agregada a 20 Hz
    int32_t  wheel_tel_accum = 0;
    uint32_t last_wheel_tel  = last_activity_time;

    // Aquí había una segunda instancia de HardwareOled para despertar las
    // pantallas. Se ha quitado: su constructor reinicializaba los pines y el
    // SPI que Core 1 está usando, y dejaba OLED_RST a nivel bajo. El reposo se
    // pide ahora con display_power_req.

    uint32_t last_hb = 0, last_hb_ms = to_ms_since_boot(get_absolute_time());

    while (true) {
        tud_task();

        // Alimentar el watchdog, pero solo si Core 1 sigue vivo. Durante la
        // intro no se le exige latido porque está dentro del reproductor.
        {
            uint32_t ms = to_ms_since_boot(get_absolute_time());
            if (core1_heartbeat != last_hb) { last_hb = core1_heartbeat; last_hb_ms = ms; }
            if (intro_running || (uint32_t)(ms - last_hb_ms) < 3000) watchdog_update();
        }


        // --- PROCESAR COMANDOS CDC (POLLING) ---
        if (tud_cdc_available()) cdc_pump_rx();

        // Acuse de los fotogramas de juego: lo que Core 1 ha pintado de verdad.
        {
            static uint32_t acked = 0;
            const uint32_t done = game_seq_done;
            if (done != acked) {
                acked = done;
                if (done) cdc_printf("GAME:SHOWN:%lu:%lu\n", (unsigned long)(done - 1), (unsigned long)game_shown_us);
            }
        }

        uint32_t now = to_ms_since_boot(get_absolute_time());
        bool activity_detected = false;

        // La intro no se corta ni deja hacer nada: se apunta lo que esté
        // pulsado y se vacían mandos y rueda para que su giro no se acumule y
        // salga todo de golpe al acabar. Los comandos del CDC sí se atienden.
        if (intro_running) {
            for (int i = 0; i < 12; i++)
                if (!gpio_get(key_pins[i])) held_in_intro[i] = true;
            if (!gpio_get(Pins::ENC1_SW)) held_in_intro[12] = true;
            if (!gpio_get(Pins::ENC2_SW)) held_in_intro[13] = true;
            (void)rueda_izq.get_delta();
            (void)rueda_der.get_delta();
            int32_t descartado;
            (void)wheel.poll(descartado);
            last_activity_time = now;
            sleep_us(250);
            continue;
        }

        // Volver al uso normal, por el camino que sea, cierra el «menú de un
        // mando»: el siguiente que se abra decide de nuevo cómo se abrió.
        if (current_mode == MODE_NORMAL) menu_from_rotary = false;

        // Los mandos que mantienen un menú lo abren al cumplirse el tiempo.
        if (enc_hold_tick(1, now)) activity_detected = true;
        if (enc_hold_tick(2, now)) activity_detected = true;
        help_tick(now);

        // Red de seguridad del modo juego: si la app se cuelga o se cierra con
        // las pantallas secuestradas, el teclado vuelve solo al uso normal.
        if (current_mode == MODE_GAME
            && (uint32_t)(now - game_last_ms) >= (game_espera_app ? GAME_ESPERA_MS : GAME_TIMEOUT_MS)) {
            current_mode = MODE_NORMAL;
            push_system_refresh();
            cdc_printf("GAME:TIMEOUT\n");
            cdc_printf("MODE:NORMAL\n");
        }

        // Las teclas tachadas dependen de si la app está delante, y eso cambia
        // sin que nadie mande nada: al cerrarla se cae el DTR, y si se cuelga
        // caduca su aviso. Sin este repaso las pantallas se quedarían mintiendo
        // hasta el siguiente refresco por otro motivo.
        {
            static bool host_app_pintado = false;
            const bool viva = host_app_alive();
            if (viva != host_app_pintado) {
                host_app_pintado = viva;
                if (current_mode == MODE_NORMAL) push_system_refresh();
            }
        }

        // --- ENCODER IZQUIERDO (VOLUMEN) ---
        const int delta_izq_real = rueda_izq.get_delta();
        if (delta_izq_real != 0) {
            activity_detected = true;
            // La telemetría lleva el giro real; lo que hace el teclado, el ajustado.
            const int delta_izq = girar(ROTINV_ENC1, delta_izq_real);

            if (current_mode == MODE_NORMAL || current_mode == MODE_GAME) {
                // Telemetría serie
                char tel[32];
                int len = snprintf(tel, sizeof(tel), "ENC:1:%d\n", delta_izq_real);
                tud_cdc_n_write(0, tel, len);
                tud_cdc_n_write_flush(0);

                if (current_mode == MODE_GAME) {
                    // En un juego el giro solo se cuenta: no hace volumen ni páginas.
                } else if (menu_encoder == 1) {
                    page_steps(delta_izq);
                } else {
                    // Acción configurada en el perfil activo y la capa en curso
                    const Page& p = cur_page();
                    apply_rotary(p.rotary[rot_slot(ROT_ENC1_CW,  super_active)],
                                 p.rotary[rot_slot(ROT_ENC1_CCW, super_active)], delta_izq);
                }
            } else {
                menu_turn(delta_izq);
            }
        }

        // --- ENCODER DERECHO (BRILLO) ---
        const int delta_der_real = rueda_der.get_delta();
        if (delta_der_real != 0) {
            activity_detected = true;
            const int delta_der = girar(ROTINV_ENC2, delta_der_real);

            if (current_mode == MODE_NORMAL || current_mode == MODE_GAME) {
                // Telemetría serie
                char tel[32];
                int len = snprintf(tel, sizeof(tel), "ENC:2:%d\n", delta_der_real);
                tud_cdc_n_write(0, tel, len);
                tud_cdc_n_write_flush(0);

                if (current_mode == MODE_GAME) {
                    // Solo se cuenta, como el otro mando.
                } else if (menu_encoder == 2) {
                    page_steps(delta_der);
                } else {
                    // Acción configurada en el perfil activo y la capa en curso
                    const Page& p = cur_page();
                    apply_rotary(p.rotary[rot_slot(ROT_ENC2_CW,  super_active)],
                                 p.rotary[rot_slot(ROT_ENC2_CCW, super_active)], delta_der);
                }
            } else {
                menu_turn(delta_der);
            }
        }

        // --- BOTONES DE LOS ENCODERS (DEBOUNCED) ---
        bool raw_enc1_sw = !gpio_get(Pins::ENC1_SW);
        if (held_in_intro[12]) { if (!raw_enc1_sw) held_in_intro[12] = false; raw_enc1_sw = false; }
        if (raw_enc1_sw != stable_enc1_sw_state) {
            enc1_sw_debounce_cnt++;
            if (enc1_sw_debounce_cnt >= 15) {
                stable_enc1_sw_state = raw_enc1_sw;
                enc1_sw_debounce_cnt = 0;
                activity_detected = true;
                
                // Telemetría serie
                char tel[32];
                int len = snprintf(tel, sizeof(tel), "ENC_SW:1:%d\n", stable_enc1_sw_state ? 1 : 0);
                tud_cdc_n_write(0, tel, len);
                tud_cdc_n_write_flush(0);

                // En un juego el clic solo se cuenta (ENC_SW, arriba). Sin esta
                // guarda enc_press lo trataría como el clic de un menú.
                if (current_mode != MODE_GAME) {
                    if (stable_enc1_sw_state) enc_press(1, now);
                    else                      enc_release(1);
                }
            }
        } else {
            enc1_sw_debounce_cnt = 0;
        }

        bool raw_enc2_sw = !gpio_get(Pins::ENC2_SW);
        if (held_in_intro[13]) { if (!raw_enc2_sw) held_in_intro[13] = false; raw_enc2_sw = false; }
        if (raw_enc2_sw != stable_enc2_sw_state) {
            enc2_sw_debounce_cnt++;
            if (enc2_sw_debounce_cnt >= 15) {
                stable_enc2_sw_state = raw_enc2_sw;
                enc2_sw_debounce_cnt = 0;
                activity_detected = true;

                // Telemetría serie
                char tel[32];
                int len = snprintf(tel, sizeof(tel), "ENC_SW:2:%d\n", stable_enc2_sw_state ? 1 : 0);
                tud_cdc_n_write(0, tel, len);
                tud_cdc_n_write_flush(0);

                if (current_mode != MODE_GAME) {
                    if (stable_enc2_sw_state) enc_press(2, now);
                    else                      enc_release(2);
                }
            }
        } else {
            enc2_sw_debounce_cnt = 0;
        }

        // --- DETECTAR ENTRADA AL MENÚ (HOLD 2 SEGUNDOS EN AMBOS ENCODERS) ---
        static uint32_t hold_start_time = 0;
        // En un juego los dos mandos pulsados a la vez son una entrada más (Air Strike acelera
        // así el misil), y con el gesto activo mantenerlos 2 s sacaba del juego a media
        // partida. De un juego se sale con la tecla 10, que lleva la app, o callando la app.
        if (stable_enc1_sw_state && stable_enc2_sw_state && current_mode != MODE_GAME) {
            if (hold_start_time == 0) {
                hold_start_time = now;
            } else if (now - hold_start_time >= 2000) {
                activity_detected = true;
                // Abre el menú principal desde cualquier sitio que no sea él
                // mismo, no solo desde el uso normal: con un encoder que abre
                // el selector de perfiles (ROT_MENU), el primer toque del gesto
                // ya ha abierto ese menú, y antes este gesto lo cerraba en vez de
                // llevar a los ajustes. Es la vía de escape que queda siempre,
                // también con la tecla de menú libre (menu_key_mode).
                if (current_mode != MODE_MENU_MAIN) {
                    current_mode = MODE_MENU_MAIN;
                    selected_menu_idx = 0;
                    // Este menú no es de un mando: ahí las teclas son atajos.
                    menu_from_rotary = false;
                    menu_cursor_moved = false;
                    push_system_refresh();
                    
                    // Notificar por CDC
                    char tel[24];
                    int len = snprintf(tel, sizeof(tel), "MODE:MENU\n");
                    tud_cdc_n_write(0, tel, len);
                    tud_cdc_n_write_flush(0);
                } else {
                    current_mode = MODE_NORMAL;
                    push_system_refresh();
                    
                    char tel[24];
                    int len = snprintf(tel, sizeof(tel), "MODE:NORMAL\n");
                    tud_cdc_n_write(0, tel, len);
                    tud_cdc_n_write_flush(0);
                }
                hold_start_time = 0;
                // Los mandos ya no abren ni eligen nada con este gesto.
                enc_hold[0].armed = enc_hold[0].open = false;
                enc_hold[1].armed = enc_hold[1].open = false;
                // Esperar liberación completa de botones para evitar dobles clics.
                // Mientras tanto se puede girar para elegir una opción del menú
                // principal y, al soltar, entrar en ella (como en los demás
                // menús que se mantienen); sin girar se queda abierto.
                menu_cursor_moved = false;
                while (!gpio_get(Pins::ENC1_SW) || !gpio_get(Pins::ENC2_SW)) {
                    tud_task();
                    watchdog_update(); // el usuario puede tenerlo apretado un buen rato
                    mirror_pump(0);
                    const int d1 = rueda_izq.get_delta();
                    const int d2 = rueda_der.get_delta();
                    if (d1 != 0) menu_turn(girar(ROTINV_ENC1, d1));
                    if (d2 != 0) menu_turn(girar(ROTINV_ENC2, d2));
                    sleep_ms(10);
                }
                if (menu_cursor_moved && current_mode == MODE_MENU_MAIN) menu_click();
            }
        } else {
            hold_start_time = 0;
        }

        // --- RUEDA DE SCROLL AS5600 ---
        int32_t wheel_delta = 0;
        if (wheel.poll(wheel_delta) && wheel_delta != 0) {
            activity_detected = true;

            if (current_mode == MODE_NORMAL) {
                wheel_accumulate((rot_invert_mask & ROTINV_WHEEL) ? -wheel_delta : wheel_delta);
            }
            // Telemetría agregada: la rueda emite a 250 Hz y volcar una línea
            // por bloque saturaba el CDC e introducía jitter en el scroll.
            wheel_tel_accum += wheel_delta;
        }
        // La rueda tiene preferencia sobre el endpoint: es lo que más se nota
        // si se retrasa. Después va lo que haya pendiente de teclado.
        WheelOut::flush();
        PtpOut::tick();
        HidOut::pump();
        macro_player_tick(now);

        // Soltar el Ctrl del zoom cuando se deja de girar. Hay que abrir también
        // la compuerta: si quedaran unidades a medias, se quedaría esperando un
        // Ctrl que ya no va a volver y la rueda enmudecería para siempre.
        if (zoom_hold_until != 0 && (int32_t)(now - zoom_hold_until) >= 0) {
            zoom_hold_until = 0;
            HidOut::set_sticky_mod(0);
            WheelOut::zoom_disarm();
        }

        // 20 Hz basta para dibujar la rueda en la app; un juego que la use como
        // mando necesita más (100 Hz), a costa de unas pocas líneas más.
        const uint32_t wheel_tel_ms = (current_mode == MODE_GAME) ? 10 : 50;
        if (wheel_tel_accum != 0 && (uint32_t)(now - last_wheel_tel) >= wheel_tel_ms) {
            // Además del incremento va el ángulo absoluto (0-4095): es lo que
            // permite a la app dibujar la rueda en su posición real. El campo
            // se añade al final para no romper a quien solo lea el incremento.
            char tel[40];
            int len = snprintf(tel, sizeof(tel), "WHEEL:%ld:%u\n",
                               (long)wheel_tel_accum, (unsigned)wheel.rawAngle());
            // Escribir sin sitio en el FIFO de TX no falla: escribe lo que cabe
            // y tira el resto. La app recibía entonces media línea pegada a la
            // siguiente ("WHEEL:5:WHEEL:-3:2100") y leía el ángulo como NaN, lo
            // que dejaba el dibujo de la rueda congelado hasta reiniciar. Si no
            // cabe entera se deja para la vuelta siguiente: el incremento sigue
            // acumulado y el ángulo que se manda luego es el de verdad.
            if (tud_cdc_n_write_available(0) >= (uint32_t)len) {
                last_wheel_tel  = now;
                wheel_tel_accum = 0;
                tud_cdc_n_write(0, tel, len);
                tud_cdc_n_write_flush(0);
            } else {
                tud_cdc_n_write_flush(0); // empuja lo pendiente para hacer sitio
            }
        }

        // --- LECTURA ANTIRREBOTE DE LAS DOCE TECLAS ---
        // Todo lo que viene detrás (SUPER, el menú y los atajos) lee de
        // aquí, nunca del pin en crudo.
        {
            uint32_t now_us = time_us_32();
            for (int i = 0; i < 12; i++) {
                bool raw = !gpio_get(key_pins[i]);
                if (held_in_intro[i]) { if (!raw) held_in_intro[i] = false; raw = false; }
                if (raw == key_stable[i]) {
                    key_edge_us[i] = now_us; // sigue como estaba: reloj a cero
                } else if ((uint32_t)(now_us - key_edge_us[i]) >= KEY_DEBOUNCE_US) {
                    key_stable[i]  = raw;
                    key_flanco_us[i] = key_edge_us[i];
                    key_edge_us[i] = now_us;
                }
            }
        }

        // --- TECLA DE MENÚ: CORTA CAMBIA DE PÁGINA, LARGA ABRE LOS PERFILES ---
        // Con SUPER sujeta, lo mismo pero al revés o más arriba: la corta
        // retrocede de página y la larga abre el menú principal (ajustes). Se
        // mira SUPER en el momento en que se decide, no al empezar: da igual
        // en qué orden se pongan los dedos mientras estén las dos a la vez.
        // Con la tecla libre (MENUKEY_NORMAL) nada de esto: es una tecla más y
        // la lleva el bucle de las teclas, de abajo.
        bool menu_key_pressed = menu_key_is_menu() && key_stable[KEY_IDX_MENU];
        static uint32_t menu_hold_start = 0;
        static bool     menu_long_fired = false;
        if (menu_key_pressed && current_mode == MODE_NORMAL) {
            if (menu_hold_start == 0) {
                menu_hold_start = now;
                menu_long_fired = false;
            } else if (!menu_long_fired && now - menu_hold_start >= 150 && key_stable[KEY_IDX_SUPER]) {
                // SUPER + menú mantenido: el menú principal, que se queda
                // abierto al soltar (como al abrirlo con su tecla de siempre).
                // La tecla de menú se da por ya pulsada: si no, el bucle de las
                // teclas vería ahora su flanco, dentro del menú, como una
                // pulsación nueva.
                menu_long_fired = true;
                activity_detected = true;
                current_mode = MODE_MENU_MAIN;
                selected_menu_idx = 0;
                last_key_state[KEY_IDX_MENU] = true;
                push_system_refresh();
                cdc_printf("MODE:MENU\n");
            } else if (!menu_long_fired && now - menu_hold_start >= 150) {
                menu_long_fired = true;
                activity_detected = true;
                current_mode = MODE_MENU_PERF;
                perf_menu_open(false);
                push_system_refresh();
                
                // Notificar por CDC
                char tel[24];
                int len = snprintf(tel, sizeof(tel), "MODE:MENU\n");
                tud_cdc_n_write(0, tel, len);
                tud_cdc_n_write_flush(0);
                
                // Mientras se mantiene el menú, tocar la tecla de un perfil lo
                // selecciona sin soltar antes: "menú + perfil" en un solo gesto,
                // sin gastar una tecla dedicada por perfil. Si se suelta el menú
                // sin tocar nada, se cancela y se vuelve a donde se estaba.
                int8_t picked_ki = -1;
                while (!gpio_get(key_pins[KEY_IDX_MENU])) {
                    tud_task();
                    watchdog_update(); // el usuario puede tenerla apretada un buen rato
                    // El bucle principal no corre mientras tanto: sin esto la
                    // app no se enteraba de que el menú se había abierto, y el
                    // dashboard saltaba al perfil nuevo sin animación.
                    mirror_pump(0);

                    if (picked_ki < 0) {
                        for (uint8_t s = 1; s <= PERF_MENU_SCREENS; s++) {
                            uint8_t ki = key_index_for_screen(s);
                            if (ki == KEY_IDX_MENU || ki == KEY_IDX_SUPER) continue;
                            if (!gpio_get(key_pins[ki])) {
                                uint8_t option = (uint8_t)(perf_menu_first + s - 1);
                                if (option == PERF_GAMES_OPT && perf_has_games()) {
                                    games_enter();
                                } else {
                                    if (option < profile_count) {
                                        active_profile_idx = option;
                                        active_page = 0;
                                        save_settings();
                                    }
                                    current_mode = MODE_NORMAL;
                                    push_system_refresh();
                                    int len2 = snprintf(tel, sizeof(tel), "MODE:NORMAL\n");
                                    tud_cdc_n_write(0, tel, len2);
                                    tud_cdc_n_write_flush(0);
                                }
                                picked_ki = (int8_t)ki;
                                break;
                            }
                        }
                    }
                    sleep_ms(10);
                }
                // Si se eligió perfil con el gesto y la tecla sigue pulsada, hay
                // que esperar a que se suelte: si no, el bucle normal la ve
                // "recién pulsada" y dispara el atajo que tenga asignado.
                if (picked_ki >= 0) {
                    while (!gpio_get(key_pins[picked_ki])) {
                        tud_task();
                        mirror_pump(0);
                        sleep_ms(5);
                    }
                } else {
                    // Se soltó el menú sin elegir perfil: cancelar y volver a
                    // donde se estaba, no dejar el menú abierto.
                    current_mode = MODE_NORMAL;
                    push_system_refresh();
                    char tel2[24];
                    int len3 = snprintf(tel2, sizeof(tel2), "MODE:NORMAL\n");
                    tud_cdc_n_write(0, tel2, len3);
                    tud_cdc_n_write_flush(0);
                }
                menu_hold_start = 0;
            }
        } else {
            // Al soltar: si no llegó al tiempo del menú, era una pulsación corta
            // y toca pasar de página. El menú largo ya se ha encargado de lo suyo.
            //
            // Segunda red bajo el antirrebote: por debajo de MENU_TAP_MIN_MS no
            // hay dedo humano que valga, así que un pulso más corto es ruido y no
            // pasa de página. Se cuentan para poder verlos con GET_STATE, porque
            // el síntoma (páginas pasando solas) aparece justo con la app cerrada,
            // que es cuando nadie está mirando el CDC.
            if (menu_hold_start != 0 && !menu_long_fired && current_mode == MODE_NORMAL) {
                if ((uint32_t)(now - menu_hold_start) >= MENU_TAP_MIN_MS) {
                    activity_detected = true;
                    if (key_stable[KEY_IDX_SUPER]) prev_page();
                    else next_page();
                } else {
                    menu_tap_glitches++;
                }
            }
            menu_hold_start = 0;
            menu_long_fired = false;
        }

        // --- TECLAS ---
        // Primero, actualizar el estado de la tecla SUPER
        bool super_pressed = key_stable[KEY_IDX_SUPER];
        if (super_pressed != super_active) {
            super_active = super_pressed;

            // Doble toque de SUPER: modo ayuda. Se cuenta de pulsación a
            // pulsación; mantener SUPER para usar su capa no lo dispara,
            // porque entre las dos pulsaciones habría más de HELP_TAP_MS.
            static uint32_t super_tap_ms = 0;
            static bool     super_tap_armed = false;
            if (super_pressed && current_mode == MODE_NORMAL) {
                if (super_tap_armed && (uint32_t)(now - super_tap_ms) <= HELP_TAP_MS) {
                    super_tap_armed = false;
                    help_set(!help_active);
                } else {
                    super_tap_armed = true;
                    super_tap_ms = now;
                }
            }
            if (current_mode == MODE_NORMAL) {
                push_system_refresh();
            }

            // Telemetría serial
            char tel[24];
            int len = snprintf(tel, sizeof(tel), "KEY_EV:%d:%d\n",
                               KEY_IDX_SUPER + 1, super_active ? 1 : 0);
            tud_cdc_n_write(0, tel, len);
            tud_cdc_n_write_flush(0);
        }

        // Con el menú abierto desde un mando las teclas siguen siendo teclas:
        // hacen lo que dice la página, y la selección la lleva el mando.
        const bool keys_live = current_mode == MODE_NORMAL
                            || (menu_from_rotary && current_mode != MODE_NORMAL);

        for (int i = 0; i < 12; i++) {
            // La tecla SUPER se maneja por separado, arriba
            if (i == KEY_IDX_SUPER) continue;

            // La tecla de menú, en modo normal, solo responde al hold largo
            // (salvo que esté libre: entonces es una tecla como las demás).
            if (i == KEY_IDX_MENU && keys_live && menu_key_is_menu()) continue;

            bool is_pressed = key_stable[i];
            if (is_pressed != last_key_state[i]) {
                last_key_state[i] = is_pressed;
                activity_detected = true;

                if (keys_live) {
                    // El realce de la pantalla ya no se toca aquí: se recalcula
                    // entero más abajo, una vez por vuelta (ver "REALCE DE LAS
                    // TECLAS PULSADAS").

                    // Telemetría serial PC
                    char tel[24];
                    int len = snprintf(tel, sizeof(tel), "KEY_EV:%d:%d\n", i+1, is_pressed ? 1 : 0);
                    tud_cdc_n_write(0, tel, len);
                    tud_cdc_n_write_flush(0);

                    // Envío de atajo nativo HID según el perfil activo y SUPER.
                    // Al soltar no se vuelve a mirar el perfil: HidOut recuerda
                    // lo que envió cada tecla, así que cambiar de capa con una
                    // tecla hundida ya no puede dejarla pegada.
                    if (is_pressed) {
                        // «Salir al pulsar una tecla»: sale y la tecla hace lo
                        // suyo igual, que para eso se ha mirado su nombre.
                        if (help_active && help_exit == HELPX_KEY && current_mode == MODE_NORMAL)
                            help_set(false);
                        uint8_t mapping_idx = i + (super_active ? 12 : 0);
                        uint8_t mod = cur_page().key_mappings[mapping_idx].modifier;
                        uint8_t key = cur_page().key_mappings[mapping_idx].keycode;
                        if (mod == KEYACT_CONSUMER) {
                            // Acción multimedia, traducida de su índice de tabla
                            HidOut::consumer_tap(get_consumer_key_from_index(key));
                        } else if (mod == KEYACT_GOTO_PAGE) {
                            // Salto directo. El número va en base 1, que es como
                            // lo ve el usuario en la app y en las pantallas.
                            if (key >= 1 && key <= MAX_PAGES) set_active_page((uint8_t)(key - 1));
                        } else if (mod == KEYACT_PAGE_STATE) {
                            // Abre el gestor de páginas, con el cursor en la actual
                            current_mode = MODE_MENU_PAGES;
                            selected_menu_idx = active_page;
                            push_system_refresh();
                        } else if (mod == KEYACT_MACRO) {
                            // La secuencia la ejecuta el PC, no el teclado.
                            trigger_macro(key);
                        } else if (mod != 0 && key != 0 && ORBY_COMBO_AS_TAP) {
                            // Combinación tipo Ctrl+C: pulsación breve, no
                            // mantenida. Si se mantuviera, el Ctrl se queda
                            // puesto en el host y este convierte la rueda en
                            // zoom (y el Shift, en scroll horizontal): era la
                            // razón de que la rueda «no hiciera scroll» con una
                            // tecla apretada.
                            HidOut::tap(mod, key);
                        } else if (mod != 0 || key != 0) {
                            // Tecla suelta o modificador a pelo: se mantiene, que
                            // es lo que hace falta para el autorrepetido y para
                            // usarla como modificador del ratón.
                            HidOut::key_down((uint8_t)i, mod, key);
                        }
                    } else {
                        HidOut::key_up((uint8_t)i);
                    }
                } else if (current_mode == MODE_GAME) {
                    // Solo telemetría, en las dos direcciones: el juego necesita
                    // saber también cuándo se suelta. Nada de HID ni de menú. Lleva
                    // detrás el µs de la pulsación (ver game_shown_us).
                    char tel[32];
                    int len = snprintf(tel, sizeof(tel), "KEY_EV:%d:%d:%lu\n", i+1, is_pressed ? 1 : 0,
                                       (unsigned long)key_flanco_us[i]);
                    tud_cdc_n_write(0, tel, len);
                    tud_cdc_n_write_flush(0);
                } else if (is_pressed && current_mode == MODE_MENU_PAGES) {
                    // Gestor de páginas: cada tecla con número salta a su página.
                    // La de la pantalla 10 sale sin cambiar nada.
                    uint8_t count = profiles[active_profile_idx].page_count;
                    if (i < count) {
                        set_active_page((uint8_t)i);
                        current_mode = MODE_NORMAL;
                        push_system_refresh();
                    } else if (i == key_index_for_screen(10)) {
                        current_mode = MODE_NORMAL;
                        push_system_refresh();
                    }
                } else if (is_pressed) {
                    // En cualquier menú, las teclas 1 a 6 actúan como atajos de
                    // selección; en el principal también la 7 (Salir, desde la 4.28).
                    // La tecla 11 (la pantalla 10) es «Juegos» en el selector de perfiles.
                    const bool tecla_juegos = current_mode == MODE_MENU_PERF
                        && i == key_index_for_screen(10) && perf_has_games();
                    if (i <= 5 || (i == MM_EXIT && current_mode == MODE_MENU_MAIN) || tecla_juegos) {
                        selected_menu_idx = tecla_juegos ? PERF_GAMES_OPT : i;

                        if (current_mode == MODE_MENU_MAIN) {
                            if (selected_menu_idx == 0) current_mode = MODE_MENU_PERF;
                            else if (selected_menu_idx == 1) current_mode = MODE_MENU_REPO;
                            else if (selected_menu_idx == 2) current_mode = MODE_MENU_SCROLL;
                            else if (selected_menu_idx == 3) current_mode = MODE_MENU_RESET;
                            else if (selected_menu_idx == 4) current_mode = MODE_MENU_INFO;
                            else if (selected_menu_idx == MM_HELP) {
                                current_mode = MODE_NORMAL;
                                help_set(!help_active);
                                cdc_printf("MODE:NORMAL\n");
                            } else if (selected_menu_idx == MM_EXIT) {
                                current_mode = MODE_NORMAL;
                                char tel[24];
                                int len = snprintf(tel, sizeof(tel), "MODE:NORMAL\n");
                                tud_cdc_n_write(0, tel, len);
                                tud_cdc_n_write_flush(0);
                            }
                            selected_menu_idx = 0;
                            if (current_mode == MODE_MENU_PERF) perf_menu_open();
                            else if (current_mode == MODE_MENU_RESET) reset_menu_open();
                            push_system_refresh();
                        } else if (current_mode == MODE_MENU_PERF) {
                            if (selected_menu_idx == PERF_GAMES_OPT && perf_has_games()) {
                                games_enter();
                            } else if (selected_menu_idx < profile_count) {
                                active_profile_idx = selected_menu_idx;
                                active_page = 0;
                                save_settings();
                                current_mode = MODE_NORMAL;
                                char tel[24];
                                int len = snprintf(tel, sizeof(tel), "MODE:NORMAL\n");
                                tud_cdc_n_write(0, tel, len);
                                tud_cdc_n_write_flush(0);
                            } else if (perf_menu_back_to_normal) {
                                current_mode = MODE_NORMAL;
                                cdc_printf("MODE:NORMAL\n");
                            } else {
                                current_mode = MODE_MENU_MAIN;
                            }
                            selected_menu_idx = 0;
                            push_system_refresh();
                        } else if (current_mode == MODE_MENU_REPO) {
                            if (selected_menu_idx >= 0 && selected_menu_idx <= 3) {
                                const uint8_t repo_vals[4] = {1, 5, 10, 0};
                                reposo_timeout_min = repo_vals[selected_menu_idx];
                                save_settings();
                            }
                            current_mode = MODE_MENU_MAIN;
                            selected_menu_idx = 1;
                            push_system_refresh();
                        } else if (current_mode == MODE_MENU_SCROLL) {
                            if (selected_menu_idx == 0) {
                                cur_page().scroll_invert[0] = !cur_page().scroll_invert[0];
                                save_settings();
                            } else if (selected_menu_idx == 1) {
                                cur_page().scroll_invert[1] = !cur_page().scroll_invert[1];
                                save_settings();
                            } else {
                                current_mode = MODE_MENU_MAIN;
                                selected_menu_idx = 2;
                            }
                            push_system_refresh();
                        } else if (current_mode == MODE_MENU_RESET) {
                            if (selected_menu_idx == 0) {
                                load_defaults();
                                save_settings();
                                current_mode = MODE_NORMAL;
                                char tel[24];
                                int len = snprintf(tel, sizeof(tel), "MODE:NORMAL\n");
                                tud_cdc_n_write(0, tel, len);
                                tud_cdc_n_write_flush(0);
                            } else {
                                current_mode = MODE_MENU_MAIN;
                                selected_menu_idx = 3;
                            }
                            push_system_refresh();
                        } else if (current_mode == MODE_MENU_INFO) {
                            if (selected_menu_idx == 4) {
                                current_mode = MODE_MENU_MAIN;
                                selected_menu_idx = 4;
                                push_system_refresh();
                            }
                        }
                    }
                }
            }
        }

        // --- REALCE DE LAS TECLAS PULSADAS ---
        // La máscara se reconstruye entera en cada vuelta a partir del estado
        // antirrebote, en vez de encender un bit al pulsar y apagarlo al
        // soltar. Con el sistema de flancos, cualquier flanco que no llegara a
        // procesarse por este camino —una tecla soltada mientras el modo no era
        // MODE_NORMAL, o mientras el bucle estaba ocupado— dejaba el bit puesto
        // para siempre, y la pantalla de esa tecla se quedaba en negativo: es
        // justo lo que se veía al lanzar una secuencia, que seguía invertida
        // hasta que la secuencia terminaba. Recalcularla es idempotente, así
        // que el realce sigue al estado real de la tecla pase lo que pase.
        {
            uint16_t inversions = 0;
            if (current_mode == MODE_NORMAL) {
                for (int i = 0; i < 12; i++) {
                    uint8_t oled = key_to_oled[i];
                    if (oled > 0 && key_stable[i]) inversions |= (uint16_t)(1u << (oled - 1));
                }
            }
            active_inversions = inversions;
            mirror_pump(inversions);
        }

        // --- MANEJO DE INACTIVIDAD / REPOSO AUTOMÁTICO ---
        if (activity_detected) {
            last_activity_time = now;
            if (is_sleeping) {
                is_sleeping = false;
                displays_on = true;
                display_power_req = true;
                push_system_refresh();
            }
        } else if (!is_sleeping && reposo_timeout_min > 0) {
            uint32_t idle_duration = now - last_activity_time;
            if (idle_duration >= (uint32_t)(reposo_timeout_min * 60 * 1000)) {
                is_sleeping = true;
                displays_on = false;
                display_power_req = true;
                // Al despertar se quiere ver el teclado de siempre, no la ayuda.
                help_set(false);
            }
        }

        // Perfil y página en curso. Va al final de la vuelta para recoger todo
        // lo que haya podido cambiarlos: comandos del CDC, menús y teclas.
        report_active_context();

        // 250 us: el AS5600 se muestrea a 1 kHz y el endpoint HID sondea cada
        // 1 ms, así que un ciclo de 1 ms dejaba el scroll con granularidad
        // visible y retrasaba también la respuesta de las teclas.
        sleep_us(250);
    }
    return 0;
}
