jaestefaniah27/scroll_wheel/KEYBOARD_ORBY_V3/RASPBERRY_PROJECT/ORBY_V4/include/hardware_oled.h

#pragma once
#include "hardware/spi.h"
#include "hardware/gpio.h"
#include "pinout.h"

class HardwareOled {
private:
    // Secuencia mágica de inicialización del SSD1306 (72x40)
    const uint8_t init_seq[25] = {
        0xAE, 0xD5, 0x80, 0xA8, 0x27, 0xD3, 0x00, 0x40, 
        0x8D, 0x14, 0x20, 0x00, 0xA1, 0xC8, 0xDA, 0x12, 
        0x81, 0xCF, 0xD9, 0xF1, 0xDB, 0x40, 0xA4, 0xA6, 0xAF
    };

    // Margen entre flancos del 74HC595. A 3,3 V pide unos 25 ns de preparación
    // del dato y de ancho de pulso de reloj; con un solo nop (~8 ns) se iba por
    // debajo, y un flanco perdido corre la máscara un bit: el CS baja en otra
    // pantalla y le llegan comandos ajenos (un 0xAE suelto la apaga). Seis nop
    // son ~48 ns a 125 MHz; los 16 bits cuestan ~2,5 µs por volcado (fase 6 de
    // PLAN_AIRSTRIKE).
    static inline void shift_wait() {
        __asm volatile ("nop\nnop\nnop\nnop\nnop\nnop\n");
    }

    // Saca 16 bits al 74HC595 (MSB primero) y los pasa a la salida con el latch.
    void shift_mask(uint16_t mask) {
        gpio_put(Pins::SHIFT_LATCH, 0);
        for (int i = 15; i >= 0; i--) {
            gpio_put(Pins::SHIFT_DATA, (mask >> i) & 1);
            shift_wait();                       // preparación del dato
            gpio_put(Pins::SHIFT_CLK, 1);
            shift_wait();                       // ancho del pulso alto
            gpio_put(Pins::SHIFT_CLK, 0);
            shift_wait();                       // ancho del pulso bajo
        }
        gpio_put(Pins::SHIFT_LATCH, 1);
        shift_wait();
    }

    void apply_cs(uint8_t screen_num) {
        uint16_t mask = 0xFFFF; // Todo HIGH (aislado)
        if (screen_num >= 1 && screen_num <= 10) {
            uint8_t target_bit = OledMap::CS_BITS[screen_num - 1];
            mask &= ~(1 << target_bit); // Ponemos a LOW solo el bit de esa pantalla
        }
        shift_mask(mask);
    }

    void send_command(uint8_t cmd) {
        gpio_put(Pins::OLED_DC, 0); // Modo comando
        spi_write_blocking(spi0, &cmd, 1);
    }

public:
    HardwareOled() {
        // 1. Inicializar pines de control OLED fijos
        gpio_init(Pins::OLED_DC);  gpio_set_dir(Pins::OLED_DC, GPIO_OUT);
        gpio_init(Pins::OLED_RST); gpio_set_dir(Pins::OLED_RST, GPIO_OUT);

        // RST en reposo es ALTO. gpio_init() deja la salida a cero, así que sin
        // esta línea construir la clase deja las diez pantallas en reset hasta
        // que alguien llame a init_all_screens().
        gpio_put(Pins::OLED_RST, 1);

        // 2. Inicializar pines del Shift Register Multiplexor (74HC595)
        gpio_init(Pins::SHIFT_DATA);  gpio_set_dir(Pins::SHIFT_DATA, GPIO_OUT);
        gpio_init(Pins::SHIFT_CLK);   gpio_set_dir(Pins::SHIFT_CLK, GPIO_OUT);
        gpio_init(Pins::SHIFT_LATCH); gpio_set_dir(Pins::SHIFT_LATCH, GPIO_OUT);

        // Dejar inicialmente en LOW y Output OFF aislado
        gpio_put(Pins::SHIFT_DATA, 0);
        gpio_put(Pins::SHIFT_CLK, 0);
        gpio_put(Pins::SHIFT_LATCH, 1);

        // 3. Inicializar Hardware SPI a 10 MHz
        spi_init(spi0, 10000 * 1000); 
        gpio_set_function(Pins::SPI_SCK, GPIO_FUNC_SPI);
        gpio_set_function(Pins::SPI_MOSI, GPIO_FUNC_SPI);
    }

    void init_all_screens() {
        // Reset físico global
        gpio_put(Pins::OLED_RST, 1); sleep_ms(1);
        gpio_put(Pins::OLED_RST, 0); sleep_ms(10);
        gpio_put(Pins::OLED_RST, 1); sleep_ms(10);

        // Abrir TODAS las pantallas a la vez (Máscara 0x0000 = todos los CS a LOW)
        shift_mask(0x0000); // todos los CS a LOW: broadcast
        sleep_us(5); // Esperar propagación CS a través de U3+U4

        // Mandar la secuencia de arranque 
        for (uint8_t cmd : init_seq) {
            send_command(cmd);
        }

        // Limpiar la GDDRAM de TODAS las pantallas (broadcast)
        // Evita que se muestre basura aleatoria si paint_screen falla
        send_command(0x21); send_command(28); send_command(99);
        send_command(0x22); send_command(0); send_command(4);
        gpio_put(Pins::OLED_DC, 1);
        uint8_t zeros[72] = {0};
        for (int page = 0; page < 5; page++) {
            spi_write_blocking(spi0, zeros, 72);
        }

        // Aislar todas (Máscara 0xFFFF)
        apply_cs(0); 
    }

    void paint_screen(uint8_t screen_num, const uint8_t* framebuffer, size_t size = 360) {
        apply_cs(screen_num);
        sleep_us(5); // Esperar propagación CS (crítico para U4: pantallas 9-10)

        // Modo horizontal en cada volcado: si un glitch del bus lo cambió, 0x21/0x22
        // no bastan y la imagen sale revuelta hasta reiniciar (fase 6 de PLAN_AIRSTRIKE).
        send_command(0x20); send_command(0x00);
        // Posicionar el cursor de la pantalla (Offset 28 y 99 para centrar en RAM 128x64)
        send_command(0x21); send_command(28); send_command(99);
        send_command(0x22); send_command(0); send_command(4);
        
        // Modo datos
        gpio_put(Pins::OLED_DC, 1); 
        
        // El SPI dispara la imagen a máxima velocidad
        spi_write_blocking(spi0, framebuffer, size);

        apply_cs(0); // Volver a cerrar el canal
    }

    // La secuencia de arranque entera a UNA pantalla, sin tocar RST: el reset es
    // común a las diez y las otras nueve se apagarían. Deja la pantalla sin
    // invertir y con la GDDRAM como estuviera: quien llama la repinta.
    void reinit_screen(uint8_t screen_num, bool on) {
        apply_cs(screen_num);
        sleep_us(5); // Esperar propagación CS
        for (uint8_t cmd : init_seq) send_command(cmd);
        if (!on) send_command(0xAE); // en reposo: el init acaba encendiéndola
        apply_cs(0);
    }

    // Vigilante a ciegas (L2 de la fase 6): vuelve a mandar la configuración
    // a una pantalla sin pasar por 0xAE, para que no parpadee. Con los mismos
    // valores no cambia nada en una pantalla sana; a una que un glitch dejó
    // apagada, sin bomba de carga, girada o con otro modo, la devuelve a su
    // sitio. Quien llama la repinta después.
    void refresh_config(uint8_t screen_num, bool on, bool invert) {
        apply_cs(screen_num);
        sleep_us(5); // Esperar propagación CS
        for (size_t i = 1; i + 3 < sizeof(init_seq); i++) send_command(init_seq[i]); // sin 0xAE ni A4/A6/AF
        send_command(0xA4);
        send_command(invert ? 0xA7 : 0xA6);
        send_command(on ? 0xAF : 0xAE);
        apply_cs(0);
    }

    void invert_screen(uint8_t screen_num, bool invert) {
        apply_cs(screen_num);
        sleep_us(5); // Esperar propagación CS
        send_command(invert ? 0xA7 : 0xA6);
        apply_cs(0);
    }

    void set_all_displays_on(bool on) {
        // Broadcast a todas las pantallas (todos los CS a LOW)
        shift_mask(0x0000); // todos los CS a LOW: broadcast
        sleep_us(5);

        send_command(on ? 0xAF : 0xAE); // Display ON / OFF

        apply_cs(0); // Aislar todas
    }
};
