jaestefaniah27/scroll_wheel/KEYBOARD_ORBY_V3/RASPBERRY_PROJECT/ORBY_V4/include/oled_text.h

#pragma once
#include <stdint.h>
#include <string.h>

namespace OledText {

    // Standard 5x7 ASCII font (from 32 to 127)
    static const uint8_t font_5x7[96][5] = {
        {0x00, 0x00, 0x00, 0x00, 0x00}, // (space)
        {0x00, 0x00, 0x5F, 0x00, 0x00}, // !
        {0x00, 0x07, 0x00, 0x07, 0x00}, // "
        {0x14, 0x7F, 0x14, 0x7F, 0x14}, // #
        {0x24, 0x2A, 0x7F, 0x2A, 0x12}, // $
        {0x23, 0x13, 0x08, 0x64, 0x62}, // %
        {0x36, 0x49, 0x55, 0x22, 0x50}, // &
        {0x00, 0x05, 0x03, 0x00, 0x00}, // '
        {0x00, 0x1C, 0x22, 0x41, 0x00}, // (
        {0x00, 0x41, 0x22, 0x1C, 0x00}, // )
        {0x08, 0x2A, 0x1C, 0x2A, 0x08}, // *
        {0x08, 0x08, 0x3E, 0x08, 0x08}, // +
        {0x00, 0x50, 0x30, 0x00, 0x00}, // ,
        {0x08, 0x08, 0x08, 0x08, 0x08}, // -
        {0x00, 0x60, 0x60, 0x00, 0x00}, // .
        {0x20, 0x10, 0x08, 0x04, 0x02}, // /
        {0x3E, 0x51, 0x49, 0x45, 0x3E}, // 0
        {0x00, 0x42, 0x7F, 0x40, 0x00}, // 1
        {0x42, 0x61, 0x51, 0x49, 0x46}, // 2
        {0x21, 0x41, 0x45, 0x4B, 0x31}, // 3
        {0x18, 0x14, 0x12, 0x7F, 0x10}, // 4
        {0x27, 0x45, 0x45, 0x45, 0x39}, // 5
        {0x3C, 0x4A, 0x49, 0x49, 0x30}, // 6
        {0x01, 0x71, 0x09, 0x05, 0x03}, // 7
        {0x36, 0x49, 0x49, 0x49, 0x36}, // 8
        {0x06, 0x49, 0x49, 0x29, 0x1E}, // 9
        {0x00, 0x36, 0x36, 0x00, 0x00}, // :
        {0x00, 0x56, 0x36, 0x00, 0x00}, // ;
        {0x00, 0x08, 0x14, 0x22, 0x41}, // <
        {0x14, 0x14, 0x14, 0x14, 0x14}, // =
        {0x41, 0x22, 0x14, 0x08, 0x00}, // >
        {0x02, 0x01, 0x51, 0x09, 0x06}, // ?
        {0x32, 0x49, 0x79, 0x41, 0x3E}, // @
        {0x7E, 0x11, 0x11, 0x11, 0x7E}, // A
        {0x7F, 0x49, 0x49, 0x49, 0x36}, // B
        {0x3E, 0x41, 0x41, 0x41, 0x22}, // C
        {0x7F, 0x41, 0x41, 0x22, 0x1C}, // D
        {0x7F, 0x49, 0x49, 0x49, 0x41}, // E
        {0x7F, 0x09, 0x09, 0x01, 0x01}, // F
        {0x3E, 0x41, 0x49, 0x49, 0x7A}, // G
        {0x7F, 0x08, 0x08, 0x08, 0x7F}, // H
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
        {0x02, 0x04, 0x08, 0x16, 0x20}, // \ (backslash)
        {0x00, 0x41, 0x41, 0x7F, 0x00}, // ]
        {0x04, 0x02, 0x01, 0x02, 0x04}, // ^
        {0x40, 0x40, 0x40, 0x40, 0x40}, // _
        {0x00, 0x01, 0x02, 0x04, 0x00}, // `
        {0x20, 0x54, 0x54, 0x54, 0x78}, // a
        {0x7F, 0x48, 0x44, 0x44, 0x38}, // b
        {0x38, 0x44, 0x44, 0x44, 0x20}, // c
        {0x38, 0x44, 0x44, 0x48, 0x7F}, // d
        {0x38, 0x54, 0x54, 0x54, 0x18}, // e
        {0x08, 0x7E, 0x09, 0x01, 0x02}, // f
        {0x0C, 0x52, 0x52, 0x52, 0x3E}, // g
        {0x7F, 0x08, 0x04, 0x04, 0x78}, // h
        {0x00, 0x44, 0x7D, 0x40, 0x00}, // i
        {0x20, 0x40, 0x44, 0x3D, 0x00}, // j
        {0x7F, 0x10, 0x28, 0x44, 0x00}, // k
        {0x00, 0x41, 0x7F, 0x40, 0x00}, // l
        {0x7C, 0x04, 0x18, 0x04, 0x78}, // m
        {0x7C, 0x08, 0x04, 0x04, 0x78}, // n
        {0x38, 0x44, 0x44, 0x44, 0x38}, // o
        {0x7C, 0x14, 0x14, 0x14, 0x08}, // p
        {0x08, 0x14, 0x14, 0x14, 0x7C}, // q
        {0x7C, 0x08, 0x04, 0x04, 0x08}, // r
        {0x48, 0x54, 0x54, 0x54, 0x20}, // s
        {0x04, 0x3F, 0x44, 0x40, 0x20}, // t
        {0x3C, 0x40, 0x40, 0x20, 0x7C}, // u
        {0x1C, 0x20, 0x40, 0x20, 0x1C}, // v
        {0x3C, 0x40, 0x30, 0x40, 0x3C}, // w
        {0x44, 0x28, 0x10, 0x28, 0x44}, // x
        {0x0C, 0x50, 0x50, 0x50, 0x3C}, // y
        {0x44, 0x64, 0x54, 0x4C, 0x44}, // z
        {0x00, 0x08, 0x36, 0x41, 0x00}, // {
        {0x00, 0x00, 0x7F, 0x00, 0x00}, // |
        {0x00, 0x41, 0x36, 0x08, 0x00}, // }
        {0x02, 0x01, 0x02, 0x04, 0x02}  // ~
    };

    inline void render_string_to_framebuffer(const char* str, uint8_t* framebuffer) {
        memset(framebuffer, 0, 360); // Limpiar buffer de imagen (72x40 píxeles = 360 bytes)
        
        int len = strlen(str);
        if (len == 0) return;

        // Ancho total de la cadena en píxeles: len * 6 (5 píxeles de caracter + 1 espacio) - 1 de espacio final
        int total_width = len * 6 - 1;
        
        // Centrar horizontalmente
        int col_offset = (72 - total_width) / 2;
        if (col_offset < 0) col_offset = 0; // Prevenir desbordamientos negativos

        int page = 2; // Pintar en la página 2 (el centro vertical de las 5 páginas)

        for (int c = 0; c < len; c++) {
            char ch = str[c];
            if (ch < 32 || ch > 127) ch = ' '; // Convertir caracteres no soportados a espacio
            
            uint8_t index = ch - 32;

            for (int i = 0; i < 5; i++) {
                int col = col_offset + c * 6 + i;
                if (col >= 72) break; // Limite lateral del display
                framebuffer[page * 72 + col] = font_5x7[index][i];
            }
        }
    }

} // namespace OledText
