jaestefaniah27/scroll_wheel/KEYBOARD_ORBY_V3/RASPBERRY_PROJECT/ORBY_V4/include/oled_bitmaps.h

#pragma once
#include <stdint.h>

namespace OledBitmaps {

    // Obtener el puntero al buffer del mapa de bits (72x40 píxeles = 360 bytes) por su índice (0 a 9)
    const uint8_t* get_bitmap_by_index(int idx);

} // namespace OledBitmaps
