jaestefaniah27/scroll_wheel/KEYBOARD_ORBY_V3/RASPBERRY_PROJECT/ORBY_V4/include/oled_ui_data.h

// GENERADO por tools/oled_ui/build.py a partir de font.py, icons.py y
// catalog.py. No se edita a mano: se cambia el dibujo y se regenera.
#pragma once
#include <stdint.h>

namespace OledUiData {

struct Glyph  { uint16_t cp; uint8_t w; uint16_t off; };
struct Sprite { uint8_t w, h; uint16_t off; };
struct Entry  { const char* key; uint16_t icon; const char* caption; };

// Fuente pequeña: 9 filas (7 de mayúscula + 2 de rabo), una palabra por columna.
static const uint16_t font_cols[] = {
    0x000, 0x000, 0x000, 0x05f, 0x003, 0x000, 0x003, 0x014, 0x03e, 0x014, 0x03e, 0x014, 0x024, 0x02a, 0x07f, 0x02a,
    0x012, 0x013, 0x00b, 0x014, 0x032, 0x021, 0x032, 0x04d, 0x055, 0x032, 0x048, 0x003, 0x03e, 0x041, 0x041, 0x03e,
    0x00a, 0x004, 0x00a, 0x008, 0x008, 0x03e, 0x008, 0x008, 0x080, 0x040, 0x008, 0x008, 0x008, 0x040, 0x060, 0x018,
    0x00c, 0x003, 0x03e, 0x051, 0x049, 0x045, 0x03e, 0x042, 0x07f, 0x040, 0x042, 0x061, 0x051, 0x049, 0x046, 0x022,
    0x041, 0x049, 0x049, 0x036, 0x018, 0x014, 0x012, 0x07f, 0x010, 0x027, 0x045, 0x045, 0x045, 0x039, 0x03e, 0x049,
    0x049, 0x049, 0x030, 0x001, 0x001, 0x079, 0x005, 0x003, 0x036, 0x049, 0x049, 0x049, 0x036, 0x006, 0x049, 0x049,
    0x049, 0x03e, 0x044, 0x080, 0x044, 0x000, 0x008, 0x014, 0x022, 0x014, 0x014, 0x014, 0x014, 0x022, 0x014, 0x008,
    0x000, 0x002, 0x051, 0x009, 0x006, 0x03e, 0x041, 0x05d, 0x055, 0x00e, 0x07e, 0x009, 0x009, 0x009, 0x07e, 0x07f,
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
    {24, 22, 48},  // cut
    {24, 22, 72},  // undo
    {24, 22, 96},  // redo
    {24, 22, 120},  // select_all
    {24, 22, 144},  // save
    {24, 22, 168},  // find
    {24, 22, 192},  // close
    {24, 22, 216},  // screenshot
    {24, 22, 240},  // table
    {24, 22, 264},  // document
    {24, 22, 288},  // globe
    {24, 22, 312},  // calculator
    {24, 22, 336},  // activity
    {24, 22, 360},  // lock
    {24, 22, 384},  // play_pause
    {24, 22, 408},  // play
    {24, 22, 432},  // stop
    {24, 22, 456},  // next
    {24, 22, 480},  // prev
    {24, 22, 504},  // brush
    {24, 22, 528},  // eraser
    {24, 22, 552},  // pencil
    {24, 22, 576},  // lasso
    {24, 22, 600},  // crop
    {24, 22, 624},  // move
    {24, 22, 648},  // layer_new
    {24, 22, 672},  // duplicate
    {24, 22, 696},  // zoom
    {24, 22, 720},  // hand
    {24, 22, 744},  // text
    {24, 22, 768},  // gradient
    {24, 22, 792},  // pen
    {24, 22, 816},  // shapes
    {24, 22, 840},  // eyedropper
    {24, 22, 864},  // marquee
    {24, 22, 888},  // select
    {24, 22, 912},  // slice
    {24, 22, 936},  // path_select
    {24, 22, 960},  // pointer
    {24, 22, 984},  // wire
    {24, 22, 1008},  // port
    {24, 22, 1032},  // pad
    {24, 22, 1056},  // via
    {24, 22, 1080},  // track
    {24, 22, 1104},  // fit
    {24, 22, 1128},  // cube
    {24, 22, 1152},  // schematic
    {24, 22, 1176},  // pcb
    {24, 22, 1200},  // library
    {24, 22, 1224},  // chip
    {24, 22, 1248},  // grid
    {24, 22, 1272},  // ruler
    {24, 22, 1296},  // checklist
    {24, 22, 1320},  // bolt
    {24, 22, 1344},  // check_box
    {24, 22, 1368},  // gear
    {24, 22, 1392},  // razor
    {24, 22, 1416},  // marker
    {24, 22, 1440},  // link
    {24, 22, 1464},  // ripple
    {24, 22, 1488},  // export
    {24, 22, 1512},  // nest
    {24, 22, 1536},  // slip
    {24, 22, 1560},  // slide
    {24, 22, 1584},  // trim
    {24, 22, 1608},  // rate
    {24, 22, 1632},  // roll
    {24, 22, 1656},  // speed
    {24, 22, 1680},  // briefcase
    {24, 22, 1704},  // film
    {24, 22, 1728},  // profiles
    {24, 22, 1752},  // moon
    {24, 22, 1776},  // moon_off
    {24, 22, 1800},  // wheel
    {24, 22, 1824},  // reset
    {24, 22, 1848},  // info
    {24, 22, 1872},  // help
    {24, 22, 1896},  // exit
    {24, 22, 1920},  // back
    {24, 22, 1944},  // timer1
    {24, 22, 1968},  // timer5
    {24, 22, 1992},  // timer10
    {24, 22, 2016},  // trash
    {24, 22, 2040},  // xmark
    {24, 22, 2064},  // pc
    {24, 22, 2088},  // pc_off
    {24, 22, 2112},  // calendar
    {24, 22, 2136},  // pages
    {24, 22, 2160},  // sine
    {24, 22, 2184},  // code
    {24, 22, 2208},  // windows
    {24, 22, 2232},  // slides
    {24, 22, 2256},  // align_l
    {24, 22, 2280},  // align_c
    {24, 22, 2304},  // align_r
    {24, 22, 2328},  // align_j
    {24, 22, 2352},  // bold
    {24, 22, 2376},  // italic
    {24, 22, 2400},  // underline
    {24, 22, 2424},  // h1
    {24, 22, 2448},  // h2
    {24, 22, 2472},  // h3
    {24, 22, 2496},  // sigma
    {24, 22, 2520},  // dollar
    {24, 22, 2544},  // clear_format
    {24, 22, 2568},  // format_painter
    {24, 22, 2592},  // format_cells
    {24, 22, 2616},  // fill_down
    {24, 22, 2640},  // fill_right
    {24, 22, 2664},  // row_select
    {24, 22, 2688},  // col_select
    {24, 22, 2712},  // row_plus
    {24, 22, 2736},  // row_minus
    {24, 22, 2760},  // sheet_new
    {24, 22, 2784},  // chart
    {24, 22, 2808},  // filter
    {24, 22, 2832},  // note
    {24, 22, 2856},  // return
    {24, 22, 2880},  // page_break
    {24, 22, 2904},  // spell
    {24, 22, 2928},  // book
    {24, 22, 2952},  // doc_new
    {24, 22, 2976},  // folder
    {24, 22, 3000},  // files
    {24, 22, 3024},  // printer
    {24, 22, 3048},  // goto
    {24, 22, 3072},  // to_end
    {24, 22, 3096},  // to_start
    {24, 22, 3120},  // slide_new
    {24, 22, 3144},  // play_start
    {24, 22, 3168},  // presenter
    {24, 22, 3192},  // screen_black
    {24, 22, 3216},  // laser
    {24, 22, 3240},  // eye
    {24, 22, 3264},  // eye_off
    {24, 22, 3288},  // star
    {24, 22, 3312},  // clock
    {24, 22, 3336},  // url
    {24, 22, 3360},  // window_new
    {24, 22, 3384},  // incognito
    {24, 22, 3408},  // download
    {24, 22, 3432},  // fullscreen
    {24, 22, 3456},  // back10
    {24, 22, 3480},  // fwd10
    {24, 22, 3504},  // cc
    {24, 22, 3528},  // restart
    {24, 22, 3552},  // theater
    {24, 22, 3576},  // mini_player
    {24, 22, 3600},  // zoom100
    {24, 22, 3624},  // label_net
    {24, 22, 3648},  // label_global
    {24, 22, 3672},  // label_hier
    {24, 22, 3696},  // power_sym
    {24, 22, 3720},  // ground
    {24, 22, 3744},  // bus
    {24, 22, 3768},  // junction
    {24, 22, 3792},  // no_connect
    {24, 22, 3816},  // annotate
    {24, 22, 3840},  // hammer
    {24, 22, 3864},  // find_similar
    {24, 22, 3888},  // sliders
    {24, 22, 3912},  // cross_select
    {24, 22, 3936},  // mirror_h
    {24, 22, 3960},  // mirror_v
    {24, 22, 3984},  // clear_hl
    {24, 22, 4008},  // to_pcb
    {24, 22, 4032},  // to_sch
    {24, 22, 4056},  // diff_pair
    {24, 22, 4080},  // layers
    {24, 22, 4104},  // layer_one
    {24, 22, 4128},  // layer_up
    {24, 22, 4152},  // layer_down
    {24, 22, 4176},  // rotate
    {24, 22, 4200},  // polygon
    {24, 22, 4224},  // bucket
    {24, 22, 4248},  // bucket_off
    {24, 22, 4272},  // route_mode
    {24, 22, 4296},  // track_width
    {24, 22, 4320},  // via_size
    {24, 22, 4344},  // flip
    {24, 22, 4368},  // tuning
    {24, 22, 4392},  // view2d
    {24, 22, 4416},  // units
    {24, 22, 4440},  // teardrop
    {24, 22, 4464},  // pdf
    {24, 22, 4488},  // tab_prev
    {24, 22, 4512},  // tab_next
    {24, 22, 4536},  // footprint
    {24, 22, 4560},  // drag
    {24, 22, 4584},  // sel_conn
    {24, 22, 4608},  // contrast
    {24, 22, 4632},  // repeat
    {24, 22, 4656},  // capacitor
    {24, 22, 4680},  // inductor
    {24, 22, 4704},  // diode
    {24, 22, 4728},  // spice
    {24, 22, 4752},  // line_tool
    {24, 22, 4776},  // rect_tool
    {24, 22, 4800},  // circle_tool
    {24, 22, 4824},  // dimension
    {24, 22, 4848},  // trim_sketch
    {24, 22, 4872},  // offset
    {24, 22, 4896},  // construction
    {24, 22, 4920},  // project_down
    {24, 22, 4944},  // extrude
    {24, 22, 4968},  // press_pull
    {24, 22, 4992},  // fillet
    {24, 22, 5016},  // hole
    {24, 22, 5040},  // joint
    {24, 22, 5064},  // command
    {24, 22, 5088},  // palette
    {24, 22, 5112},  // arrow_left
    {24, 22, 5136},  // arrow_right
    {24, 22, 5160},  // braces
    {24, 22, 5184},  // breakpoint
    {24, 22, 5208},  // bug
    {24, 22, 5232},  // bulb
    {24, 22, 5256},  // comment
    {24, 22, 5280},  // uncomment
    {24, 22, 5304},  // del_line
    {24, 22, 5328},  // dup_line
    {24, 22, 5352},  // line_up
    {24, 22, 5376},  // line_down
    {24, 22, 5400},  // multi_cursor
    {24, 22, 5424},  // extensions
    {24, 22, 5448},  // file_search
    {24, 22, 5472},  // find_all
    {24, 22, 5496},  // fold
    {24, 22, 5520},  // unfold
    {24, 22, 5544},  // format_code
    {24, 22, 5568},  // git
    {24, 22, 5592},  // goto_def
    {24, 22, 5616},  // refs
    {24, 22, 5640},  // rename
    {24, 22, 5664},  // replace
    {24, 22, 5688},  // panel
    {24, 22, 5712},  // sidebar
    {24, 22, 5736},  // warning
    {24, 22, 5760},  // tab_close
    {24, 22, 5784},  // tab_new
    {24, 22, 5808},  // tab_undo
    {24, 22, 5832},  // zen
    {24, 22, 5856},  // close_all
    {24, 22, 5880},  // save_all
    {24, 22, 5904},  // save_as
    {24, 22, 5928},  // step_over
    {24, 22, 5952},  // step_in
    {24, 22, 5976},  // step_out
    {24, 22, 6000},  // wrap
    {24, 22, 6024},  // desktop
    {24, 22, 6048},  // task_view
    {24, 22, 6072},  // desk_left
    {24, 22, 6096},  // desk_right
    {24, 22, 6120},  // desk_new
    {24, 22, 6144},  // desk_close
    {24, 22, 6168},  // snap_left
    {24, 22, 6192},  // snap_right
    {24, 22, 6216},  // maximize
    {24, 22, 6240},  // minimize
    {24, 22, 6264},  // monitors
    {24, 22, 6288},  // clipboard
    {24, 22, 6312},  // smile
    {24, 22, 6336},  // speaker_off
    {24, 22, 6360},  // mic
    {24, 22, 6384},  // mic_off
    {24, 22, 6408},  // mail
    {24, 22, 6432},  // record
    {24, 22, 6456},  // gamepad
    {24, 22, 6480},  // bell
    {24, 22, 6504},  // widgets
    {24, 22, 6528},  // run_box
    {24, 22, 6552},  // balance
    {24, 22, 6576},  // bandage
    {24, 22, 6600},  // camera
    {24, 22, 6624},  // canvas
    {24, 22, 6648},  // clip_mask
    {24, 22, 6672},  // colors_default
    {24, 22, 6696},  // swap
    {24, 22, 6720},  // curves
    {24, 22, 6744},  // levels
    {24, 22, 6768},  // huesat
    {24, 22, 6792},  // image_size
    {24, 22, 6816},  // invert
    {24, 22, 6840},  // magic
    {24, 22, 6864},  // merge
    {24, 22, 6888},  // quick_mask
    {24, 22, 6912},  // select_inverse
    {24, 22, 6936},  // deselect
    {24, 22, 6960},  // stamp
    {24, 22, 6984},  // dodge
    {24, 22, 7008},  // transform
    {24, 22, 7032},  // add_edit
    {24, 22, 7056},  // trim_prev
    {24, 22, 7080},  // trim_next
    {24, 22, 7104},  // mark_in
    {24, 22, 7128},  // mark_out
    {24, 22, 7152},  // mark_clip
    {24, 22, 7176},  // edit_prev
    {24, 22, 7200},  // edit_next
    {24, 22, 7224},  // match_frame
    {24, 22, 7248},  // magnet
    {24, 22, 7272},  // render
    {24, 22, 7296},  // ripple_edit
    {24, 22, 7320},  // track_select
    {24, 22, 7344},  // crossfade
    {24, 22, 7368},  // mole
    {24, 22, 7392},  // simon
    {24, 22, 7416},  // radio
    {24, 22, 7440},  // reflejos
    {24, 22, 7464},  // list
    {24, 22, 7488},  // missile
    {24, 22, 7512},  // cards
    {34, 18, 7536},  // toggle_on
    {34, 18, 7570},  // toggle_off
    {7, 7, 7604},  // dot_on
    {7, 7, 7611},  // dot_off
};

enum : uint16_t {
    SPR_COPY = 0,
    SPR_PASTE = 1,
    SPR_CUT = 2,
    SPR_UNDO = 3,
    SPR_REDO = 4,
    SPR_SELECT_ALL = 5,
    SPR_SAVE = 6,
    SPR_FIND = 7,
    SPR_CLOSE = 8,
    SPR_SCREENSHOT = 9,
    SPR_TABLE = 10,
    SPR_DOCUMENT = 11,
    SPR_GLOBE = 12,
    SPR_CALCULATOR = 13,
    SPR_ACTIVITY = 14,
    SPR_LOCK = 15,
    SPR_PLAY_PAUSE = 16,
    SPR_PLAY = 17,
    SPR_STOP = 18,
    SPR_NEXT = 19,
    SPR_PREV = 20,
    SPR_BRUSH = 21,
    SPR_ERASER = 22,
    SPR_PENCIL = 23,
    SPR_LASSO = 24,
    SPR_CROP = 25,
    SPR_MOVE = 26,
    SPR_LAYER_NEW = 27,
    SPR_DUPLICATE = 28,
    SPR_ZOOM = 29,
    SPR_HAND = 30,
    SPR_TEXT = 31,
    SPR_GRADIENT = 32,
    SPR_PEN = 33,
    SPR_SHAPES = 34,
    SPR_EYEDROPPER = 35,
    SPR_MARQUEE = 36,
    SPR_SELECT = 37,
    SPR_SLICE = 38,
    SPR_PATH_SELECT = 39,
    SPR_POINTER = 40,
    SPR_WIRE = 41,
    SPR_PORT = 42,
    SPR_PAD = 43,
    SPR_VIA = 44,
    SPR_TRACK = 45,
    SPR_FIT = 46,
    SPR_CUBE = 47,
    SPR_SCHEMATIC = 48,
    SPR_PCB = 49,
    SPR_LIBRARY = 50,
    SPR_CHIP = 51,
    SPR_GRID = 52,
    SPR_RULER = 53,
    SPR_CHECKLIST = 54,
    SPR_BOLT = 55,
    SPR_CHECK_BOX = 56,
    SPR_GEAR = 57,
    SPR_RAZOR = 58,
    SPR_MARKER = 59,
    SPR_LINK = 60,
    SPR_RIPPLE = 61,
    SPR_EXPORT = 62,
    SPR_NEST = 63,
    SPR_SLIP = 64,
    SPR_SLIDE = 65,
    SPR_TRIM = 66,
    SPR_RATE = 67,
    SPR_ROLL = 68,
    SPR_SPEED = 69,
    SPR_BRIEFCASE = 70,
    SPR_FILM = 71,
    SPR_PROFILES = 72,
    SPR_MOON = 73,
    SPR_MOON_OFF = 74,
    SPR_WHEEL = 75,
    SPR_RESET = 76,
    SPR_INFO = 77,
    SPR_HELP = 78,
    SPR_EXIT = 79,
    SPR_BACK = 80,
    SPR_TIMER1 = 81,
    SPR_TIMER5 = 82,
    SPR_TIMER10 = 83,
    SPR_TRASH = 84,
    SPR_XMARK = 85,
    SPR_PC = 86,
    SPR_PC_OFF = 87,
    SPR_CALENDAR = 88,
    SPR_PAGES = 89,
    SPR_SINE = 90,
    SPR_CODE = 91,
    SPR_WINDOWS = 92,
    SPR_SLIDES = 93,
    SPR_ALIGN_L = 94,
    SPR_ALIGN_C = 95,
    SPR_ALIGN_R = 96,
    SPR_ALIGN_J = 97,
    SPR_BOLD = 98,
    SPR_ITALIC = 99,
    SPR_UNDERLINE = 100,
    SPR_H1 = 101,
    SPR_H2 = 102,
    SPR_H3 = 103,
    SPR_SIGMA = 104,
    SPR_DOLLAR = 105,
    SPR_CLEAR_FORMAT = 106,
    SPR_FORMAT_PAINTER = 107,
    SPR_FORMAT_CELLS = 108,
    SPR_FILL_DOWN = 109,
    SPR_FILL_RIGHT = 110,
    SPR_ROW_SELECT = 111,
    SPR_COL_SELECT = 112,
    SPR_ROW_PLUS = 113,
    SPR_ROW_MINUS = 114,
    SPR_SHEET_NEW = 115,
    SPR_CHART = 116,
    SPR_FILTER = 117,
    SPR_NOTE = 118,
    SPR_RETURN = 119,
    SPR_PAGE_BREAK = 120,
    SPR_SPELL = 121,
    SPR_BOOK = 122,
    SPR_DOC_NEW = 123,
    SPR_FOLDER = 124,
    SPR_FILES = 125,
    SPR_PRINTER = 126,
    SPR_GOTO = 127,
    SPR_TO_END = 128,
    SPR_TO_START = 129,
    SPR_SLIDE_NEW = 130,
    SPR_PLAY_START = 131,
    SPR_PRESENTER = 132,
    SPR_SCREEN_BLACK = 133,
    SPR_LASER = 134,
    SPR_EYE = 135,
    SPR_EYE_OFF = 136,
    SPR_STAR = 137,
    SPR_CLOCK = 138,
    SPR_URL = 139,
    SPR_WINDOW_NEW = 140,
    SPR_INCOGNITO = 141,
    SPR_DOWNLOAD = 142,
    SPR_FULLSCREEN = 143,
    SPR_BACK10 = 144,
    SPR_FWD10 = 145,
    SPR_CC = 146,
    SPR_RESTART = 147,
    SPR_THEATER = 148,
    SPR_MINI_PLAYER = 149,
    SPR_ZOOM100 = 150,
    SPR_LABEL_NET = 151,
    SPR_LABEL_GLOBAL = 152,
    SPR_LABEL_HIER = 153,
    SPR_POWER_SYM = 154,
    SPR_GROUND = 155,
    SPR_BUS = 156,
    SPR_JUNCTION = 157,
    SPR_NO_CONNECT = 158,
    SPR_ANNOTATE = 159,
    SPR_HAMMER = 160,
    SPR_FIND_SIMILAR = 161,
    SPR_SLIDERS = 162,
    SPR_CROSS_SELECT = 163,
    SPR_MIRROR_H = 164,
    SPR_MIRROR_V = 165,
    SPR_CLEAR_HL = 166,
    SPR_TO_PCB = 167,
    SPR_TO_SCH = 168,
    SPR_DIFF_PAIR = 169,
    SPR_LAYERS = 170,
    SPR_LAYER_ONE = 171,
    SPR_LAYER_UP = 172,
    SPR_LAYER_DOWN = 173,
    SPR_ROTATE = 174,
    SPR_POLYGON = 175,
    SPR_BUCKET = 176,
    SPR_BUCKET_OFF = 177,
    SPR_ROUTE_MODE = 178,
    SPR_TRACK_WIDTH = 179,
    SPR_VIA_SIZE = 180,
    SPR_FLIP = 181,
    SPR_TUNING = 182,
    SPR_VIEW2D = 183,
    SPR_UNITS = 184,
    SPR_TEARDROP = 185,
    SPR_PDF = 186,
    SPR_TAB_PREV = 187,
    SPR_TAB_NEXT = 188,
    SPR_FOOTPRINT = 189,
    SPR_DRAG = 190,
    SPR_SEL_CONN = 191,
    SPR_CONTRAST = 192,
    SPR_REPEAT = 193,
    SPR_CAPACITOR = 194,
    SPR_INDUCTOR = 195,
    SPR_DIODE = 196,
    SPR_SPICE = 197,
    SPR_LINE_TOOL = 198,
    SPR_RECT_TOOL = 199,
    SPR_CIRCLE_TOOL = 200,
    SPR_DIMENSION = 201,
    SPR_TRIM_SKETCH = 202,
    SPR_OFFSET = 203,
    SPR_CONSTRUCTION = 204,
    SPR_PROJECT_DOWN = 205,
    SPR_EXTRUDE = 206,
    SPR_PRESS_PULL = 207,
    SPR_FILLET = 208,
    SPR_HOLE = 209,
    SPR_JOINT = 210,
    SPR_COMMAND = 211,
    SPR_PALETTE = 212,
    SPR_ARROW_LEFT = 213,
    SPR_ARROW_RIGHT = 214,
    SPR_BRACES = 215,
    SPR_BREAKPOINT = 216,
    SPR_BUG = 217,
    SPR_BULB = 218,
    SPR_COMMENT = 219,
    SPR_UNCOMMENT = 220,
    SPR_DEL_LINE = 221,
    SPR_DUP_LINE = 222,
    SPR_LINE_UP = 223,
    SPR_LINE_DOWN = 224,
    SPR_MULTI_CURSOR = 225,
    SPR_EXTENSIONS = 226,
    SPR_FILE_SEARCH = 227,
    SPR_FIND_ALL = 228,
    SPR_FOLD = 229,
    SPR_UNFOLD = 230,
    SPR_FORMAT_CODE = 231,
    SPR_GIT = 232,
    SPR_GOTO_DEF = 233,
    SPR_REFS = 234,
    SPR_RENAME = 235,
    SPR_REPLACE = 236,
    SPR_PANEL = 237,
    SPR_SIDEBAR = 238,
    SPR_WARNING = 239,
    SPR_TAB_CLOSE = 240,
    SPR_TAB_NEW = 241,
    SPR_TAB_UNDO = 242,
    SPR_ZEN = 243,
    SPR_CLOSE_ALL = 244,
    SPR_SAVE_ALL = 245,
    SPR_SAVE_AS = 246,
    SPR_STEP_OVER = 247,
    SPR_STEP_IN = 248,
    SPR_STEP_OUT = 249,
    SPR_WRAP = 250,
    SPR_DESKTOP = 251,
    SPR_TASK_VIEW = 252,
    SPR_DESK_LEFT = 253,
    SPR_DESK_RIGHT = 254,
    SPR_DESK_NEW = 255,
    SPR_DESK_CLOSE = 256,
    SPR_SNAP_LEFT = 257,
    SPR_SNAP_RIGHT = 258,
    SPR_MAXIMIZE = 259,
    SPR_MINIMIZE = 260,
    SPR_MONITORS = 261,
    SPR_CLIPBOARD = 262,
    SPR_SMILE = 263,
    SPR_SPEAKER_OFF = 264,
    SPR_MIC = 265,
    SPR_MIC_OFF = 266,
    SPR_MAIL = 267,
    SPR_RECORD = 268,
    SPR_GAMEPAD = 269,
    SPR_BELL = 270,
    SPR_WIDGETS = 271,
    SPR_RUN_BOX = 272,
    SPR_BALANCE = 273,
    SPR_BANDAGE = 274,
    SPR_CAMERA = 275,
    SPR_CANVAS = 276,
    SPR_CLIP_MASK = 277,
    SPR_COLORS_DEFAULT = 278,
    SPR_SWAP = 279,
    SPR_CURVES = 280,
    SPR_LEVELS = 281,
    SPR_HUESAT = 282,
    SPR_IMAGE_SIZE = 283,
    SPR_INVERT = 284,
    SPR_MAGIC = 285,
    SPR_MERGE = 286,
    SPR_QUICK_MASK = 287,
    SPR_SELECT_INVERSE = 288,
    SPR_DESELECT = 289,
    SPR_STAMP = 290,
    SPR_DODGE = 291,
    SPR_TRANSFORM = 292,
    SPR_ADD_EDIT = 293,
    SPR_TRIM_PREV = 294,
    SPR_TRIM_NEXT = 295,
    SPR_MARK_IN = 296,
    SPR_MARK_OUT = 297,
    SPR_MARK_CLIP = 298,
    SPR_EDIT_PREV = 299,
    SPR_EDIT_NEXT = 300,
    SPR_MATCH_FRAME = 301,
    SPR_MAGNET = 302,
    SPR_RENDER = 303,
    SPR_RIPPLE_EDIT = 304,
    SPR_TRACK_SELECT = 305,
    SPR_CROSSFADE = 306,
    SPR_MOLE = 307,
    SPR_SIMON = 308,
    SPR_RADIO = 309,
    SPR_REFLEJOS = 310,
    SPR_LIST = 311,
    SPR_MISSILE = 312,
    SPR_CARDS = 313,
    SPR_TOGGLE_ON = 314,
    SPR_TOGGLE_OFF = 315,
    SPR_DOT_ON = 316,
    SPR_DOT_OFF = 317,
    SPR_COUNT
};

// Iconos grandes de las teclas (x1.5): BIG_W columnas de 5 bytes por icono,
// bit 0 del primer byte arriba. Solo los iconos, no las piezas de interfaz.
static constexpr int BIG_W = 36, BIG_H = 33;
static const uint16_t BIG_COUNT = 314;
static const uint8_t big_icon_cols[] = {
    0x00, 0x00, 0x00, 0x00, 0x00, 0x00, 0x00, 0x00, 0x00, 0x00, 0x00, 0x00, 0x00, 0x00, 0x00, 0xf0, 0xff, 0x0f, 0x00, 0x00,
    0xf8, 0xff, 0x1f, 0x00, 0x00, 0xfc, 0xff, 0x3f, 0x00, 0x00, 0x1c, 0x00, 0x38, 0x00, 0x00, 0x1e, 0x00, 0x78, 0x00, 0x00,
    0x1e, 0x00, 0x78, 0x00, 0x00, 0x1e, 0x00, 0x78, 0x00, 0x00, 0x1e, 0x00, 0x30, 0x00, 0x00, 0x1e, 0x00, 0x00, 0x00, 0x00,
    0x1e, 0xe0, 0xff, 0x1f, 0x00, 0x1e, 0xf0, 0xff, 0x3f, 0x00, 0x1e, 0xf8, 0xff, 0x7f, 0x00, 0x1e, 0x38, 0x00, 0x70, 0x00,
    0x1e, 0x3c, 0x00, 0xf0, 0x00, 0x1e, 0x3c, 0x00, 0xf0, 0x00, 0x1c, 0x3c, 0x00, 0xf0, 0x00, 0xfc, 0x3d, 0x00, 0xf0, 0x00,
    0xfc, 0x3d, 0x00, 0xf0, 0x00, 0xf8, 0x3d, 0x00, 0xf0, 0x00, 0xc0, 0x3d, 0x00, 0xf0, 0x00, 0x00, 0x3c, 0x00, 0xf0, 0x00,
    0x00, 0x3c, 0x00, 0xf0, 0x00, 0x00, 0x3c, 0x00, 0xf0, 0x00, 0x00, 0x3c, 0x00, 0xf0, 0x00, 0x00, 0x3c, 0x00, 0xf0, 0x00,
    0x00, 0x3c, 0x00, 0xf0, 0x00, 0x00, 0x38, 0x00, 0x70, 0x00, 0x00, 0xf8, 0xff, 0x7f, 0x00, 0x00, 0xf0, 0xff, 0x3f, 0x00,
    0x00, 0xe0, 0xff, 0x1f, 0x00, 0x00, 0x00, 0x00, 0x00, 0x00, 0x00, 0x00, 0x00, 0x00, 0x00, 0x00, 0x00, 0x00, 0x00, 0x00,
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
    0x00, 0xe0, 0xff, 0x03, 0x00, 0x00, 0xf0, 0xc1, 0x07, 0x00, 0x00, 0x78, 0x00, 0x0f, 0x00, 0x00, 0x3c, 0x00, 0x1e, 0x00,
    0x00, 0x1c, 0x00, 0x1c, 0x00, 0x00, 0x1e, 0x00, 0x3c, 0x00, 0x00, 0x0e, 0x00, 0x38, 0x00, 0x00, 0x0e, 0x00, 0x38, 0x00,
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
};

// Etiqueta de tecla → icono y nombre. «PERFIL/ETIQUETA» gana a la genérica;
// «@NOMBRE» es el icono de un perfil en el menú de perfiles.
static const Entry entries[] = {
    {"COPY", SPR_COPY, "Copiar"},
    {"PAST", SPR_PASTE, "Pegar"},
    {"CUT", SPR_CUT, "Cortar"},
    {"UNDO", SPR_UNDO, "Deshacer"},
    {"REDO", SPR_REDO, "Rehacer"},
    {"ALL", SPR_SELECT_ALL, "Todo"},
    {"SAVE", SPR_SAVE, "Guardar"},
    {"FIND", SPR_FIND, "Buscar"},
    {"CLSE", SPR_CLOSE, "Cerrar"},
    {"SNAP", SPR_SCREENSHOT, "Captura"},
    {"EXCL", SPR_TABLE, "Excel"},
    {"WORD", SPR_DOCUMENT, "Word"},
    {"BROW", SPR_GLOBE, "Navegador"},
    {"CALC", SPR_CALCULATOR, "Calculadora"},
    {"TASK", SPR_ACTIVITY, "Tareas"},
    {"LOCK", SPR_LOCK, "Bloquear"},
    {"PLAY", SPR_PLAY_PAUSE, "Reproducir"},
    {"STOP", SPR_STOP, "Detener"},
    {"NEXT", SPR_NEXT, "Siguiente"},
    {"PREV", SPR_PREV, "Anterior"},
    {"BRSH", SPR_BRUSH, "Pincel"},
    {"ERAS", SPR_ERASER, "Borrador"},
    {"PENC", SPR_PENCIL, "Lápiz"},
    {"LASS", SPR_LASSO, "Lazo"},
    {"CROP", SPR_CROP, "Recortar"},
    {"MOVE", SPR_MOVE, "Mover"},
    {"NEWL", SPR_LAYER_NEW, "Capa nueva"},
    {"DUPL", SPR_DUPLICATE, "Duplicar"},
    {"ZOOM", SPR_ZOOM, "Zoom"},
    {"HAND", SPR_HAND, "Mano"},
    {"TEXT", SPR_TEXT, "Texto"},
    {"GRAD", SPR_GRADIENT, "Degradado"},
    {"PEN", SPR_PEN, "Pluma"},
    {"SHAP", SPR_SHAPES, "Forma"},
    {"EYE", SPR_EYEDROPPER, "Cuentagotas"},
    {"SELC", SPR_SELECT, "Selección"},
    {"SLIC", SPR_SLICE, "Sector"},
    {"PATH", SPR_PATH_SELECT, "Trazado"},
    {"WIRE", SPR_WIRE, "Cable"},
    {"PORT", SPR_PORT, "Puerto"},
    {"PAD", SPR_PAD, "Pad"},
    {"VIA", SPR_VIA, "Vía"},
    {"TRAC", SPR_TRACK, "Pista"},
    {"FIT", SPR_FIT, "Encuadrar"},
    {"3D", SPR_CUBE, "Vista 3D"},
    {"SCH", SPR_SCHEMATIC, "Esquema"},
    {"PCB", SPR_PCB, "PCB"},
    {"LIB", SPR_LIBRARY, "Librería"},
    {"COMP", SPR_CHIP, "Componente"},
    {"GRID", SPR_GRID, "Rejilla"},
    {"MEAS", SPR_RULER, "Medir"},
    {"RULE", SPR_CHECKLIST, "Reglas"},
    {"ERC", SPR_BOLT, "ERC"},
    {"DRC", SPR_CHECK_BOX, "DRC"},
    {"GEN", SPR_GEAR, "Opciones"},
    {"MARK", SPR_MARKER, "Marcador"},
    {"LINK", SPR_LINK, "Vincular"},
    {"RIPL", SPR_RIPPLE, "Borrar rizo"},
    {"EXPO", SPR_EXPORT, "Exportar"},
    {"NEST", SPR_NEST, "Anidar"},
    {"SLIP", SPR_SLIP, "Desplazar"},
    {"SLID", SPR_SLIDE, "Deslizar"},
    {"TRIM", SPR_TRIM, "Recorte"},
    {"RATE", SPR_RATE, "Estirar"},
    {"ROLL", SPR_ROLL, "Rotación"},
    {"SPED", SPR_SPEED, "Velocidad"},
    {"PREM/CUT", SPR_RAZOR, "Cuchilla"},
    {"PREM/SELC", SPR_POINTER, "Selección"},
    {"PHTS/SELC", SPR_MARQUEE, "Marco"},
    {"@OFIM", SPR_BRIEFCASE, "Oficina"},
    {"@PHTS", SPR_BRUSH, "Photoshop"},
    {"@ALTM", SPR_CHIP, "Altium"},
    {"@PREM", SPR_FILM, "Premiere"},
    {"@ALTIUM", SPR_PCB, "Altium"},
    {"@KICAD", SPR_SCHEMATIC, "KiCad"},
    {"@FUSION", SPR_CUBE, "Fusion 360"},
    {"@LTSPICE", SPR_SINE, "LTspice"},
    {"@VSCODE", SPR_CODE, "VS Code"},
    {"@WINDOWS", SPR_WINDOWS, "Windows"},
    {"@WEB", SPR_GLOBE, "Navegador"},
    {"@EXCEL", SPR_TABLE, "Excel"},
    {"@WORD", SPR_DOCUMENT, "Word"},
    {"@PPOINT", SPR_SLIDES, "PowerPoint"},
    {"@PSHOP", SPR_BRUSH, "Photoshop"},
    {"@PREMIER", SPR_FILM, "Premiere"},
    {"NETLBL", SPR_LABEL_NET, "Etiqueta red"},
    {"GLOBLBL", SPR_LABEL_GLOBAL, "Etiq. global"},
    {"HIERLBL", SPR_LABEL_HIER, "Etiq. jerárq."},
    {"POWER", SPR_POWER_SYM, "Alimentación"},
    {"GND", SPR_GROUND, "Masa"},
    {"BUS", SPR_BUS, "Bus"},
    {"JUNCT", SPR_JUNCTION, "Unión"},
    {"NOCONN", SPR_NO_CONNECT, "Sin conexión"},
    {"NOERC", SPR_NO_CONNECT, "No ERC"},
    {"ANNOT", SPR_ANNOTATE, "Anotar"},
    {"COMPILE", SPR_HAMMER, "Compilar"},
    {"SIMILAR", SPR_FIND_SIMILAR, "Similares"},
    {"PROPS", SPR_SLIDERS, "Propiedades"},
    {"XSEL", SPR_CROSS_SELECT, "Sel. cruzada"},
    {"MIRRORX", SPR_MIRROR_H, "Espejo X"},
    {"MIRRORY", SPR_MIRROR_V, "Espejo Y"},
    {"MIRROR", SPR_MIRROR_H, "Espejo"},
    {"CLEAR", SPR_CLEAR_HL, "Limpiar"},
    {"TOPCB", SPR_TO_PCB, "Actualizar PCB"},
    {"TOSCH", SPR_TO_SCH, "Act. esquema"},
    {"ROUTE", SPR_TRACK, "Rutar"},
    {"DIFFPR", SPR_DIFF_PAIR, "Par dif."},
    {"LAYPREV", SPR_LAYER_UP, "Capa ant."},
    {"LAYNEXT", SPR_LAYER_DOWN, "Capa sig."},
    {"ONELAY", SPR_LAYER_ONE, "Capa única"},
    {"LAYERS", SPR_LAYERS, "Capas"},
    {"ROTATE", SPR_ROTATE, "Girar"},
    {"POLYGON", SPR_POLYGON, "Polígono"},
    {"FILL", SPR_BUCKET, "Relleno"},
    {"RTMODE", SPR_ROUTE_MODE, "Modo rutado"},
    {"WIDTH", SPR_TRACK_WIDTH, "Ancho"},
    {"VIASIZE", SPR_VIA_SIZE, "Tamaño vía"},
    {"FLIPSD", SPR_FLIP, "Cambiar cara"},
    {"FLIPBRD", SPR_FLIP, "Voltear placa"},
    {"TUNING", SPR_TUNING, "Ajuste long."},
    {"VIEW2D", SPR_VIEW2D, "Vista 2D"},
    {"UNITS", SPR_UNITS, "Unidades"},
    {"REPOUR", SPR_BUCKET, "Repoblar"},
    {"TEARDRP", SPR_TEARDROP, "Lágrimas"},
    {"SMRTPDF", SPR_PDF, "Smart PDF"},
    {"BOM", SPR_CHECKLIST, "Materiales"},
    {"DOCPREV", SPR_TAB_PREV, "Doc. anterior"},
    {"DOCNEXT", SPR_TAB_NEXT, "Doc. siguiente"},
    {"FILLZN", SPR_BUCKET, "Rellenar zonas"},
    {"UNFILL", SPR_BUCKET_OFF, "Vaciar zonas"},
    {"FOOTPR", SPR_FOOTPRINT, "Huella"},
    {"DRAG", SPR_DRAG, "Arrastrar"},
    {"SELCONN", SPR_SEL_CONN, "Sel. conexión"},
    {"CONTRST", SPR_CONTRAST, "Alto contraste"},
    {"REPEAT", SPR_REPEAT, "Repetir"},
    {"RES", SPR_SCHEMATIC, "Resistencia"},
    {"CAP", SPR_CAPACITOR, "Condensador"},
    {"IND", SPR_INDUCTOR, "Bobina"},
    {"DIODE", SPR_DIODE, "Diodo"},
    {"SPICE", SPR_SPICE, "Directiva"},
    {"DELETE", SPR_TRASH, "Borrar"},
    {"LINE", SPR_LINE_TOOL, "Línea"},
    {"RECT", SPR_RECT_TOOL, "Rectángulo"},
    {"CIRCLE", SPR_CIRCLE_TOOL, "Círculo"},
    {"DIM", SPR_DIMENSION, "Cota"},
    {"FUSION/TRIM", SPR_TRIM_SKETCH, "Recortar"},
    {"OFFSET", SPR_OFFSET, "Desfase"},
    {"CONSTR", SPR_CONSTRUCTION, "Construcción"},
    {"PROJECT", SPR_PROJECT_DOWN, "Proyectar"},
    {"EXTRUDE", SPR_EXTRUDE, "Extruir"},
    {"PRESSPL", SPR_PRESS_PULL, "Presionar"},
    {"FILLET", SPR_FILLET, "Empalme"},
    {"HOLE", SPR_HOLE, "Agujero"},
    {"JOINT", SPR_JOINT, "Unión"},
    {"TOOLBOX", SPR_COMMAND, "Buscar orden"},
    {"VISIBLE", SPR_EYE, "Mostrar"},
    {"APPEAR", SPR_PALETTE, "Aspecto"},
    {"COMPUTE", SPR_RESET, "Recalcular"},
    {"PALETTE", SPR_COMMAND, "Comandos"},
    {"GOFILE", SPR_FILE_SEARCH, "Ir a archivo"},
    {"FINDALL", SPR_FIND_ALL, "Buscar todo"},
    {"MULTSEL", SPR_MULTI_CURSOR, "Multicursor"},
    {"LINEUP", SPR_LINE_UP, "Subir línea"},
    {"LINEDN", SPR_LINE_DOWN, "Bajar línea"},
    {"DUPLINE", SPR_DUP_LINE, "Duplicar línea"},
    {"FORMAT", SPR_FORMAT_CODE, "Formatear"},
    {"RENAME", SPR_RENAME, "Renombrar"},
    {"REPLACE", SPR_REPLACE, "Reemplazar"},
    {"GODEF", SPR_GOTO_DEF, "Definición"},
    {"REFS", SPR_REFS, "Referencias"},
    {"NAVBACK", SPR_ARROW_LEFT, "Atrás"},
    {"NAVFWD", SPR_ARROW_RIGHT, "Adelante"},
    {"DELLINE", SPR_DEL_LINE, "Borrar línea"},
    {"QFIX", SPR_BULB, "Arreglo rápido"},
    {"SYMBOL", SPR_BRACES, "Ir a símbolo"},
    {"COMMENT", SPR_COMMENT, "Comentar"},
    {"UNCOMM", SPR_UNCOMMENT, "Descomentar"},
    {"EXPLR", SPR_FILES, "Explorador"},
    {"GIT", SPR_GIT, "Git"},
    {"EXTENS", SPR_EXTENSIONS, "Extensiones"},
    {"SIDEBAR", SPR_SIDEBAR, "Barra lateral"},
    {"PANEL", SPR_PANEL, "Panel"},
    {"PROBLEM", SPR_WARNING, "Problemas"},
    {"TABPREV", SPR_TAB_PREV, "Pestaña ant."},
    {"TABNEXT", SPR_TAB_NEXT, "Pestaña sig."},
    {"TABCLOS", SPR_TAB_CLOSE, "Cerrar pest."},
    {"TABNEW", SPR_TAB_NEW, "Nueva pestaña"},
    {"TABUNDO", SPR_TAB_UNDO, "Reabrir pest."},
    {"ZEN", SPR_ZEN, "Modo zen"},
    {"NEWFILE", SPR_DOC_NEW, "Nuevo archivo"},
    {"OPENFLD", SPR_FOLDER, "Abrir carpeta"},
    {"SETTING", SPR_GEAR, "Ajustes"},
    {"WRAP", SPR_WRAP, "Ajuste línea"},
    {"MDPREV", SPR_EYE, "Vista previa"},
    {"CLOSEAL", SPR_CLOSE_ALL, "Cerrar todo"},
    {"FOLDALL", SPR_FOLD, "Plegar todo"},
    {"UNFOLD", SPR_UNFOLD, "Desplegar"},
    {"SAVEALL", SPR_SAVE_ALL, "Guardar todo"},
    {"REOPEN", SPR_TAB_UNDO, "Reabrir"},
    {"DEBUG", SPR_BUG, "Depurar"},
    {"RUN", SPR_PLAY, "Ejecutar"},
    {"DBGSTOP", SPR_STOP, "Detener"},
    {"STEPOVR", SPR_STEP_OVER, "Saltar"},
    {"STEPIN", SPR_STEP_IN, "Entrar"},
    {"STEPOUT", SPR_STEP_OUT, "Salir"},
    {"BREAKPT", SPR_BREAKPOINT, "Punto parada"},
    {"DBGRST", SPR_RESET, "Reiniciar"},
    {"BUILD", SPR_HAMMER, "Compilar"},
    {"DESK", SPR_DESKTOP, "Escritorio"},
    {"TASKV", SPR_TASK_VIEW, "Vista tareas"},
    {"FILES", SPR_FOLDER, "Archivos"},
    {"SNAPL", SPR_SNAP_LEFT, "A la izquierda"},
    {"SNAPR", SPR_SNAP_RIGHT, "A la derecha"},
    {"MAXIM", SPR_MAXIMIZE, "Maximizar"},
    {"MINIM", SPR_MINIMIZE, "Minimizar"},
    {"MONITOR", SPR_MONITORS, "Otra pantalla"},
    {"CLOSEW", SPR_CLOSE, "Cerrar"},
    {"DESKL", SPR_DESK_LEFT, "Escrit. ant."},
    {"DESKR", SPR_DESK_RIGHT, "Escrit. sig."},
    {"DESKN", SPR_DESK_NEW, "Nuevo escrit."},
    {"DESKX", SPR_DESK_CLOSE, "Cerrar escrit."},
    {"CLIPB", SPR_CLIPBOARD, "Portapapeles"},
    {"EMOJI", SPR_SMILE, "Emojis"},
    {"SEARCH", SPR_FIND, "Buscar"},
    {"MUTE", SPR_SPEAKER_OFF, "Silencio"},
    {"MICMUTE", SPR_MIC_OFF, "Silenciar mic"},
    {"MAIL", SPR_MAIL, "Correo"},
    {"PROJ", SPR_MONITORS, "Proyectar"},
    {"REC", SPR_RECORD, "Grabar"},
    {"GAMEBAR", SPR_GAMEPAD, "Game Bar"},
    {"SHOTFUL", SPR_SCREENSHOT, "Captura total"},
    {"DICTATE", SPR_MIC, "Dictado"},
    {"NOTIF", SPR_BELL, "Notificaciones"},
    {"QUICK", SPR_SLIDERS, "Ajustes ráp."},
    {"WIDGET", SPR_WIDGETS, "Widgets"},
    {"WINDOWS/RUN", SPR_RUN_BOX, "Ejecutar"},
    {"RELOAD", SPR_RESET, "Recargar"},
    {"HRELOAD", SPR_RESET, "Recargar todo"},
    {"URL", SPR_URL, "Dirección"},
    {"WINNEW", SPR_WINDOW_NEW, "Ventana nueva"},
    {"PRIVATE", SPR_INCOGNITO, "Incógnito"},
    {"DOWNLD", SPR_DOWNLOAD, "Descargas"},
    {"HISTORY", SPR_CLOCK, "Historial"},
    {"BOOKMRK", SPR_STAR, "Favorito"},
    {"FULLSCR", SPR_FULLSCREEN, "Completa"},
    {"ZOOMRST", SPR_ZOOM, "Zoom 100 %"},
    {"DEVTOOL", SPR_CODE, "DevTools"},
    {"PRINT", SPR_PRINTER, "Imprimir"},
    {"YTBACK", SPR_BACK10, "-10 s"},
    {"YTFWD", SPR_FWD10, "+10 s"},
    {"YTPREV", SPR_PREV, "Anterior"},
    {"YTNEXT", SPR_NEXT, "Siguiente"},
    {"YTMUTE", SPR_SPEAKER_OFF, "Silenciar"},
    {"CAPTION", SPR_CC, "Subtítulos"},
    {"YTSTART", SPR_RESTART, "Al inicio"},
    {"THEATER", SPR_THEATER, "Modo cine"},
    {"MINIPL", SPR_MINI_PLAYER, "Minirrepr."},
    {"PASTESP", SPR_PASTE, "Pegado esp."},
    {"EDITCEL", SPR_PENCIL, "Editar celda"},
    {"FILLDN", SPR_FILL_DOWN, "Rellenar abajo"},
    {"FILLRT", SPR_FILL_RIGHT, "Rellenar dcha."},
    {"ABSREF", SPR_DOLLAR, "Fijar ref."},
    {"AUTOSUM", SPR_SIGMA, "Autosuma"},
    {"FMTCELL", SPR_FORMAT_CELLS, "Formato celda"},
    {"BOLD", SPR_BOLD, "Negrita"},
    {"ITALIC", SPR_ITALIC, "Cursiva"},
    {"UNDERLN", SPR_UNDERLINE, "Subrayado"},
    {"FILTER", SPR_FILTER, "Filtro"},
    {"CELLNL", SPR_RETURN, "Salto en celda"},
    {"NOTE", SPR_NOTE, "Nota"},
    {"RECALC", SPR_RESET, "Recalcular"},
    {"CHART", SPR_CHART, "Gráfico"},
    {"SELROW", SPR_ROW_SELECT, "Fila"},
    {"SELCOL", SPR_COL_SELECT, "Columna"},
    {"INSROW", SPR_ROW_PLUS, "Insertar"},
    {"DELROW", SPR_ROW_MINUS, "Eliminar"},
    {"HIDEROW", SPR_EYE_OFF, "Ocultar fila"},
    {"GOTO", SPR_GOTO, "Ir a"},
    {"SHEETPV", SPR_TAB_PREV, "Hoja ant."},
    {"SHEETNX", SPR_TAB_NEXT, "Hoja sig."},
    {"NEWSHT", SPR_SHEET_NEW, "Hoja nueva"},
    {"TOEND", SPR_TO_END, "Al final"},
    {"TOSTART", SPR_TO_START, "Al inicio"},
    {"ALIGNL", SPR_ALIGN_L, "Izquierda"},
    {"ALIGNC", SPR_ALIGN_C, "Centrar"},
    {"ALIGNR", SPR_ALIGN_R, "Derecha"},
    {"JUSTIFY", SPR_ALIGN_J, "Justificar"},
    {"COPYFMT", SPR_FORMAT_PAINTER, "Copiar formato"},
    {"PASTFMT", SPR_FORMAT_PAINTER, "Pegar formato"},
    {"CLRFMT", SPR_CLEAR_FORMAT, "Quitar formato"},
    {"HEAD1", SPR_H1, "Título 1"},
    {"HEAD2", SPR_H2, "Título 2"},
    {"HEAD3", SPR_H3, "Título 3"},
    {"HLINK", SPR_LINK, "Hipervínculo"},
    {"PGBREAK", SPR_PAGE_BREAK, "Salto página"},
    {"NEWDOC", SPR_DOC_NEW, "Nuevo"},
    {"OPEN", SPR_FOLDER, "Abrir"},
    {"SPELL", SPR_SPELL, "Ortografía"},
    {"THESAUR", SPR_BOOK, "Sinónimos"},
    {"CLOSEDC", SPR_CLOSE, "Cerrar doc."},
    {"FROMBEG", SPR_PLAY_START, "Desde inicio"},
    {"FROMCUR", SPR_PLAY, "Desde actual"},
    {"PRESVW", SPR_PRESENTER, "Moderador"},
    {"PREVSLD", SPR_ARROW_LEFT, "Anterior"},
    {"NEXTSLD", SPR_ARROW_RIGHT, "Siguiente"},
    {"BLACK", SPR_SCREEN_BLACK, "Pantalla negra"},
    {"LASER", SPR_LASER, "Láser"},
    {"PPOINT/PEN", SPR_PENCIL, "Lápiz"},
    {"ERASINK", SPR_ERASER, "Borrar tinta"},
    {"ENDSHOW", SPR_EXIT, "Terminar"},
    {"NEWSLD", SPR_SLIDE_NEW, "Nueva diapo."},
    {"MARQ", SPR_MARQUEE, "Marco"},
    {"QSELECT", SPR_MAGIC, "Selec. rápida"},
    {"HEAL", SPR_BANDAGE, "Corrector"},
    {"CLONE", SPR_STAMP, "Tampón"},
    {"DODGE", SPR_DODGE, "Sobreexponer"},
    {"ROTVIEW", SPR_ROTATE, "Rotar vista"},
    {"QMASK", SPR_QUICK_MASK, "Máscara ráp."},
    {"MERGE", SPR_MERGE, "Combinar"},
    {"GROUP", SPR_FOLDER, "Agrupar"},
    {"CLIPMSK", SPR_CLIP_MASK, "Máscara rec."},
    {"STAMP", SPR_STAMP, "Sellar visible"},
    {"TRANSF", SPR_TRANSFORM, "Transformar"},
    {"DESELEC", SPR_DESELECT, "Deseleccionar"},
    {"INVSEL", SPR_SELECT_INVERSE, "Invertir sel."},
    {"FILLDLG", SPR_BUCKET, "Rellenar"},
    {"SWAPCLR", SPR_SWAP, "Intercambiar"},
    {"DEFCLR", SPR_COLORS_DEFAULT, "Colores def."},
    {"ZOOM100", SPR_ZOOM100, "100 %"},
    {"SCRMODE", SPR_FULLSCREEN, "Modo pantalla"},
    {"SAVEAS", SPR_SAVE_AS, "Guardar como"},
    {"LEVELS", SPR_LEVELS, "Niveles"},
    {"CURVES", SPR_CURVES, "Curvas"},
    {"HUESAT", SPR_HUESAT, "Tono/sat."},
    {"COLORBL", SPR_BALANCE, "Equilibrio"},
    {"INVERT", SPR_INVERT, "Invertir"},
    {"DESAT", SPR_CONTRAST, "Desaturar"},
    {"IMGSIZE", SPR_IMAGE_SIZE, "Tamaño imagen"},
    {"CANVAS", SPR_CANVAS, "Lienzo"},
    {"AUTOTN", SPR_MAGIC, "Tono auto."},
    {"AUTOCON", SPR_MAGIC, "Contraste auto."},
    {"AUTOCLR", SPR_MAGIC, "Color auto."},
    {"BW", SPR_CONTRAST, "Blanco y negro"},
    {"EXPORT", SPR_EXPORT, "Exportar como"},
    {"PREMIER/CUT", SPR_RAZOR, "Cuchilla"},
    {"PREMIER/SELC", SPR_POINTER, "Selección"},
    {"ADDEDIT", SPR_ADD_EDIT, "Añadir corte"},
    {"TRIMPRV", SPR_TRIM_PREV, "Recortar ant."},
    {"TRIMNXT", SPR_TRIM_NEXT, "Recortar sig."},
    {"MARKIN", SPR_MARK_IN, "Entrada"},
    {"MARKOUT", SPR_MARK_OUT, "Salida"},
    {"MARKCLP", SPR_MARK_CLIP, "Marcar clip"},
    {"PREVEDT", SPR_EDIT_PREV, "Corte ant."},
    {"NEXTEDT", SPR_EDIT_NEXT, "Corte sig."},
    {"MATCHFR", SPR_MATCH_FRAME, "Fot. coincid."},
    {"SNAPTL", SPR_MAGNET, "Ajustar"},
    {"RENDER", SPR_RENDER, "Renderizar"},
    {"RIPEDIT", SPR_RIPPLE_EDIT, "Edición rizo"},
    {"TRKSEL", SPR_TRACK_SELECT, "Sel. pista"},
    {"VTRANS", SPR_CROSSFADE, "Trans. vídeo"},
    {"ATRANS", SPR_CROSSFADE, "Trans. audio"},
    {"BTRANS", SPR_CROSSFADE, "Transiciones"},
    {"EXPFRM", SPR_CAMERA, "Exportar fot."},
    {"#JUEGOS", SPR_GAMEPAD, "Juegos"},
    {"#TOPOS", SPR_MOLE, "Topos"},
    {"#SIMON", SPR_SIMON, "Simon"},
    {"#SINT", SPR_RADIO, "Sintoniza"},
    {"#REFLEJO", SPR_REFLEJOS, "Reflejos"},
    {"#MISIL", SPR_MISSILE, "Air Strike"},
    {"#BLACKJ", SPR_CARDS, "Blackjack"},
    {"#OTRA", SPR_RESET, "Otra vez"},
    {"#MENU", SPR_LIST, "Menú"},
    {"#SALIR", SPR_EXIT, "Salir"},
};

// Pantallas del propio firmware.
enum : uint8_t {
    SYS_MENU_PROFILES = 0,
    SYS_MENU_SLEEP = 1,
    SYS_MENU_WHEEL = 2,
    SYS_MENU_RESET = 3,
    SYS_MENU_INFO = 4,
    SYS_MENU_HELP = 5,
    SYS_MENU_EXIT = 6,
    SYS_BACK = 7,
    SYS_SLEEP_1 = 8,
    SYS_SLEEP_5 = 9,
    SYS_SLEEP_10 = 10,
    SYS_SLEEP_OFF = 11,
    SYS_RESET_YES = 12,
    SYS_RESET_NO = 13,
    SYS_HOST_OK = 14,
    SYS_HOST_NONE = 15,
    SYS_BUILD_DATE = 16,
    SYS_PAGES = 17,
};
static const Entry system_entries[] = {
    {"menu_profiles", SPR_PROFILES, "Perfiles"},
    {"menu_sleep", SPR_MOON, "Reposo"},
    {"menu_wheel", SPR_WHEEL, "Rueda"},
    {"menu_reset", SPR_RESET, "Restablecer"},
    {"menu_info", SPR_INFO, "Info"},
    {"menu_help", SPR_HELP, "Ayuda"},
    {"menu_exit", SPR_EXIT, "Salir"},
    {"back", SPR_BACK, "Volver"},
    {"sleep_1", SPR_TIMER1, "1 min"},
    {"sleep_5", SPR_TIMER5, "5 min"},
    {"sleep_10", SPR_TIMER10, "10 min"},
    {"sleep_off", SPR_MOON_OFF, "Nunca"},
    {"reset_yes", SPR_TRASH, "Sí, borrar"},
    {"reset_no", SPR_XMARK, "No"},
    {"host_ok", SPR_PC, "PC conectado"},
    {"host_none", SPR_PC_OFF, "Sin PC"},
    {"build_date", SPR_CALENDAR, ""},
    {"pages", SPR_PAGES, ""},
};

} // namespace OledUiData
