jaestefaniah27/scroll_wheel/(commit log)

2025-07-31 Se puede ajustar el brillo y el volumen con cada botón de la rueda
2025-07-31 led no se enciende todo el rato al enviar datos
2025-08-01 Añadido soporte para modos de control y mejoras en la gestión de toques: modo navegación: pan y turbo modo editor: undo, pegar, re-do y copiar modo media: brillo y volumen. Para cambiar de modo: puls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
2025-09-17 Actualizado software para adaptarlo al nuevo hardware. Añadidos dos botones con leds. Añadido pequeño motor de vibración. Quitado botones capacitivos.
2025-09-18 probando a hacer la versión bluetooth con esp32
2025-09-18 Añadido sketch para funcionaminento por bluetooth con esp32
2025-09-18 eliminado recentrado y cambiado varaibles de posición a 64 bits para que sea imposible desbordar
2025-09-18 Añadido scroll a la versión bluetooth
2025-09-18 Reorganizado el código para mejorar la legibilidad y corregido el formato de las variables de acumulación de muestras
2025-09-19 Implement button state management and feedback for improved user interaction
2025-09-19 Add modular structure for scroll wheel functionality
    - Created header and implementation files for encoder (encoder_as5600) to handle I2C initialization and position tracking.
    - Introduced event handling with button events (events.h) and wheel modes (modes.h) for better control.
    - Implemented haptic feedback system (haptics) to enhance user interaction.
    - Developed a custom HID mouse class (hid_scrollmouse) to manage mouse reports and interactions.
    Dividido todo el codigo en sus funciones básicas para que sea mas sencillo mantenerlo y mejorarlo
    - Refactored main loop (main.ino) to integrate new components and maintain responsiveness.
    - Added wheel output handling (wheel_output) to process d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
2025-09-21 por fin funciona ble con botones. Falta añadir soporte para pulsar teclas de mouse y teclado
2025-09-21 intento de q el volumen funcione
2025-09-21 ya funciona el volumen
2025-09-21 cambiado nombres de archivos de los stacks de bluetooth y usb HID
2025-09-21 añadida funcionalidad de teclado
2025-09-21 Unificado codigo usb y ble: usar backend_select.h para cargar codigo en dispositivo ble o usb
2025-09-22 añadidos binarios de usb
2025-09-22 Refactor USB HID mouse backend and main functionality
    - Cleaned up the hid_backend_usb.cpp file by reorganizing includes and improving code readability.
    - Consolidated mouse report descriptor and USB setup logic for better maintainability.
    - Introduced a test function in main.ino for visual and haptic feedback during startup.
    - Refactored setLedsForMode function in modes.cpp for improved clarity and consistency.
    - Enhanced changeMode function to include a reset functionality for factory settings.
    - Improved overall code structure and formatting for better readability and maintainability.
    [buttons.cpp, config.h, events.h, haptics.h, hid_adapter.h, hid_backend_ble.cpp, hid_backend_usb.cpp]
2025-10-27 añadido segundo reporte hid para feoture report. compila btw
2025-10-28 Refactor HID backend USB communication and add Python test script
    - Updated hid_backend_usb.cpp to modify the handling of GET_REPORT and SET_FEATURE requests, ensuring proper report ID management and data integrity.
    - Improved error handling for incoming and outgoing USB data.
    - Added a new Python script (test_hid_config.py) for testing HID feature configuration, including encoding and decoding of configuration data, device selection, and command sending.
    - Enhanced comments for clarity and maintainability.
    [hid_backend_usb.cpp]
2026-03-03 añadido pinout.h y encoder.pio
2026-03-03 añadido soporte para oleds y shift register
2026-03-04 inversion de color al pulsar tecla correcto
    [hardware_oled.h, main.cpp]
2026-03-05 arreglado offset en pantallas oled
    [hardware_oled.h]
2026-03-10 feat: Implement initial ORBY_V4 firmware with TinyUSB composite HID/CDC, dual-core OLED control, and encoder/key handling.
2026-03-10 feat: Add project dependencies for the OrbyGUI project. La app se abre ne electron y la raspi recibe y responde al comando de cambio de app
2026-03-11 added pcb 3d model
    [ORBY.step]
2026-03-11 creada ui de windows app
2026-03-11 feat: implement initial Electron GUI for Orby device management, including profiles, macros, and serial communication.
2026-05-25 Added 3d model for Orby_V3 pcb
    [ORVY_V4_KEYBOARD.step]
2026-07-27 Añadidos archivos 3D
    [Base.3mf, MiniTapa.3mf, Outter_rodamiento.3mf, Rejilla.3mf, Tapa.3mf, tapaEncoder.3mf]
2026-07-27 feat: scroll de alta resolución, mandos configurables y editor OLED
    Firmware 2.0:
    - HID High-Resolution Scrolling: descriptor de ratón con Resolution
    Multiplier y rueda de 16 bits. El scroll iba a saltos de 3 líneas
    porque el descriptor no lo declaraba y el acumulador descartaba el
    resto en cada informe.
    - AS5600 a 1 kHz con filtro sobre la posición y banda muerta; salida a
    250 Hz y endpoint HID a 1 ms.
    - Sensibilidad de la rueda configurable (6-240 clics por vuelta).
    - Perfiles editables en RAM con persistencia versionada y migración
    entre formatos, para no perder los iconos ya guardados.
    - Acciones configurables en los dos encoders y la rueda: multimedia,
    atajos, desplazam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
2026-08-01 feat(orby): macros ejecutadas por el PC y calibración de rueda en ajustes
    El firmware no puede mover el ratón ni pulsar teclas del sistema, así que las
    secuencias se reparten: el teclado solo anuncia y la app ejecuta.
    - Firmware: modificador reservado KEYACT_MACRO (0xFB). Al pulsar una tecla o
    girar el mando con ese modificador se emite "MACRO:<id>" por CDC en vez de un
    informe HID. Se reutiliza el campo del modificador en KeyAction y RotaryAction
    para no añadir un tipo nuevo.
    - electron/macros.js: ejecuta la secuencia en el PC con nut.js (centrar ratón,
    clic, retardo, tecla). main.js intercepta las líneas MACRO: del puerto serie y
    las sigue reenviando al renderer para que l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
2026-08-01 feat: implement macro functionality for keyboard sequences
    - Reduced scroll detents minimum from 6 to 3 for finer control.
    - Removed brightness menu due to OLED limitations; set brightness to a fixed value.
    - Added macro execution capabilities directly on the keyboard, allowing for non-blocking sequence playback.
    - Introduced structures for macro steps and storage, enabling up to 64 macros with 24 steps each.
    - Implemented functions to save and load macros from flash memory.
    - Updated command processing to handle macro creation, truncation, clearing, and retrieval.
    - Enhanced the main loop to process macro playback without blocking other keyboard functions.
    - Removed unused brightness adjust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
    [hid_out.h, main.cpp]
2026-08-03 feat: abrir apps/archivos desde teclas, más pasos de macro y selección en editor OLED
    - Nueva pestaña "App" en el inspector de tecla (junto a Atajo/Secuencia/
    Multimedia/Páginas): asigna una tecla a abrir directamente una aplicación
    o un archivo elegido con el selector nativo, sin pasar por el editor de
    secuencia. Reutiliza el mecanismo de macro existente (MACRO_MODIFIER)
    limitado a un único paso "open_app"; se ejecuta en el PC vía shell.openPath
    (no hay opcode de firmware para esto, ni falta le hace).
    - Nuevo paso "Abrir…" dentro del editor de Secuencia, mismo mecanismo.
    - Los pasos de tecla/clic de una secuencia ahora soportan repetición con
    hueco configurable (repeat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
2026-08-03 feat: elegir apps instaladas o la app en foco al abrir algo desde una tecla
    - Pestaña "App" del inspector de tecla: además de examinar a mano, ahora
    se puede buscar entre las apps instaladas (datalist con lo que resuelve
    electron/apps.js recorriendo los accesos directos del menú Inicio) o
    pulsar "App en foco" para usar directamente la ventana activa en ese
    momento (foreground.js ya manda la ruta del ejecutable, no solo el
    nombre del proceso).
    - El paso "Abrir" del editor de Secuencia gana los mismos controles
    (tipo Aplicación/Archivo, App en foco, buscador, Examinar), en vez del
    simple campo de texto + examinar que tenía antes.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
2026-08-04 feat: grabador de macros, espejo de pantalla OLED y backup ampliado (v3.0.0)
    - Nuevo grabador de macros nativo (electron/recorder.js) con captura de
    teclado/raton via uiohook-napi.
    - Nuevo modulo de espejo (src/mirror.js) para volcar region de pantalla al OLED.
    - Editor OLED reescrito con seleccion y cache de frames.
    - Backup ampliado y mas pasos de macro en el editor de perfiles.
    - Firmware (main.cpp) ajustado para los nuevos comandos.
    - Version 3.0.0 y worktrees de Claude Code fuera del repo.
2026-08-04 feat: aviso de actualización en la barra y tarjeta de la app en Ajustes
    La actualización se descargaba pero no llegaba a instalarse: la X esconde la
    ventana en vez de cerrar la app, así que `autoInstallOnAppQuit` esperaba un
    cierre real que con la app en bandeja puede no llegar nunca.
    - El proceso principal publica el estado del actualizador al renderer
    (updater:state) y expone check/install por IPC.
    - Aviso pulsable en la barra de título, junto al estado de conexión y el
    guardado: muestra el progreso de descarga y, al terminar, instala.
    - Nueva comprobación periódica cada 6 h, no solo al arrancar.
    - Ajustes: el título pasa de "Ajustes de hardware" a "Ajustes" y se añade la
    t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
2026-08-04 perf: scroll fluido con la rueda de alta resolución (v3.1.1)
    Quita el `backdrop-filter: blur(12px)` de `.glass-panel` y de `.toast`.
    Un backdrop-filter dentro de un contenedor con scroll descalifica el scroll
    compuesto en Chromium: cada fotograma hay que releer el fondo y rehacer el
    desenfoque en el hilo principal en lugar de mover una capa ya rasterizada.
    Como `.view` es el scroller y todas las vistas van llenas de `.glass-panel`,
    el scroll de alta resolución —que mueve la página en cada fotograma, no una
    vez por detent— se veía a tirones. En modo detent no se notaba porque el
    salto era grande y espaciado.
    El desenfoque además no pintaba nada: detrás solo hay el color plano
    --bg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
2026-08-04 perf: fondo opaco en los contenedores con scroll (v3.1.2)
    Segunda mitad del arreglo de v3.1.1. Quitar el backdrop-filter dejó suave el
    inspector de teclas (panel derecho), pero el panel izquierdo del editor y la
    vista de Ajustes seguían dando tirones.
    La diferencia estaba en el fondo del propio scroller. `.editor-inspector` es
    además `.glass-panel`, así que su capa de contenido era opaca; `.editor-main`
    es un contenedor pelado con los paneles dentro, y `.view` tampoco tenía fondo
    propio. Chromium solo mete la capa de contenido de un scroller en la ruta
    rápida cuando es opaca: si no, cada tesela hay que limpiarla y mezclarla al
    rasterizar y el texto pierde el suavizado subpíxel. Giran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
2026-08-04 build: publicar los releases directamente, sin pasar por borrador
    electron-builder crea el release de GitHub como borrador por defecto, y
    electron-updater no ve los borradores: cada `npm run release` dejaba la
    actualización invisible hasta sacarla a mano desde la web.
    Con `releaseType: release` el publicado es inmediato. Ojo: ya no hay red de
    seguridad, en cuanto termina de subir los clientes instalados empiezan a
    bajársela.
2026-08-04 feat: el título de cada vista pasa a la barra lateral desplegable (v3.2.0)
    La barra lateral se despliega al pasar el ratón y enseña el nombre de cada
    pestaña; al salir vuelve a quedarse solo con los iconos. Se superpone al
    contenido en lugar de empujarlo: `.sidebar` reserva los 64 px plegados y quien
    crece es `.sidebar-rail`, posicionado encima. Así el ratón entrando y saliendo
    no provoca un recálculo de la vista entera.
    Con el nombre ya en la barra, ninguna vista necesita cabecera propia: se
    quitan los `.view-header` de Dashboard, Perfiles, Ajustes, Consola y Cambio
    automático. Son unos 80 px de alto que recupera el contenido en todas ellas.
    Detalles:
    - El icono va en un `<span>`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
2026-08-04 feat: ventana maximizada al abrir; la barra lateral ya no se queda enganchada
    Maximizada al abrir: no se puede pedir al crear la ventana porque maximize()
    también la muestra, y con --hidden tiene que quedarse en la bandeja. Queda
    pendiente en `pendingMaximize` hasta la primera vez que se enseñe, y todas las
    formas de sacarla (ready-to-show, bandeja, aviso de conexión, segunda
    instancia, activate) pasan ahora por revealWindow().
    Es de una sola vez a propósito: si luego se restaura a tamaño ventana y se
    esconde en la bandeja, al volver a sacarla se respeta como estaba. El 1280x820
    sigue siendo el tamaño al que restaura.
    Barra lateral: al pulsar un botón el foco se quedaba en él y `:f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
2026-08-04 fix: los iconos de una página se guardaban bajo la clave de otra (v3.2.2)
    Leer los 20 huecos de un perfil son 20 idas y vueltas por el CDC, y da tiempo
    de sobra a cambiar de pestaña por el medio. GET_OLED no lleva número de página:
    actúa sobre la que el teclado tenga puesta. Así que al cambiar de página con la
    lectura a medias, los huecos que faltaban se leían ya de la página nueva pero
    se guardaban con la clave de la vieja. Como `cache.has` los daba por leídos,
    nadie volvía a pedirlos y esa página se quedaba para siempre enseñando los
    iconos de la otra, aunque el teclado los pintara bien.
    loadProfile comprueba ahora, antes y después de cada lectura, que el perfil y
    su página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
2026-08-04 bupm version pachage.json de orbyguy
2026-08-04 feat: Implement page management and synchronization with the keyboard
    - Added `ensureEditTarget` function to align the app's editing page with the keyboard's active page.
    - Introduced `withPinnedPage` to manage temporary page changes during editing.
    - Updated `applyDeviceContext` to handle profile and page changes from the keyboard.
    - Enhanced variant management to include page context, ensuring variations are applied correctly based on the active page.
    - Modified the dashboard and OLED views to reflect the current page and profile state.
    - Removed obsolete TODO file and migrated tasks to a structured TODO.md for better tracking.
    - Implemented context reporting in the firmware to notify the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
    [main.cpp]
2026-08-04 feat: implement configuration hash for synchronization between app and firmware
    - Added CRC32 hashing mechanism to track configuration changes in the firmware.
    - Introduced `config_hash.h` for defining the hashing logic and structure serialization.
    - Updated `main.cpp` to compute and return configuration hashes via the `GET_HASH` command.
    - Enhanced `profiles.js` and `settings.js` to require device connection for certain actions, ensuring data consistency.
    - Created testing tools to validate hash consistency between the app and firmware.
    - Updated TODO.md to reflect progress on data persistence and synchronization features.
2026-08-04 Añadida biblioteca de iconos
2026-08-07 feat(OrbyGUI): escribir texto desde una tecla, y hacerlo instantáneo
    Nueva pestaña "Texto" en el inspector de tecla y nuevo paso "Escribir
    texto" en el editor de secuencias: una tecla escribe un correo, una firma
    o un trozo de código tal cual. Va por el camino unicode del sistema y no
    por usages HID, así que sale igual con cualquier distribución de teclado;
    eso mismo es lo que obliga a reproducirlo desde el PC y no desde el
    firmware.
    Escribirlo letra a letra tiene un techo que ningún ajuste arregla —cada
    carácter es un evento de teclado que la app destino tiene que procesar—,
    así que a partir de cinco caracteres el texto entra de golpe por el
    portapapeles y un Ctrl+V, restaurand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
2026-08-08 refactor(OrbyGUI): partir la vista de perfiles en módulos
    profiles.js iba por 3467 líneas y mezclaba el editor de perfiles con la
    grabadora, el editor de secuencias y el almacén de macros: tocar cualquiera
    de ellos obligaba a navegar el fichero entero.
    Se reparte en src/views/profiles/ —constants, view-state, macros-store,
    keys, recorder, macro-tabs, sequence-editor y util— y la vista se queda en
    1652 líneas como único punto de entrada.
2026-08-08 feat: perfiles y páginas nuevos nacen en blanco, y los iconos ya no se recortan
    Al crear una página o un perfil venían diez etiquetas "T1".."T10" y, en el
    teclado, un marco dibujado alrededor de cada pantalla: un lienzo con rejilla
    en vez de un lienzo. Ahora make_blank_page() no rellena etiquetas y el marco
    solo se dibuja si hay texto que enmarcar, así que las pantallas salen negras.
    Añadir una página tampoco copia ya la anterior. Copiar era además incoherente:
    el firmware duplicaba los atajos pero dejaba custom_oled_mask a cero, o sea que
    se heredaban las acciones sin sus iconos.
    Aparte, en la app los recuadros de pantalla recortaban los iconos. Eran dos
    fallos distintos, los dos p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
2026-08-10 feat(usb): identidad propia del teclado y landing del proyecto
    El aparato se presentaba con el VID/PID de los ejemplos de TinyUSB, el
    número de serie 123456 en todas las unidades y un bcdDevice que decía
    1.0 sin corresponderse con nada. Ahora el serie sale del ID único de la
    flash de la Pico, los strings dicen lo que el aparato es, y la versión
    del firmware vive en include/orby_version.h para que el descriptor USB
    y el handshake no puedan contar cosas distintas.
    El descubrimiento del puerto pasa a exigir que coincida el VID: antes
    bastaba con el PID, así que la app podía abrir el puerto de un aparato
    ajeno que casualmente compartiera ese número.
    Añade también web/index.html (la la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
2026-08-10 feat: actualizar el firmware del teclado desde OrbyGUI
    El firmware y la app se publican por separado, así que en cualquier
    momento hay gente con combinaciones distintas. Hasta ahora la app
    decidía qué comandos podía mandar con comprobaciones de versión sueltas
    repartidas por las vistas, y el usuario no tenía forma de saber si le
    tocaba flashear ni manera de hacerlo sin buscar el .uf2 a mano.
    Firmware:
    - Comando BOOTSEL: el teclado se reinicia en el cargador de la ROM
    cuando la app se lo pide. Antes había que desenchufar el cable con el
    botón pulsado, que en una caja cerrada no siempre se puede.
    - El handshake anuncia MAXMACROS y BOOTSEL=1, y la versión sale de
    orby_version.h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
2026-08-10 docs: publicar el firmware a mano, no por CI
    GitHub Actions no arranca en esta cuenta (bloqueo de facturación: el job
    muere en dos segundos sin ejecutar un solo paso), así que el documento
    describía un proceso que no ocurre. El workflow se queda como
    documentación de los pasos; el procedimiento real es compilar en local y
    crear la release con gh.
    Se anota también lo que se pierde con eso: nadie comprueba ya que la
    etiqueta y ORBY_FW_MINOR digan lo mismo.
2026-08-10 feat(flash): flashear sin pulsar BOOTSEL
    El script se quedaba esperando a que alguien desenchufara el cable con
    el botón hundido, que en una caja cerrada no siempre se puede y en
    cualquier caso es un incordio en cada iteración.
    Ahora busca el puerto CDC del teclado por VID (VID_CAFE, cualquier PID:
    el firmware sube el PID cada vez que cambia un informe HID, así que una
    lista de PIDs se queda corta a la primera) y le manda el mismo comando
    BOOTSEL que usa OrbyGUI.
    Cae al método de siempre cuando el comando no puede salir: firmware
    anterior al 4.2, teclado desenchufado, o OrbyGUI con el puerto cogido.
    El margen de espera se ajusta al camino que haya tocado — veinte
    segundos si el coman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
2026-08-10 fix(sync): no releer el teclado en cada conexión
    Cada vez que se enchufaba el Orby, la app se descargaba los tres perfiles
    enteros y los 94 bitmaps, tardaba, a veces se quedaba a medias y encima
    gastaba una escritura de Flash. Todo eso con la comparación por huellas
    (GET_HASH) ya escrita y funcionando.
    El culpable era el editor de iconos: vaciaba la caché entera al conectar.
    Su manejador es síncrono y el de main.js no —espera a la copia del PC y a
    GET_HASH—, así que el borrado siempre ganaba la carrera. La comparación
    se encontraba la caché a cero, profileHash no podía calcular nada (le
    hacen falta los bitmaps de los huecos ocupados) y daba todos los perfiles
    por cambiados. Ese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
    [serial.js]
2026-08-10 fix(serie): recuperarse de una conexión que se muere sin avisar
    Con la 0.4.1 instalada, el teclado no se detectaba por mucho que se
    enchufara y desenchufara: había que ir a Ajustes y pulsar Reconectar.
    Faltaban dos cosas.
    Una conexión puede morirse sin que el puerto emita 'close' — el equipo
    suspende, el cable hace mal contacto, Windows se queda el descriptor de
    un aparato que ya no está. El puerto seguía "abierto", nadie avisaba, y
    como isConnected era true tampoco se volvía a escanear: la app se
    quedaba pegada a un teclado que no existía. Ahora un vigilante pregunta
    con ACK tras doce segundos de silencio (el teclado no habla si no lo
    tocas, así que callar no significa nada por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
    [serial.js]
2026-08-10 fix(app): la app empaquetada se quedaba a medio montar
    En la app instalada, createWindow() reventaba con "Cannot read properties
    of undefined (reading 'publish')": leía `pkg.build.publish` para saber el
    repositorio del firmware, y electron-builder SE LLEVA el campo `build`
    del package.json al empaquetar. En desarrollo no se reproducía, porque
    ahí el package.json es el de verdad.
    La excepción caía justo después de crear el puerto serie, así que nada de
    lo que venía detrás llegaba a registrarse:
    - serial.on('data'): el renderer no recibía ni una línea del teclado, así
    que GET_HASH y GET_PROFILE se morían de viejos. De ahí el "el teclado
    no ha dado las huellas" sin haber toc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
2026-08-10 chore: ignorar el workspace de subagent-driven-development
    Ledgers y briefs de ejecucion de planes no son artefactos del repo.
2026-08-10 feat(web): punto de entrada único para escritorio y navegador
2026-08-10 feat(web): trocear el flujo del puerto en líneas
2026-08-10 feat(web): valores por defecto y fusión de la configuración local
2026-08-10 feat(web): transporte Web Serial sobre el CDC del teclado
2026-08-10 feat(web): copias de seguridad por descarga y selector de archivo
2026-08-10 fix(web): cierra huecos de robustez en el transporte Web Serial
    Tarea 5 quedó aparcada con 3 hallazgos "Important" del reviewer, todos en el
    código que el propio plan daba literal: reconectar() cerraba el puerto sin
    esperar a que cancel() liberara el lock del lector (InvalidStateError
    silencioso, puerto atascado); el intervalo de reintento no capturaba fallos de
    getPorts() (unhandled rejection cada 3s); y no había exclusión mutua entre el
    reintento automático y una apertura manual, así que abrir() podía solaparse y
    duplicar getWriter().
2026-08-10 feat(web): la app arranca en el navegador con Web Serial
2026-08-10 fix(web): usa --bg-dark en vez de --bg-app inexistente en el gate
2026-08-10 feat(perfiles): marcar las teclas que necesitan la app abierta
2026-08-10 feat(web): esconder en el navegador lo que necesita el PC
2026-08-10 ci: publicar la WebGUI junto a la landing
2026-08-10 docs: la versión de navegador de OrbyGUI
2026-08-10 docs: añadir pcSequences a lo que no funciona en la WebGUI
2026-08-10 fix(web): arranque real cuando main.js llega por import dinamico, y cierra huecos del transporte serie
    El listener de DOMContentLoaded en main.js nunca se disparaba cuando el modulo
    llegaba por import() dinamico (entry.js -> web-main.js -> main.js): para
    cuando ese import se resuelve, el documento ya ha pasado ese evento. La app
    se quedaba con la pantalla de carga fija para siempre, en Electron y en el
    navegador. Ahora arrancarApp() se llama directamente si document.readyState
    ya no es 'loading'.
    De paso, dos huecos en la vida del transporte Web Serial:
    - abrir(): si el apretón de manos (ACK x5) no cuaja, el puerto y el bucle de
    lectura se quedaban vivos; el siguiente intento chocaba con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
2026-08-10 fix(app): girar mando de complemento ya no puede subir los dos sentidos a la vez
    El giro de un complemento (brillo, color...) se guardaba hueco a hueco: si el
    sentido contrario aún no tenía macro asignada, invertir o asignar dejaba el
    signo mal calculado. Ahora se escriben los dos huecos físicos juntos
    (applyRotaryPair) y la interfaz los enseña como un único control "Giro" en
    vez de dos filas separadas.
    Aparte, reorganiza TODO.md: lo hecho pasa a docs/DONE.md, entra el plan de la
    WebGUI y el rediseño Apple-like.
2026-08-10 chore(OrbyGUI): bump versión a 0.4.4
    La 0.4.3 ya tenía release publicada en GitHub; electron-builder no
    sobreescribe una release de más de 2h, así que hace falta versión nueva
    para publicar el fix del giro de mando.
2026-08-10 Cambios de lampara
2026-08-10 feat(fw): tachar en las pantallas las teclas que necesitan la app
    El teclado no sabe ejecutar las acciones que dependen del PC (abrir una
    aplicación, un complemento, una secuencia que no le cabe): las manda por CDC
    para que las toque OrbyGUI. Con la app cerrada esas teclas no hacían nada y la
    única pista era esa. Ahora su pantalla sale tachada con una barra diagonal.
    La presencia de la app no se deduce del puerto abierto: la WebGUI también lo
    abre y allí esas teclas no funcionan nunca. La app de escritorio se anuncia con
    HOST_APP:1 en cada presentación y el aviso caduca a los 25 s.
    Firmware 4.5, bandera HOSTAPP=1 en el handshake.
    fix(app): las releases de firmware pasan a prerelease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
    [main.cpp, orby_version.h, serial.js]
2026-08-11 feat(tauri): la lógica que no depende de la plataforma, con sus pruebas
    Primer paso de la migración a Tauri: el crate orby-core, sin Tauri y sin nada
    de Windows a propósito. Es lo que permite comprobar con `cargo test` en
    cualquier máquina la lógica que da miedo perder al dejar Electron, en vez de
    descubrir los fallos ya sobre el teclado.
    Lleva las cuatro piezas que rompen la app en silencio si se portan mal:
    - El partido de líneas del CDC. Equivocarse aquí no da un error, da peticiones
    que caducan a los 4 s sin ninguna pista.
    - La fusión de la configuración local, con `deviceMirror` sustituido entero:
    fusionándolo, un icono borrado seguiría en el archivo para siempre.
    - La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
    [config.rs, fw.rs, lib.rs, lines.rs, protocolo.rs]
2026-08-11 docs(tauri): plan de implementación ejecutable paso a paso
    Mismo formato que PLAN_WEBGUI.md, que ya se ejecutó con éxito: trece tareas en
    orden, cada una autosuficiente, con los ficheros que toca, el test que se
    escribe primero, el comando de verificación con su salida esperada y su commit.
    Está escrito para que lo pueda ejecutar un modelo pequeño sin gastar contexto
    explorando: las tablas de cabecera traen ya extraídos los 39 canales, los 10
    eventos, la superficie completa de window.orby y las constantes del protocolo,
    con la instrucción explícita de no salir a buscarlas.
    Cada tarea separa lo que se comprueba con `cargo test` de lo que exige el
    teclado delante, porque la mitad de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
2026-08-11 feat(tauri): la tercera vía de arranque del frontend
    entry.js pasa a elegir entre tres: Tauri, Electron y navegador. Tauri se
    comprueba el primero a propósito —si algún día montara su propio window.orby,
    la rama de Electron se lo tragaría y arrancaría por la vía equivocada sin decir
    nada— y platform.js gana isTauri().
    src/tauri/orby-tauri.js monta la superficie window.orby completa sobre invoke()
    y listen(). Los nombres de los eventos se conservan con dos puntos porque son
    los que ya conoce el renderer; los de los comandos van en snake_case porque
    Rust no admite ':' en un identificador, y esa diferencia queda encerrada ahí.
    La API se coge del global que inyecta Tauri (withGloba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
2026-08-11 feat(tauri): motor de complementos declarativos
    Los complementos se reescriben de cero: dejan de ser programas de Node que
    corren dentro del proceso principal y sin caja de arena, y pasan a ser un
    manifiesto que ejecuta Rust. Esto entra en orby-core, que es lo que se puede
    comprobar sin Windows y sin teclado.
    Tres piezas, 38 pruebas:
    - manifiesto.rs valida el plugin.json y construye el descriptor. Un complemento
    de la API 1 se rechaza al cargar con un mensaje que dice qué versión trae y
    qué hacer, en vez de reventar a mitad de una pulsación.
    - plantilla.rs sustituye {{settings.x}}, {{value}} y {{response.x}}. Una
    plantilla desconocida FALLA en vez de interpolar vacío: un hueco e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
2026-08-11 feat(tauri): máquina de estados de la conexión con el teclado
    Handshake, vigilante y recuperación por telemetría, en orby-core y separado del
    puerto de verdad. El tiempo entra por parámetro en vez de leerse del reloj, que
    es lo único que hacía falta para poder probar en microsegundos lo que sobre un
    teclado costaría minutos y paciencia.
    Son 16 pruebas sobre los fallos que de verdad duelen: que no se rinda antes de
    tiempo y descarte el puerto bueno, que no anuncie desconexión de un puerto que
    nunca conectó, que reenvíe TODA la telemetría porque device.js depende de ello,
    que renueve HOST_APP en cada saludo porque el teclado lo caduca a los 25 s, y
    que una conexión en reposo agua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
2026-08-11 feat(tauri): peticiones de complemento y presupuesto de las OLED
    peticion.rs monta la URL de una acción sin mandarla, que es lo que permite
    comprobar sin red la parte fácil de equivocar: la interpolación, la codificación
    de la cadena de consulta y de dónde sale el tiempo máximo. Cubre las siete
    acciones de lampdesk de punta a punta. Las acciones no reintentan nunca —un
    incremento repetido se aplicaría dos veces— y solo la comprobación de ajustes
    lo hace, porque leer es inofensivo.
    oled.rs es el arbitraje de lo que los complementos pintan en las pantallas.
    Pintar no desgasta la Flash (OLED_CHUNK escribe en RAM; solo SAVE_STATE
    persiste), pero el ancho de banda sí es un límite d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
2026-08-11 feat(tauri): qué versión de firmware se le puede ofrecer al usuario
    Separado de la descarga para poder comprobar sin red la parte que decide, que
    es donde están los fallos con consecuencias: ofrecer un firmware que la app no
    sabe manejar, o no ofrecer ninguno por filtrar de más.
    La prueba que más importa es la de las prerelease. Las releases de firmware se
    publican así a propósito, para que releases/latest siga apuntando a una release
    de la app; filtrarlas «porque son prerelease» dejaría al usuario sin ninguna
    actualización de firmware. Ya pasó lo contrario una vez (fw-v4.4 publicada como
    definitiva rompió el actualizador de todo el parque instalado), así que ambos
    lados del f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
2026-08-11 fix: páginas pasando solas y tachado que iba y venía
    Dos averías distintas que se veían juntas.
    fix(fw): antirrebote de las teclas por integración (firmware 4.6)
    El filtro era por bloqueo: aceptaba cualquier muestreo distinto con que
    hubieran pasado 5 ms del último flanco aceptado. Eso filtra el rebote de un
    contacto sano, pero fabrica una pulsación entera a partir de dos picos de
    ruido —uno da la tecla por pulsada y otro 5 ms después por soltada—.
    En la tecla de menú, cuya pulsación corta cambia de página, cada pareja de
    picos era un cambio de página. Y el cambio de página repinta las diez OLED,
    que es justo la fuente de ruido: se realimentaba y el teclado se quedaba
    pas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
    [main.cpp, orby_version.h, serial.js]
2026-08-11 feat(tauri): crate de la app y ventana
    La cáscara que faltaba: paquete orby-app, tauri.conf.json y src/main.rs. El
    espacio de trabajo pasa a declararse aquí y orby-core deja de tener el suyo,
    así que el lock del crate interno sobra y se va.
    Dos cosas que el plan no contaba y sin las que la ventana es inútil:
    - capabilities/default.json. Tauri 2 deniega por defecto hasta sus propios
    comandos: sin este fichero las ocho suscripciones de device.init() se
    rechazan con "event.listen not allowed" y la app se queda sorda al backend
    sin romper el pintado, que es la peor forma de fallar.
    - Los tres comandos de ventana, adelantados de la Tarea 5. Con
    decorations: false el marco lo dibuja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
2026-08-11 fix(test): el verificador del plan corría en una ruta que solo existía en Linux
    Tenía escrita a pelo /home/user/...: fuera del contenedor donde se escribió
    fallaba en la primera línea. Pasa a situarse relativo al propio script, y de
    paso comprueba que existan los permisos de Tauri, que es el fallo que acaba
    de costar una sesión entera de diagnóstico.
    Y dos trampas nuevas en CLAUDE.md: npm install está roto de raíz por
    archiver@5.3.2 (pide async@^0.0.1, que no existe), y assets/orby-icon.png es
    en realidad un JPEG con la extensión cambiada.
2026-08-11 feat(tauri): descubrimiento, handshake y vigilancia del puerto serie
    La cáscara que conecta la máquina de estados de orby-core a un puerto de
    verdad. Un solo hilo posee el puerto: los comandos del renderer encolan y el
    hilo drena, así no hay dos escritores sobre el mismo handle. El plazo de la
    lectura es el pulso del hilo, que duerme dentro del `read` en vez de girar en
    vacío.
    De paso, un fallo de la máquina que solo salía al haber un puerto de verdad
    detrás: al dar el vigilante una conexión por muerta emitía `Desconectado` pero
    no `SoltarPuerto`, y como el rastreo no abre nada mientras haya un puerto
    cogido, la app se quedaba enseñando «buscando» sin buscar.
    Comprobado sobre e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
2026-08-11 feat(tauri): configuración local y copias de seguridad
    Sin config_get, las acciones que no son teclas —abrir una app, un complemento,
    energía, una secuencia— se pintaban todas como secuencias vacías: el teclado
    solo guarda un puntero a macro y lo que significa vive en el PC.
    La ruta no sale de app_config_dir(): ese resuelve a %APPDATA%\com.orby.gui por
    el identificador reverse-DNS, y la configuración tiene que ser el mismo fichero
    que usa Electron o el usuario abre la app nueva sin nada.
    Dos diferencias con electron/config.js, las dos a mejor: escritura por fichero
    temporal y rename, porque el original es lo único que hay; y un cerrojo
    alrededor de leer-fusionar-escribir, que en E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
    [backup.rs, config.rs, main.rs]
2026-08-11 feat(tauri): ventana, bandeja, diálogos y apps
    Cerrar esconde a la bandeja, como en Electron: la app tiene que seguir viva
    para ejecutar las secuencias que le pide el teclado. Se intercepta también en
    on_window_event porque Alt+F4 no pasa por el comando.
    Las apps instaladas salen de IShellLink por COM, no de un PowerShell hijo. No
    se llama a Resolve: con un destino que ya no existe se pone a buscarlo por
    disco y por red y la lista pasa de un segundo a minutos. El orden se le
    pregunta a Windows con CompareStringEx en es-ES.
    La posición del ratón sale de GetCursorPos, en píxeles físicos del escritorio
    virtual, que es el mismo espacio de SendInput con coordenadas absolutas. La
    Tarea 7 t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
    [apps.rs, dialog.rs, main.rs, mouse.rs, window.rs]
2026-08-11 feat(tauri): ejecución de secuencias en el PC
    SendInput directo, sin nut-js. La traducción de usage HID a tecla virtual va
    en orby-core con sus pruebas: un error ahí no se manifiesta como fallo sino
    como una tecla que escribe otra cosa. Lo que más vale de esas pruebas es la
    bandera de tecla extendida, porque sin ella la flecha arriba escribe un 8 con
    Bloq Num puesto, y el Intro del numérico es indistinguible del normal.
    Las letras salen por KEYEVENTF_UNICODE en vez de por tecla virtual, así que se
    escriben igual sea cual sea la distribución del teclado.
    Añadido que Electron no tenía: un cerrojo alrededor del portapapeles. Dos
    secuencias pueden solaparse, pero el portapapeles es un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
    [lib.rs, macros.rs, main.rs, serial.rs, teclas.rs]
2026-08-11 docs(tauri): comprobadas a mano las tareas 5 y 6 sobre el teclado
    Secuencias, abrir programas, elegir ficheros y la lista de apps instaladas se
    comportan igual que en Electron. Quedan sin comprobar la recuperación desde la
    bandeja y el caso del monitor con escalado al 150 %.
2026-08-11 feat(tauri): grabadora de ratón y teclado
    Los ganchos WH_KEYBOARD_LL y WH_MOUSE_LL van en un hilo propio con su bombeo
    de mensajes: sin él se instalan sin error y no llega ni un evento.
    Lo que hay guardado en `c` no es una tecla virtual de Windows, es el código de
    uiohook: Electron capturaba con uiohook-napi y reproducía con nut-js, y en el
    disco quedó el número del primero. Por eso orby-core/uiohook.rs hace de puente
    en los dos sentidos, contra (vkCode, LLKHF_EXTENDED), que es la pareja que
    distingue el Inicio del 7 del numérico.
    Las teclas y botones hundidos los suelta un Drop, así que se sueltan también si
    se corta el bucle a mitad o si el hilo muere por pánico. Comprobado sob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
    [grabacion.rs, lib.rs, macros.rs, main.rs, recorder.rs, serial.rs, uiohook.rs]
2026-08-11 feat(tools): panel Orby Manager
    Panel local en tools/orby-manager que reúne lo que se hacía a mano y repartido:
    versiones (firmware, vía Electron, vía Tauri, app instalada y teclado), lanzar
    OrbyGUI en sus cinco modos, flashear el teclado, compilar y empaquetar, git con
    commit y push, y publicar releases de firmware y de app con progreso en vivo.
    Se publica a mano porque Actions está bloqueado por facturación y gh no está
    instalado: el panel no rodea eso, solo evita teclear diez comandos y olvidarse
    de uno de los ficheros de versión.
    Decisiones que conviene no deshacer sin motivo:
    - Cada vía de la app lleva su versión por separado. La de Electron es la que
    produce instalador y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
2026-08-11 fix(tools): el log del flasheo sale con los acentos bien
    PowerShell escribe en la página de códigos de la consola (cp850) y el panel lee
    la salida como UTF-8, así que los mensajes de flash.ps1 llegaban al registro
    como «Proyecto compilado con Ǹxito». Se invoca con -Command para poder fijar
    antes [Console]::OutputEncoding a UTF-8.
2026-08-11 fix(tools): el panel tolera ramas sin la vía Tauri y arregla el log del flasheo
    Trae al panel lo ajustado al clonarlo a main: si en la rama no existe
    src-tauri, la tarjeta lo dice y el bump de esa vía queda deshabilitado, en vez
    de pintar un error rojo por un port que ahí todavía no está. Y la salida de
    flash.ps1 se lee en UTF-8, que llegaba al registro con los acentos rotos.
2026-08-11 feat(tauri): ventana en primer plano sin PowerShell
    Sustituye el PowerShell permanente de electron/foreground.js por un hilo que
    llama a Win32 directamente: GetForegroundWindow, GetWindowThreadProcessId,
    GetWindowTextW y QueryFullProcessImageNameW. Desaparece el proceso hijo, y con
    él la única forma que había de dejar un powershell.exe suelto si la app moría
    mal.
    Conserva el contrato de Electron: sondeo cada 400 ms, emisión solo cuando cambia
    la ventana o el título, y {process, title, path} con `process` sin extensión,
    que es lo que daba Get-Process.ProcessName y con lo que casan las reglas que el
    usuario ya tiene guardadas.
    El vigilante arranca al abrir la app solo si config.autoPr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
2026-08-11 fix(tauri): repite HOST_APP:1 cada 8s para que no caduque en el teclado
    El aviso caducaba en el teclado a los 25s con la app abierta y sana:
    el vigilante (12s de silencio) nunca dispara con telemetria continua
    (KEY_EV, WHEEL, ENC), asi que el ACK que antes lo renovaba de gorra no
    llegaba a tiempo. Repetidor propio con su reloj (RENUEVO_HOSTAPP_MS).
    [serie.rs]
2026-08-11 feat(tauri): actualización del firmware
    Descarga del .uf2 con progreso, entrada en BOOTSEL (por comando y a
    mano), búsqueda de la unidad RPI-RP2 por INFO_UF2.TXT y copia
    tolerando los errores de la Pico reiniciándose a mitad. TLS con
    rustls (puro Rust) para no depender de un compilador de C del
    sistema. Falta la comprobación sobre el teclado real.
    [firmware.rs, main.rs]
2026-08-11 feat(tauri): complementos declarativos
    Motor de complementos http: ejecuta las peticiones que ya montaba
    orby-core (manifiesto, plantillas, coalesce), con reintentos y
    timeout de verdad contra un servidor de mentira en los tests.
    Engancha el agrupado de giros a un hilo real (disparaba antes en el
    vacío) y resuelve el paso «plugin» de las secuencias, pendiente
    desde la Tarea 6. Instalación desde .zip con el crate zip (deflate
    puro Rust, sin C).
    Lampdesk pasa a la API 2 y pierde su main.js: dejará de cargar en la
    app de Electron a partir de aquí, excepción deliberada a que
    Electron siga funcionando hasta la Tarea 13 (es solo el complemento
    de ejemplo). Falta la comprobación con la lá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
2026-08-11 docs(tauri): aplazar la Tarea 11 hasta desarrollar el primer complemento de proceso
    Construir el esqueleto sin ningún complemento real que lo use es
    diseñar el protocolo a ciegas. Se retoma cuando toque el primero de
    la lista del TODO.
2026-08-11 perf(tauri): soltar el WebView2 al irse a la bandeja
    Esconder la ventana con hide() dejaba el WebView2 cargado y pintando de fondo:
    unos 80 MB en reposo, más de lo que gastaba la app entera con Electron, y sin
    nadie mirándolo. Ahora se destruye, y al volver a abrir se reconstruye desde el
    mismo WindowConfig de tauri.conf.json para no duplicar aquí título, tamaño ni
    color de fondo.
    Lo que sigue vivo en la bandeja (puerto serie, macros, firmware, complementos)
    cuelga de main.rs::setup y no toca la ventana, así que no hace falta conservarla.
    Hace falta interceptar RunEvent::ExitRequested: destruir la única ventana se
    toma si no como «se cerró la última» y tao apaga el proceso enter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
2026-08-11 fix(tauri): dejar de tirar la conexión cuando el teclado tarda en tragar
    El plazo del puerto son 20 ms, que es el pulso del hilo, y serialport lo usa
    para leer *y* para escribir: no se pueden separar por su API. El firmware se
    queda unos 120 ms sin atender el USB cada vez que escribe en Flash (borrar y
    programar 8 KB, write_oled_slice en main.cpp), y con 20 ms Windows devuelve ahí
    ERROR_SEM_TIMEOUT (121). Se estaba tomando por un teclado desenchufado: la app
    soltaba el puerto, reconectaba y se volvía a descargar los perfiles enteros.
    Pasaba al subir iconos mientras se navegaba por las páginas del teclado.
    Ahora el plazo se alarga solo mientras se escribe y se vuelve a dejar corto
    antes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
    [log.rs, main.rs, serial.rs]
2026-08-11 docs(tauri): comprobadas sobre el teclado las tareas 3, 4, 5, 7, 9 y 10
    Sesión de comprobación de paridad contra Electron con la build de release y el
    teclado real (COM7). Lo que queda escrito, tarea por tarea:
    - Tarea 3: desenchufar emite `disconnected` y `searching` en el mismo instante,
    reconecta solo, y el mando manda `ENC:1:±1` y `ENC:2:±1`.
    - Tarea 4: la prueba de oro pasa entera. Las copias de las dos vías miden lo
    mismo y dicen lo mismo; la de Electron se restaura en Tauri y al reexportarla
    vuelve idéntica.
    - Tarea 5: el ciclo de la bandeja completo, y el puerto serie sobrevive a que se
    destruya y se reconstruya el WebView2.
    - Tareas 5 y 6: con el monitor principal al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
2026-08-11 docs(tauri): la Tarea 12 es lo único que queda, y falla en silencio
    Al repasar qué faltaba salió que `orby-tauri.js` declara los espacios `autostart` y
    `updater` pero Rust no registra ninguno de sus cinco comandos: `autostart_get`,
    `autostart_set`, `updater_get`, `updater_check` y `updater_install` responden
    `Command ... not found`. Rust registra 34 de los 39 del contrato.
    Lo grave no es que falten, es que no se nota. Como los nombres están declarados,
    `platform.can()` da true y `ocultarSiFalta` no esconde las tarjetas: Ajustes enseña
    el interruptor de «Arrancar con Windows» y la tarjeta de actualización como si
    funcionaran. El interruptor queda muerto porque `initAutostart` revient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
2026-08-11 docs(tauri): sin parque instalado, la Tarea 12 se queda en autoarranque
    El plan daba por hecho un parque de usuarios con electron-updater al que no se
    podía dejar tirado, y de ahí salían el puente (una última versión de Electron
    cuya actualización instalase la de Tauri) y la comprobación de que una se
    instalase encima de la otra. No hay tal parque: el único usuario es el autor, que
    ya tiene la de Tauri instalada a mano y la de Electron desinstalada.
    Se descartan el puente y la convivencia de las dos apps. La instalación es a mano
    con el .exe de `npm run tauri:build`, que ya sale bien (7,5 MB), así que el paso 3
    queda cerrado.
    Queda por hacer el autoarranque (los tres comandos y e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
2026-08-11 feat(tauri): autoarranque y avisador de versiones, y v1.0.0-alpha
    Cierra la Tarea 12, que era lo único que le quedaba a la migración. Rust
    registraba 34 de los 39 comandos del contrato; los cinco que faltaban eran
    justo los de esta tarea, y no fallaban de forma visible: orby-tauri.js los
    declaraba igual, así que platform.can() decía que sí y las tarjetas de Ajustes
    se pintaban muertas.
    Autoarranque (autostart.rs): clave Run del usuario escrita a mano con el crate
    `windows`, sin plugin, porque la trampa está en cómo se LEE. Lo que decide si
    está activado es la ruta resuelta con canonicalize, no los argumentos: una
    entrada sin --hidden arranca la app igual, así que contestar «desact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
2026-08-27 release(app): OrbyGUI 1.0.1 — ventana maximizada y compat firmware 4.6
    La ventana vuelve a abrirse maximizada (window.rs::mostrar), como en Electron:
    el port a Tauri se había quedado con el 1280x820 de tauri.conf.json.
    Corrige el aviso "Firmware 4.6: más nuevo que esta app" que salía al conectar
    el teclado. El firmware 4.6 y su soporte en compat.js ya estaban, pero el
    bundle empaquetado en la 1.0.0-alpha se compiló con FW_RECOMMENDED=4.5. Al
    reconstruir el instalador el dist queda al día.
    [window.rs]
2026-08-27 feat(app): la app vuelve a actualizarse sola, ahora con firma
    Desde el paso a Tauri, el actualizador solo avisaba y abría la página de la
    release en el navegador: descargar e instalar exigía firmar las actualizaciones,
    y eso se dejó pendiente. Ya está hecho, así que updater.rs pasa a usar
    tauri-plugin-updater de verdad: comprueba al arrancar y cada seis horas,
    descarga en segundo plano e instala sola (NSIS en modo passive, sin un clic).
    La instalación cierra el proceso, y el guardado automático a Flash es un
    temporizador de 1500 ms en el renderer: morirse dentro de esa ventana pierde una
    escritura que nadie repite. Por eso la descarga va siempre pero la instalación
    espera a que no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
2026-08-27 chore(app): OrbyGUI 1.0.3
    Solo el número de versión. La actualización automática que estrenó la 1.0.2 no se
    puede comprobar sin una versión posterior a la que actualizarse: la firma solo se
    valida al instalar una actualización de verdad, no al publicarla.
2026-08-27 docs: el CLAUDE.md describía la app como si siguiera siendo Electron
    La migración a Tauri se cerró en la v1.0.0-alpha y el documento se quedó atrás:
    mandaba a `OrbyGUI/electron/` como proceso principal, a `npm run dev` y
    `npm run dist` como los comandos de la app, y decía que el IPC va por
    `ipcMain.handle`. Nada de eso es lo que se compila ni lo que se publica.
    Lo que cambia:
    - La tabla del backend pasa a `src-tauri/src/*.rs`, y se nombra `orby-core`, que
    no estaba: es donde vive la lógica que se puede probar sin teclado ni red, y
    donde toca añadir la nueva.
    - "No hay tests automatizados" era falso desde hace tiempo. Son 132 en
    `cargo test -p orby-core` más tres ficheros en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
2026-09-03 fix(webgui): permitir invertir el giro en Volumen/Brillo/Zoom (#8)
    Las parejas multimedia con arriba/abajo (Volumen, Brillo, Zoom) del giro de
    un encoder no tenían botón de "Invertir giro": a diferencia del giro de un
    complemento, el sentido quedaba fijo (horario = subir) sin forma de darle la
    vuelta si el encoder está montado al revés. Se generaliza el mecanismo que ya
    existía para complementos (invertirGiroPlugin -> invertirGiroPar) para que
    también sirva con estas parejas multimedia.
    Claude-Session: https://claude.ai/code/session_01Hqmwz7v3URwDU3DwZPUf3Q
2026-10-23 fix(app): el instalador no incluía WebView2Loader.dll
    Con el toolchain GNU de Rust, webview2-com-sys enlaza el cargador de
    WebView2 de forma dinámica (con MSVC va estático dentro del .exe). La DLL
    aparecía en target/release junto al binario, así que en la máquina de
    compilación todo funcionaba, pero el NSIS no la empaquetaba: en cualquier
    otro equipo orby-app.exe no llegaba a arrancar.
    Se guarda la DLL x64 en src-tauri/vendor/ (sale de webview2-com-sys 0.38.2)
    en vez de apuntar a target/, porque tauri-build valida los recursos antes
    de que exista la de target/ en una compilación limpia.
    OrbyGUI 1.0.4.
2026-10-23 docs: README con la web del proyecto, la WebGUI y lo esencial del repo
    Claude-Session: https://claude.ai/code/session_017iooeRcCHmCrsnzNAUW1Zg
2026-10-26 feat(firmware): pantallas rediseñadas y transiciones al estilo del iPhone
    Los iconos de fábrica no correspondían a sus teclas (en Cortar salía
    deshacer, del 5 al 10 había letras sueltas) y el resto era la fuente 5x7
    dentro de un recuadro. Todo lo que se ve en las pantallas sale ahora de
    tools/oled_ui/:
    - Fuente propia dibujada píxel a píxel, proporcional, con minúsculas,
    tildes y ñ, en dos tamaños.
    - Iconos de 24x22 con trazo de 2 px para las 80 teclas de los perfiles de
    fábrica y para todos los menús, con su nombre en castellano debajo.
    - El icono se elige por la etiqueta de la tecla (include/oled_ui.h), así
    que sigue a la acción si se mueve de sitio.
    - Selección de me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
2026-10-26 chore: no versionar la caché de Python de tools/oled_ui
    Claude-Session: https://claude.ai/code/session_017gwKX9T6yHXXc6tzZy1P2c
2026-10-27 feat: biblioteca de perfiles para 12 programas, con sus iconos
    Perfiles listos para instalar desde Perfiles → Biblioteca, con una página
    por tarea y más órdenes en la capa SUPER:
    - Ingeniería: Altium (esquemático / PCB / vista y salida), KiCad
    (esquemático / PCB), Fusion 360 (boceto / sólidos) y LTspice.
    - Programación: VS Code (edición / paneles / depuración), Windows
    (ventanas / multimedia) y navegador (pestañas / YouTube).
    - Office en español: Excel, Word y PowerPoint.
    - Creativos: Photoshop (herramientas / capas / ajustes) y Premiere Pro
    (montaje / herramientas).
    Los perfiles se escriben en tools/perfiles/biblioteca.py y se generan a
    OrbyGUI/src/profile-library.json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
2026-10-27 feat: el teclado guarda lo que hace cada macro del PC (firmware 4.7)
    Una tecla de macro solo guardaba su id; lo que hacía la macro (abrir una
    app, escribir un texto, una grabación, su nombre) vivía únicamente en la
    configuración del PC. Enchufado en otro ordenador, nadie sabía qué era la
    «macro 7» y la tecla se quedaba muerta.
    Firmware: almacén opaco en la Flash (include/macro_store.h, comandos
    MSTORE_INFO/GET/BEGIN/DATA/END, bandera MSTORE=1). Dos bancos de 224 KB:
    se escribe el libre y solo pasa a ser el vigente cuando su CRC cuadra y
    se graba la cabecera, así que un corte de corriente a medias no se lleva
    la copia anterior. El teclado no interpreta ni ejecuta nada: las macros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
2026-10-27 Prepara la publicación de OrbyGUI 1.0.5 y el firmware 4.7
    Sube la app a 1.0.5, añade las notas de ambas versiones y
    tools/publicar.ps1, que compila el firmware y la app firmada, compone
    latest.json y crea las dos releases (firmware como prerelease) desde el
    PC que tiene la clave de firma.
    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
2026-10-27 feat(app): rediseño al estilo de macOS/iOS
    La app de escritorio y la WebGUI comparten renderer, así que el cambio vale
    para las dos.
    - Paleta de colores de sistema de Apple en oscuro (indigo, verde, naranja,
    rojo) en tokens de :root, con tripletas RGB para los tintes: antes el
    violeta iba escrito a mano en treinta sitios.
    - Controles de iOS: segmentados con pastilla gris, interruptor verde con
    bola que se estira, deslizador con tramo recorrido de color, botones
    planos que se encogen con muelle al pulsar.
    - Listas agrupadas en el panel de estado, avisos como notificaciones,
    barra lateral translúcida al desplegarse y vistas que entran con la
    curva de UIKit.
    - Réplica del tecla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
2026-10-27 feat(app): modo claro
    Sigue al modo del sistema y cambia con él en caliente; en Ajustes →
    Apariencia se puede fijar Claro u Oscuro. La preferencia va en
    localStorage porque hay que leerla antes del primer pintado.
    El modo claro son los mismos tokens con los valores claros de Apple (fondo
    #f2f2f7, tarjetas blancas, colores de sistema para fondo claro). Lo que
    quedaba escrito a mano para el oscuro (marco de la ventana, superficies
    flotantes, consola, réplica del teclado) pasa a tokens; la réplica sale en
    plata. Las pantallas OLED y su editor siguen en negro: son la imagen del
    panel real.
    Claude-Session: https://claude.ai/code/sessi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
2026-10-27 feat(app): la réplica del teclado copia el Orby real
    El dashboard dibujaba un teclado genérico (3x4 a un lado, mandos y rueda
    apilados al otro). Ahora usa la geometría del prototipo que usa también el
    modelo de la web, orvy.es: carcasa de 210 x 125 mm, teclas de 19,6 a 23 mm
    de paso, rueda de 76 mm a la derecha y los dos mandos en el borde de
    arriba. Todo se mide en milímetros de carcasa con unidades de contenedor,
    así que escala entero con el panel.
    Materiales del modelo: carcasa blanca impresa en 3D, teclas negras con
    cap transparente, OLED con su brillo azulado, rueda y mandos moleteados y
    un hoyuelo en la rueda que hace de marcador. No siguen al tema claro u
    oscuro: es el objeto f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
2026-10-27 fix(app): posiciones de la réplica medidas sobre el teclado real
    Las coordenadas del modelo de la web no coincidían con el Orby montado.
    Medidas sobre una foto cenital, normalizadas a la carcasa de 210 x 125 mm:
    - Teclas a 24,4 mm de paso (no 23), con el bloque centrado en (-60, 0,6).
    - Rueda de 75 mm en (42,5, 5): 9 mm más a la izquierda y algo adelantada.
    - Mandos de 15,5 mm en (-2, -34,5) y (84, -34,5).
    Y lo que no se parecía: la rueda y los mandos son lisos con textura de
    impresión, sin moleteado; el marcador es un tapón con ranura tangencial,
    como el de la rueda real; los mandos no llevan raya; y la caja tiene las
    esquinas casi vivas.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
2026-10-27 chore(app): lo de esta rama sale como OrbyGUI 1.0.6
    La 1.0.5 ya está publicada desde main con solo el cambio de número, sin
    nada de esta rama. Con el mismo número el actualizador no vería la versión
    nueva como nueva, y publicar.ps1 reutilizaría la release que ya existe en
    vez de subir la buena.
    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
2026-10-27 feat(app): OrbyGUI pasa a llamarse Orvy, en par con la landing
    Renombra el nombre visible de la app en Windows (productName, título de
    ventana, bandeja, diálogos de actualización) a Orvy. Se deja igual todo
    lo interno (identifier, carpeta de %APPDATA%, paquetes npm/Cargo) para
    no romper rutas de usuarios ya instalados.
    De paso, arregla la réplica del teclado en el Dashboard: el anillo de la
    ranura de la rueda y los encoders se pintaba encima por la sombra de
    elevación de la pieza y se veía incompleto; ahora la sombra va en la
    ranura y el anillo queda cerrado. El punto que marca la posición de la
    rueda pierde la ranura de tornillo decorativa: la pieza real se fabrica
    lisa.
    Co-Authore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
2026-10-27 feat(fw): velocidad configurable de las animaciones de las pantallas (4.8)
    Las transiciones estilo SpringBoard de oled_anim.h llevan ahora un
    multiplicador por grupo (menu, carrusel de paginas, submenu, cambio de
    perfil, fundido): escala el tiempo que recibe cada muelle/fundido sin
    tocar sus constantes, que es matematicamente el mismo muelle con mas
    omega y el mismo zeta.
    La libreria sigue neutra (100% en los cinco grupos) para que
    test_anim.cpp siga comprobando los muelles de Apple sin recortar;
    quien fija el ritmo de fabrica es main.cpp: menu y fundido se quedan
    igual (ya iban bien), carrusel y submenu suben a 160% y el cambio de
    perfil a 140%.
    Protocolo nuevo SET_ANIMSPEED/GET_ANIMSPEED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
2026-10-27 chore(app): Orvy 1.0.8, con el slider de velocidad de animaciones
    Acompaña al firmware 4.8 (velocidad configurable de las transiciones):
    sube la versión de la app en los tres sitios y corrige la referencia en
    COMPATIBILIDAD.md, que decía 1.0.7 por error — esa versión ya se publicó
    sin este slider.
2026-10-27 feat(fw): el carrusel de páginas usa el hueco real entre pantallas (4.9)
    Los 72 px del panel miden unos 10 mm y entre pantallas hay 9,75 mm: el
    hueco pasa de 24 px comprimidos a 70 px, para que un icono cruce de una
    tecla a la vecina a la misma velocidad que se mueve el resto.
    Sale con Orvy 1.0.9, que sube FW_RECOMMENDED a 4.9: la 1.0.8 tiene el
    tope en 4.8 y no ofrecería esta versión como actualización.
2026-10-27 feat: velocidades con base nueva, carpeta con más zoom y SUPER animada (4.10, Orvy 1.0.10)
    Firmware 4.10:
    - La velocidad de las animaciones cuenta sobre un ritmo de fábrica propio
    de cada grupo (ANIM_BASE_PCT): los valores elegidos con los sliders de
    la 4.8/4.9 pasan a ser el 100%. Bandera ANIMSPEED=2; los ajustes 4.8/4.9
    se migran arrancando en 100. SET_ANIMSPEED admite 25-250: la 4.8
    aceptaba hasta 400 y lo guardaba en un byte dando la vuelta.
    - Abrir/cerrar menú con más zoom (fondo al 160%, contenido desde el 40%).
    Lo que entra empieza a crecer cuando empieza a verse, así que se le ve
    crecer; cerrar es el mismo movimiento con las escalas al revés.
    - La capa SUPER se abre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
2026-10-27 feat(fw): lo nuevo del menú espera a que se vaya lo viejo y nace de un punto
    Lo que entra al abrir o cerrar menú (y SUPER) aparece a los 0,2 s, cuando
    lo que sale ya casi no se ve: solapados, en 1 bit los dos dibujos se
    mezclaban en una trama. El contenido del menú nace al 3 % (dos píxeles)
    y al cerrar se encoge hasta ahí.
2026-10-27 feat(fw): sin Volver en el menú de perfiles de mantener menú (4.11, Orvy 1.0.11)
    Abierto manteniendo la tecla de menú, soltarla ya cancela: la pantalla
    de Volver solo ocupaba una tecla. Desde el menú principal sigue, porque
    es la única forma de volver a él.
    Sale con Orvy 1.0.11, que sube FW_RECOMMENDED a 4.11 para ofrecerlo.
2026-10-27 feat: interfaz nueva y pantallas en directo en el Inicio (4.12, Orvy 1.1.0)
    Firmware 4.12: MIRROR:1 enciende el espejo de las pantallas. En cada
    transición el teclado manda los diez destinos (EV:SCR) y el tipo y ritmo
    de la animación (EV:SCR:GO), más EV:INV y EV:DISP. Core 1 los publica con
    un contador de secuencia y Core 0 los manda por el CDC.
    La app los anima con oled-anim.mjs, copia en JS de oled_anim.h. Un test
    la compara con el C++ mediante un fichero dorado (tools/test/anim_golden.cpp):
    6560 fotogramas, cero píxeles distintos.
    Interfaz rehecha con la identidad de la landing (negro, cian de los OLED)
    y la estructura de macOS: barra lateral de Ajustes del Sistema, título
    grande,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
2026-10-27 test(app): el fichero dorado de las animaciones admite CRLF
2026-10-27 feat(app): el firmware del teclado se actualiza solo cuando no se usa
    Cuando hay firmware nuevo, la app lo instala sin preguntar en cuanto el
    PC lleva 10 minutos sin entrada (GetLastInputInfo: el teclado de macros
    es un HID más, así que sus teclas y la rueda también cuentan). Espera si
    hay cambios sin guardar en Flash, no lo intenta con firmwares sin BOOTSEL
    por serie y no reintenta sola una versión que ya falló en la sesión.
    Con la app abierta en la bandeja vuelve a mirar GitHub cada 6 horas.
    Las reglas van en src/fw-auto.mjs, sin window, con sus tests. Se puede
    apagar desde Ajustes → Firmware del teclado (clave autoFirmware).
    window.orby.firmware.idleMs en las tres vías.
    Co-Auth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
2026-10-27 chore(app): Orvy 1.1.1, con la actualización automática del firmware
2026-10-27 feat: SUPER+menú retrocede o abre ajustes, y pantallas del Inicio sin recortes (4.13)
    Firmware 4.13. Con SUPER sujeta, la pulsación corta de la tecla de menú
    retrocede de página y la larga abre el menú principal, que se queda
    abierto al soltar. Mientras se mantiene menú para elegir perfil, el
    bucle bloqueante sigue llamando a mirror_pump: la app no se enteraba de
    que el menú se había abierto y el Inicio no animaba el cambio.
    App: las pantallas del Inicio se pintan a la resolución real del
    monitor, con cada píxel del OLED ajustado a la rejilla y nunca más
    estrecho que uno. El canvas de 72x40 escalado con pixelated perdía
    columnas enteras cuando la réplica medía menos de 72 px.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
2026-10-27 chore(app): Orvy 1.1.2, que reconoce el firmware 4.13
2026-10-27 docs: notas de release del firmware 4.13 y OrbyGUI 1.1.2
2026-10-27 commit de limpieza, paso de leer todo lo q lleva sinceramente
2026-10-28 feat(app): Inicio limpio con barra superior y sin barra lateral (fase 1)
    El Inicio pasa a ser solo la réplica del teclado. Debajo de cada zona va
    su botón de configurar, alineado con ella: "Configurar teclas" bajo las
    teclas y "Rueda y mandos" bajo la rueda. Pulsar una pieza de la réplica
    lleva a configurarla ya elegida. De momento abren el editor de Perfiles;
    el zoom con el panel lateral llega en la fase 2.
    Fuera la barra lateral y los widgets (capa SUPER, rueda, último evento).
    Arriba queda una sola barra:
    - izquierda: el estado del teclado en una cápsula. "Solo lectura" va ahí
    y deja de ser un cartel flotante; firmware y espejo, en el globo.
    - centro: los perfiles como pestañas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
2026-10-28 feat(app): configurar es ampliar la réplica, con el panel a la derecha (fase 2)
    Pulsar "Configurar teclas", "Rueda y mandos" o cualquier pieza de la
    réplica ya no lleva a la vista de Perfiles. La réplica se acerca a esa
    zona, que se queda a la izquierda, y por la derecha entra un panel con
    el editor. Es el encuadre por zonas de la versión móvil de orvy.es: la
    curva es la de su suavizado exponencial (arranca rápido y se posa sin
    rebote), y tocar una pieza de la otra zona cambia de encuadre.
    - La pieza que se edita lleva un anillo cian en la réplica. Lo que no es
    de la zona se apaga, pero se puede pulsar.
    - Las flechas mueven la tecla elegida por la rejilla de 3 x 4. Esc o
    "Listo"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
2026-10-28 fix(app): pulsar fuera del aparato deshace el zoom; la pestaña activa pasa de página
    - Con una zona ampliada, un clic en el fondo del escenario vuelve al
    Inicio, como tocar fuera de una hoja de iOS. La carcasa cuenta como
    aparato, para que un clic que se queda corto al apuntar a una tecla no
    lo deshaga.
    - Pulsar la pestaña del perfil que ya está puesto pasa a su página
    siguiente, y de la última vuelve a la primera. Es lo mismo que la
    pulsación corta del botón de menú, y es más fácil de acertar que los
    puntos.
    Claude-Session: https://claude.ai/code/session_014WZVxgR2zYvi46JPeKk7xf
2026-10-28 feat(app): panel de teclas en dos niveles, como Ajustes de iOS (fase 3)
    El panel del Inicio deja de ser el inspector de pestañas de la vista de
    Perfiles. Ahora tiene dos niveles:
    - La tecla: su pantalla en grande (a escala 2, con el brillo del OLED),
    lo que hace ahora y si la ejecuta el PC. Debajo, copiar, pegar y
    borrar, y los tipos de acción en baldosas: Atajo, Multimedia y PC,
    Abrir app, Escribir texto, Secuencia, Grabar e Ir a página. La del
    tipo actual se enciende y dice qué hace. Por último, "Cómo se ve",
    que lleva al editor del icono.
    - El tipo de acción: su editor, que entra empujado desde la derecha,
    con "‹ Tecla N" para volver. Esc vuelve a la tecla, y desde l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
2026-10-28 feat(app): panel de la rueda y los mandos con el mismo esqueleto (fase 4)
    La zona de la rueda deja de enseñar la tarjeta y el inspector de la
    vista de Perfiles uno debajo del otro. Ahora sigue los dos niveles del
    panel de teclas:
    - La pieza (Mando izq. / Rueda / Mando der., arriba o tocándola en la
    réplica): su dibujo, y sus gestos en una lista agrupada de iOS, cada
    uno con lo que hace. Un giro que se edita como uno solo (desplazar,
    zoom, pareja multimedia, complemento) sale como "Girar"; si no, uno
    por sentido ("Girar a la derecha/izquierda", "hacia abajo/arriba").
    Los mandos añaden "Pulsar".
    - La rueda trae además su sensibilidad: la cifra grande, el deslizador,
    los cuatr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
2026-10-28 feat(app): editando la capa SUPER, las pantallas de la réplica la enseñan
    Hasta ahora, elegir SUPER en el panel cambiaba lo que se editaba pero no
    lo que se veía. Con el espejo del firmware, la réplica enseña lo que
    tiene puesto el teclado, que es la capa normal mientras nadie mantenga
    SUPER. Así se editaba a ciegas.
    Ahora, mientras el panel está en SUPER, las pantallas enseñan esa capa
    hasta que se acaba de editar (vuelta a NORMAL, o fuera del zoom):
    - oled-mirror.js gana una vista previa (preview / endPreview) que manda
    sobre el espejo. Entra con la misma transición que el teclado al
    pulsar SUPER. Lo que siga llegando del teclado se guarda, y al acabar
    se vuelve a ello con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
2026-10-28 fix(app): la vista previa de SUPER entra y sale en 0,15 s
    Usaba el ritmo de los menús del teclado: 0,54 s multiplicados por la
    velocidad de animaciones que haya puesta en Ajustes. Con un ritmo lento,
    cada cambio NORMAL/SUPER en el panel se hacía esperar. La vista previa
    es para editar, no para usar el teclado, así que va a un ritmo fijo de
    0,15 s, con espejo y sin él.
    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
2026-10-28 feat(app): la vista de Perfiles pasa a ser solo de gestión (fase 5)
    Las teclas, la rueda y los mandos se editan ya solo en el Inicio, sobre
    la réplica. La vista de "Perfiles y macros", con su rejilla e inspector,
    se queda en "Perfiles" con la forma de Ajustes de macOS:
    - A la izquierda, la lista de perfiles con su icono real, cuál está en
    uso y cuántas páginas tiene. Abajo, Nuevo, Biblioteca y la cuenta.
    - A la derecha, la ficha del elegido:
    - Cabecera con el icono en grande y el nombre, que se edita ahí mismo.
    - "Usar en el teclado" si no es el activo.
    - "Configurar teclas, rueda y mandos", que lo pone en el teclado si
    hace falta y lleva al Inicio con el zoom abierto.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
2026-10-28 feat(app): Perfiles se cierra como una hoja y las páginas se alcanzan desde el panel
    - Volver a pulsar el botón de Perfiles (o el de Ajustes) en la barra
    vuelve al Inicio: son conmutadores, como los de una barra de
    herramientas de macOS.
    - En Perfiles, pulsar fuera de la lista y de la ficha (el fondo de la
    vista) vuelve también al Inicio, como tocar fuera de una hoja.
    - El panel del Inicio gana un botón "Páginas" junto a "Listo". Lleva a
    la ficha del perfil en uso, directamente a su sección de páginas, que
    se resalta un instante. Antes había que saber que se gestionaban allí.
    - "Añadir página" ya no desaparece al llegar al tope: se queda apagada y
    dice cuál es el máx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
2026-10-28 fix(app): la app dibuja las pantallas como el teclado, con el icono del catálogo
    Los perfiles de la biblioteca (Altium, KiCad…) no suben ni un icono: el
    firmware busca cada etiqueta en su catálogo y dibuja el icono con su
    nombre debajo. La app solo sabía pintar iconos subidos. Donde no había
    espejo del teclado salía la etiqueta en texto (WIDTH, RTMODE…) en vez de
    "Ancho" o "Modo rutado" con su dibujo: en la capa SUPER mientras se
    edita, con un firmware sin MIRROR, con la copia del PC y en la pantalla
    grande del panel.
    - tools/oled_ui/build.py genera también oled-ui-data.mjs (fuente,
    dibujos y catálogo) y los casos de referencia de test_ui.cpp como
    fixture. La salida del firmw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
2026-10-28 feat(biblioteca): VS Code comenta y descomenta en la misma tecla
    En la página Edición del perfil de VS Code, la tecla 6 (fila del medio,
    junto a Subir y Bajar línea) es ahora la de los comentarios: Comentar
    (Ctrl+K, Ctrl+C) en la capa normal y Descomentar (Ctrl+K, Ctrl+U) en
    SUPER. Así un mismo botón hace las dos cosas.
    - Duplicar línea, que estaba en esa tecla, pasa a la 11 de SUPER, donde
    estaba Comentar.
    - Volver sale de Edición: sigue en la página Depuración, al lado de
    Adelante.
    - Icono nuevo «uncomment» y entrada UNCOMM → Descomentar en el
    catálogo: el bocadillo de Comentar con la insignia de quitar, como
    Borrar línea. Regenerados oled_ui_data.h, oled-ui-data.mj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
2026-10-28 refactor(app): fuera el CSS y el código que dejó el editor antiguo
    Con la edición en el panel del Inicio y Perfiles como vista de gestión,
    quedaban 72 clases sin uso en index.css: la rejilla okey-*, editor-*,
    las pestañas de perfil, la barra de variaciones, las tarjetas de mandos
    y rueda, las pestañas del inspector… Son unas 150 reglas y 320 líneas.
    Se han quitado con un script que lee la estructura del CSS y solo borra
    un selector cuando nombra una clase que ya no aparece en ningún JS ni
    en el HTML. Después, repaso a mano de los comentarios que hablaban de
    lo quitado.
    El inspector de mandos pierde su modo "con caja", que solo usaba la
    vista antigua: el panel lo pinta siempre sin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
2026-10-28 feat(app): ventana estrecha, y la réplica enseña la variación que se edita
    - Por debajo de 900 px (la WebGUI; la app de escritorio no baja de
    1024) el panel sube desde abajo como una hoja de iOS, y el zoom
    encuadra la zona en el hueco de arriba. Por debajo de 760, en
    Perfiles la lista va encima de la ficha. La barra superior se
    compacta, y la tira de perfiles se desplaza si ni compactada cabe.
    - Editando una variación en el panel, la réplica pasa a vista previa
    con lo que ella cambia, igual que con la capa SUPER. El cartel dice
    qué variación es, y las teclas que redefine llevan un punto naranja.
    Al volver al perfil base, la réplica sale con un fundido (no con la
    trans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
2026-10-28 docs(app): el README describe la interfaz nueva
    La sección "2. Las vistas" decía que había un Dashboard con widgets y
    una vista de "Perfiles y macros" con la rejilla y el inspector. Ahora
    describe la barra superior, el Inicio (configurar es ampliar, el panel
    en dos niveles, la vista previa de SUPER y de las variaciones) y
    Perfiles como gestión. También se han corregido las referencias sueltas:
    el cartel de solo lectura, dónde están la calibración y la nota de alta
    resolución de la rueda, y que Cambio automático y Consola se abren
    desde Ajustes → Herramientas.
    El TODO del rediseño lleva una nota de lo que ya está hecho por otro
    camino.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
2026-10-29 chore(app): Orvy 1.1.3, que reconoce el firmware 4.14
    Claude-Session: https://claude.ai/code/session_014WZVxjL4voJ9v9zUsS7ojX
2026-10-29 fix(fw): caben 255 secuencias en el teclado, no 64 (4.14)
    La app no libera el id de una macro que ya no usa ninguna tecla, así que
    con el uso los ids pasan de 63 (una configuración real va por el 160). Una
    secuencia rehecha a partir de ahí estrenaba un id que el teclado no podía
    guardar y, aunque solo llevara teclas, clics y esperas, se quedaba tachada
    y muda sin la app.
    MACRO_MAX_COUNT sube a 255, el tope que permite el keycode de un byte. La
    app lee MAXMACROS del handshake, así que sube sola las que faltaban.
    Las secuencias se mudan a 896-1024 KB (no cabían entre los ajustes y el
    almacén de macros). Las de la 4.13 se leen de su sitio viejo hasta el
    primer guardado. Se guarda secto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
2026-10-30 feat(app): retirar al conectar las macros que no usa ninguna tecla
    Cambiar una tecla de pestaña, pegarla o instalar un perfil de la
    biblioteca estrena una macro, y la de antes se quedaba para siempre: los
    ids solo crecían (una configuración real iba por el 160) y acabarían
    pasando del 255 que cabe en el keycode de una tecla.
    Al conectar, con los perfiles leídos enteros, las variaciones cargadas y
    el almacén del teclado ya juntado, se retiran las que no usa ninguna
    tecla, mando o variación de ninguna página ni capa, y se vacía su copia
    en el teclado. Lo retirado va a `macrosRetiradas` en la configuración del
    PC y vuelve solo si una tecla lo vuelve a pedir (rescueRetiredMacros, que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
2026-10-30 feat(app): secuencias compactas y reordenar pasos y teclas arrastrando
    - Secuencias: la espera entre pasos ya no ocupa una fila propia; va dentro de
    cada paso (reloj con sus ms) y se mueve con él. Cada paso es una sola fila.
    - Asa de tres rayas en cada paso para arrastrarlo donde haga falta (sustituye
    a los botones de subir/bajar).
    - Punto de inserción: pasando el ratón entre dos pasos aparece un + que hace
    que los pasos nuevos se añadan ahí; un aviso dice dónde y deja volver al final.
    - Teclas: mantener pulsada una tecla de la réplica la levanta; al arrastrarla
    las demás tiemblan y se apartan para hacer hueco, como en el iPhone. Se
    mueve acción, etiqueta e icono de la cap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
2026-10-30 feat(app): secuencias compactas y reordenar pasos y teclas arrastrando
    cada paso (reloj con sus ms) y se mueve con él. Cada paso es una sola fila;
    en el panel estrecho, Texto y Abrir bajan su campo a una segunda línea.
    a los botones de subir/bajar), con autoscroll en listas largas.
    - Teclas: con "Configurar teclas" abierto, mantener pulsada una tecla de la
    réplica la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
2026-10-30 fix(app): las tapas no se meten bajo el hueco al reordenar; pull sin estorbos
    - Réplica: cada tecla se centraba con `translate`, que la convertía en su
    propia capa de pintado. Al reordenar, la tapa que se deslizaba a la celda de
    al lado quedaba debajo del hueco gris de esa tecla. Ahora se centran con
    márgenes (misma posición, comprobada) y todos los huecos quedan por debajo
    de todas las tapas. La atenuación de MENÚ y SUPER pasa a su tapa por lo
    mismo.
    - .gitattributes con text=auto: en Windows, los CRLF que meten al reescribir
    ficheros la CLI de Tauri, npm o el editor ya no cuentan como cambios.
    - package-lock.json seguía en 1.0.0-alpha y cada `npm install` lo reescribía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
2026-10-30 feat: los mandos llevan páginas y menús, y la tecla de menú puede quedar libre (4.15)
    Firmware 4.15 (bandera MENUKEY):
    - Dos tipos de acción de mando nuevos. ROT_PAGE: el giro pasa de página
    (horario avanza, antihorario vuelve; una acción cubre los dos sentidos, como
    los desplazamientos). ROT_MENU: el clic abre un menú (perfiles, gestor de
    páginas o menú principal). Abierto así, BACK vuelve al uso normal.
    - SET_MENUKEY:<0|1> deja la tecla 10 como la de menú o como una tecla normal
    con su acción de la página. Es global y no del perfil: un perfil sin mando
    de menú dejaría al usuario sin salida. Se guarda en el byte de relleno de
    los ajustes (siempre a cero hasta ahor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
2026-10-30 feat(app): deshacer en el panel de teclas y mandos (botón y Ctrl+Z)
    Cada toque del editor se escribe al momento en el teclado, así que ir mirando
    qué ofrece un mando ya lo cambiaba. Ahora se apunta lo que había en cada hueco
    justo antes de tocarlo (profiles/undo.js) y el botón de la cabecera del panel,
    o Ctrl+Z, lo vuelve a escribir, paso a paso y hasta 50 pasos.
    - Un paso es un gesto: «Borrar» (acción, etiqueta e icono), pegar o soltar
    una tecla arrastrada se deshacen de una vez; una etiqueta escrita letra a
    letra, también. Pulsar lo que ya estaba puesto no cuenta.
    - Funciona con el perfil base y con variaciones, en la página donde se hizo
    el cambio aunque se esté mirando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
2026-10-30 docs: las etiquetas y releases se publican desde el servidor (conector Authorization)
    Claude-Session: https://claude.ai/code/session_014WZVxhQw548Rhb5DK5n7cH
2026-10-30 docs: pasos para publicar una release desde el servidor
    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
2026-10-30 docs: el token de releases está en /etc/orvy/github-release.token
    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
2026-10-30 feat: invertir mandos y rueda, mando de menú y mantener-girar-soltar (fw 4.16)
    Espejo de los cambios de Orvy (aded4b7) para la parte del teclado.
    Claude-Session: https://claude.ai/code/session_014WZVxgfNTq2r1d7CuJwCQ5
2026-10-30 feat: animación al elegir perfil (fw 4.17) y actualización automática del firmware
    Espejo de los cambios de Orvy (c84d61f, 5b3a2ce, dfb2432 y 2f67601) para la
    parte del teclado: la transición PICK (succión y explosión al elegir perfil
    en el menú) con su copia en la app, la actualización del firmware al
    conectar o tras 2 min sin tocar el teclado, y las pruebas pendientes en TODO.md.
    Claude-Session: https://claude.ai/code/session_014WZVxi9ZdbbJxLw5oLNbze
2026-10-30 docs(app): notas de Orvy 1.1.3 con todo lo que trae desde la 1.1.2
2026-10-30 docs: 4.17 flasheada y tests de Windows en verde; Orvy 1.1.3 publicada
2026-10-30 feat: los mandos giran al revés por defecto (fw 4.18) y Orvy 1.1.4
    El sentido que había que marcar con «invertir» en los dos encoders pasa a
    ser el de fábrica (ROTINV_FABRICA). Los bits de SET_ROTINV siguen queriendo
    decir «al revés de lo normal», sobre el sentido nuevo; la rueda y la
    telemetría ENC: no cambian. Sin cambios de protocolo ni de Flash.
    Orvy 1.1.4 solo sube FW_RECOMMENDED a 4.18: la 1.1.3 no ofrece un firmware
    por encima del que conoce.
2026-10-30 docs: la 4.17 probada en el teclado y publicada dentro de la 4.18
2026-10-30 docs: redacción de la entrada de la release 4.18 en el TODO
2026-10-30 feat(app): la tabla de compatibilidad firmware/app se baja de GitHub
    El tope de firmware que la app ofrecía (FW_RECOMMENDED) iba compilado, así
    que cada firmware nuevo obligaba a publicar app nueva. Ahora sale de
    compat.json, que la app descarga de main al arrancar (con copia guardada y
    copia compilada de respaldo; gana la de rev más alto).
    Un firmware que no cambia nada que la app use se publica añadiendo su
    entrada a compat.json. test/compat-tabla.test.mjs falla si el firmware del
    repositorio no tiene entrada o pide una app sin publicar. Solo vale desde
    Orvy 1.1.4.
2026-10-30 feat: un solo dueño del menú, tecla 10 o un mando (fw 4.19)
    Con un mando de menú la tecla 10 queda libre, y volver a la tecla suelta
    el mando. Con dueño, el «Abrir menú» de los perfiles en otros mandos se
    ignora; las páginas valen en cualquiera. La app lo oculta en el editor y
    el panel del mando de menú enlaza a Ajustes.
2026-10-30 feat: el teclado escribe textos él solo sin la app (fw 4.20, Orvy 1.1.5)
    Paso de secuencia MSTEP_TEXT (tres teclas por paso, distribución española)
    y bandera MACROTEXT=1. Con la app viva y una secuencia de solo texto, escribe
    el PC como hasta ahora (más rápido); sin app teclea el teclado.
2026-10-30 fix: las secuencias con texto van al PC con la app viva, y las teclas no pierden pulsaciones (fw 4.21)
2026-10-30 feat(app): editor de iconos rediseñado como una hoja de Apple (Orvy 1.1.6)
    El lienzo pasa a ser un escenario con la pantalla OLED en el centro, las
    herramientas flotan debajo y un inspector con pestañas (Iconos, Texto,
    Imagen) sustituye a las tarjetas apiladas. Al colocar algo, el inspector
    cambia a un panel de ajuste con Cancelar y Fijar al pie.
    - El texto aparece en el lienzo mientras se escribe, sin botón de colocar.
    - Rehacer, atajos de teclado (P/E/G/M, Ctrl+S, Esc, Intro, Ctrl+Z/Y, zoom).
    - Imágenes arrastrándolas al lienzo o pegándolas con Ctrl+V.
    - Biblioteca por secciones, coordenadas del píxel bajo el cursor.
    - Salir con la flecha, Ajustes o Perfiles ya no tira el dibujo si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
2026-10-30 feat: la intro de arranque lleva la marca de Orvy (fw 4.22)
    El dial de la pantalla central da una vuelta, se encienden las otras
    nueve de dentro afuera, giran las diez y la central se queda con el
    logotipo. La genera tools/anim/intro_dial.py desde la geometría de
    OrbyGUI/assets/brand/, en el formato que ya lee oled_intro.h: el
    reproductor no cambia. Sustituye a la intro que escribía «ORBY».
2026-10-30 feat(app): marca nueva de Orvy (Orvy 1.1.7)
    El logotipo es «orvy» dibujado en monolínea, con la o como el dial del
    teclado y un píxel cian encendido. Cambian el icono de la app (y con él
    el de la bandeja y la barra de tareas), la pantalla de arranque, que
    pasa del texto «ORVY» al logotipo, y la marca de la barra superior.
    El icono no cambia con el tema; el logotipo sí: en claro va en tinta
    oscura y el píxel en el cian profundo de la app. Los SVG maestros, las
    piezas para la web y el correo están en OrbyGUI/assets/brand/.
2026-10-31 feat: el zoom de rueda y mandos es un pellizco de touchpad (fw 4.24)
    El zoom ya no mantiene Ctrl pulsado: el teclado anuncia una segunda
    interfaz HID, un touchpad de precisión de Windows, y abre o cierra dos
    dedos simétricos. Windows lo trata como el pellizco de un trackpad.
    - Interfaz aparte (PID 0x4009): si el host no la acepta, teclado, rueda
    y multimedia no se enteran. Sin el modo touchpad (Linux, macOS) el
    zoom cae al Ctrl + rueda de siempre.
    - Los dos dedos van en un solo informe y se informan sin parar mientras
    están apoyados: callarse hacía que Windows los diera por levantados y
    tomara un clic suelto de rueda por un toque (un clic de ratón).
    - Escala logarítmica (cada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
2026-10-31 feat: intros de arranque «orvy» con tres finales, al azar por defecto (fw 4.25, Orvy 1.1.8)
    El dial nace en la tecla 5 y sube a la 2, y la r, la v y la y entran
    elásticas por la derecha, la izquierda y abajo hasta la columna central.
    Después, uno de tres finales: ventilador (el torbellino de la O se traga
    las letras y luego se desintegra), viento (cada píxel se va en su
    remolino) o lija (la O crece arrasando las letras y se gasta). Al acabar,
    los iconos se abren con la transición de SUPER, en vivo.
    - Por defecto sale una al azar cada vez; Ajustes → Intro de arranque deja
    fijar una y verla ya en el teclado (SET_INTRO, PLAY_INTRO, STATE:INTRO,
    bandera INTRO). Se guarda en el relle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
2026-11-01 feat: intros a 120 fps y subida del dial sin salto (fw 4.26)
    La subida del dial a la tecla 2 usaba la curva elástica de las letras,
    que arranca a toda velocidad: en el primer fotograma ya había saltado
    más de lo que mide la pantalla. Ahora sale de parado con un muelle.
    Las tres intros se hornean a 120 fps en vez de 30: los paneles barren a
    unos 170 Hz y el SPI repinta las diez en 3 ms. El guion sigue escrito en
    fotogramas de 30 y se muestrea más fino (track_at interpola las pistas
    del giro y las trayectorias). Ocupan unos 450 KB; el programa queda en
    681 KB, por debajo de los 896 KB donde empiezan las secuencias.
2026-11-01 fix(app): la tabla de compatibilidad reintenta la descarga y espera más a la red
2026-11-01 feat(app): Ajustes con panel de apartados a la izquierda (Orvy 1.1.9)
    Las tarjetas se agrupan en General, Controles, Pantallas y energía,
    Dispositivo y firmware, Complementos, Copias y restablecer y Herramientas.
    Los apartados sin tarjetas visibles no se ofrecen.
2026-11-01 fix(app): el panel de Ajustes con baldosas de color y sin estilo de botón del navegador (Orvy 1.1.10)
2026-11-01 feat: perfiles desactivados en el teclado, Ajustes en un solo desplazamiento (fw 4.27, Orvy 1.1.11)
    Firmware 4.27: máximo 9 perfiles activos y archivo comprimido de perfiles
    desactivados (PSTORE_*); los bancos de macros pasan a 112 KB.
    App: vista de Desactivados en Perfiles y Ajustes como una sola página con
    panel de apartados que salta y sigue el scroll.
2026-11-01 fix(tests): npm test carga los src ESM en Node 20 y sin comodines de shell
    macro-prune y macro-store-sync fallaban siempre: Node 20 no detecta ESM en
    src/device.js sin type=module, y compat.json se importaba sin atributo json.
    scripts/test.mjs lista los test/*.mjs a mano (npm en Windows no expande
    comodines y test-serial.js es un script manual).
2026-11-01 feat: iconos grandes en las teclas, modo ayuda y texto siempre en grande (fw 4.28, Orvy 1.1.12)
    Las teclas del catálogo llevan el icono a x1.5 (36x33) y sin el nombre
    debajo: a 24x22 con el nombre en 7 px no se leía ni lo uno ni lo otro.
    Modo ayuda: cada icono se cambia por su nombre. Se entra y se sale con
    doble toque de SUPER o desde Ayuda en el menú principal (que pasa a 7
    opciones). Cómo se sale (SET_HELP: al pulsar una tecla, 5/10/30 s o solo
    a mano; 10 s de fábrica) va en un byte que era relleno de los ajustes.
    Todo texto de tecla sale lo más grande posible: fuente grande en una o
    dos líneas (por espacio o con guion, y si hace falta con 1 px entre
    letras y sin margen); la pequ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
2026-11-02 feat(app): consejos con vídeo, accesos directos y avisos dentro de la app
    Bombilla en la barra superior que abre la vista Consejos: 19 consejos en
    6 categorías, cada uno con un vídeo corto y un botón que lleva a donde se
    activa o configura eso mismo. De vez en cuando (1 al día, nunca con cambios
    sin guardar) sale un aviso con el aspecto de los toast; interruptor en
    Ajustes → General.
    Los vídeos viven en git (OrbyGUI/tips-video/, con manifiesto de hashes) y
    la app los baja una sola vez a %APPDATA%\OrbyGUI\tips\. La lógica de qué
    falta está en orby-core (consejos.rs). window.orby.tips en las tres vías.
    Sin versión nueva ni release: salen con la próxima. Pendiente anotado en
    Orb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
2026-11-02 docs(todo): corrige la ruta de los vídeos de consejos
2026-11-02 feat: modo juego con cinco juegos, iconos grandes y ayuda en pantalla (fw 4.29, Orvy 1.1.13)
    Sintoniza cambia de mecánica: en vez de pulsar tecla al ver «YA», hay que
    mantener el cursor dentro de la banda hasta vaciar la barra de la tecla 5
    (vaciado simétrico desde el centro); salir de la banda la rellena de golpe.
    Cada emisora es más estrecha que la anterior.
2026-11-03 feat: Misil con objetivos que se mueven y mandos a la vez (fw 4.30, Orvy 1.1.14)
    Misil gana su fase 2: a partir de unos aciertos algunos objetivos se mueven,
    cada vez más a menudo y más deprisa, y valen más en proporción a su velocidad.
    El misil tarda siempre lo mismo en caer; la dificultad la ponen los objetivos.
    En modo juego, mantener los dos mandos 2 s ya no saca del juego: es una entrada
    más. Icono de Misil tumbado para que quepa entero en el menú.
    Los comandos de Tauri que esperan a la red, al disco o a un hilo (firmware,
    complementos, apps instaladas, grabadora) pasan a un hilo de bloqueo: en el
    principal dejaban la ventana en «no responde» con un dispositivo apagado.
    Se re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
2026-11-03 fix(app): suelta el cerrojo antes de emitir en firmware y updater (Orvy 1.1.15)
    `set()` emitía con el cerrojo del estado cogido; un comando síncrono que lo pidiera
    en el hilo principal podía quedarse esperando a un hilo que esperaba al principal.
2026-11-03 chore(ci): quita GitHub Actions, no corre en esta cuenta
    Las releases se publican desde el servidor (ver CLAUDE.md), así que
    firmware.yml sobraba; pages.yml fallaba en cada push y mandaba correos.
2026-11-03 feat(tools): script manual para publicar la WebGUI en gh-pages
    Se lanza solo a petición; Actions no corre en esta cuenta. Docs al día.
2026-11-03 feat(misil): mapa de desierto con terreno, carreteras y VTOL que se detiene en cada zona (Orvy 1.1.16)
    El misil pasa a un mapa con terreno, carreteras, campamentos y vehículos
    que circulan de frente. El territorio grande se dibuja como un mapa con la
    cámara en una zona, con menos objetivos y más separados. El VTOL se queda
    un rato sobre cada zona antes de volar a la siguiente.
    Solo cambia la app: el firmware no se toca.
2026-11-03 feat(misil): el VTOL se queda más y solo se va tras disparar (Orvy 1.1.17)
    Para irse hacen falta a la vez 40 s parado sobre la zona y 8 misiles
    soltados desde que llegó. Se mira al acabar cada explosión, así que nunca
    se mueve con un misil en el aire. Durante el vuelo no se dispara y el
    tiempo parado no avanza. La barra de la pantalla 10 muestra lo que falta.
    publicar-web.sh: pwd -W para que node lea la ruta en Git Bash.
2026-11-03 feat(juegos): panel de estadísticas, carreteras sin callejones y misil sin resurrecciones (Orvy 1.1.18)
    Misil: lo destruido no vuelve; la zona sin objetivos se deja atrás y sin nada en
    el mapa acaba la partida; 6 misiles para que el VTOL vuele; empieza en la base;
    carreteras en circuitos sin callejones sin salida (nada se da la vuelta en seco);
    7 vehículos; los mandos pulsados aceleran el misil mucho más.
    Estadísticas: objetivos destruidos por tipo y máximo con un solo misil, por
    partida y en total. Reflejos: tiempo por nivel y media de la partida; sin medias
    de varias partidas.
    Juegos: la vista ya no replica las pantallas del teclado; lista de juegos y panel
    grande con estadísticas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
2026-11-03 feat(misil): mapa de seis zonas, plan de la campaña y volcado del mapa a PNG
    El territorio crece hacia el este con el oasis, el aeródromo y el cuartel. La red de
    carreteras pasa a ser de sentido único, con un tercer circuito. Hay explanadas para
    aparcar y sendas a pie. Nuevos objetivos quietos: cazas, antiaéreos y soldados con RPG.
    La mecánica (tráfico, VTOL, disparos) llega en los siguientes commits, según
    docs/PLAN_MISIL.md.
2026-11-03 feat(misil): tráfico de sentido único con convoyes, aparición continua y coche patrulla
    Las carreteras pasan a ser de un solo sentido (SALIDAS en lugar de ADYACENTES) y cada
    vehículo decide su siguiente tramo al entrar en el actual. Los vehículos no se pisan
    (espacioDelante), van en convoyes que comparten camino y la velocidad del más lento, y
    entran cerca de la vista en vez de acabarse. Nuevo objetivo: la patrulla, con luces
    que parpadean. Estado y desviaciones en docs/PLAN_MISIL.md.
2026-11-03 feat(misil): grupos de soldados que salen de un edificio y caminan por las sendas (fase 5.1)
2026-11-03 feat(misil): helicóptero en el helipuerto, vaivén del VTOL y ruta lineal con final
    Fases 2 y 3.1 del plan: helicóptero de 13x13 que despega al segundo, vaivén de la cámara
    por zona, ruta de la zona 1 a la 6 con victoria y bono por vida, fuera DISPAROS_PARA_VOLAR,
    vuelo con duración según la distancia y zona en la pantalla 10 durante el vuelo.
2026-11-03 feat(misil): dificultad por zona, antiaéreos, fuego enemigo, lanzamisiles y RPG (fase 4)
    NIVELES sustituye al tráfico provisional. El enemigo dispara al VTOL parado con aviso:
    una amenaza a la vez (dos en la zona 6) y 3 s entre impactos. Un camión se sale de la
    carretera, aparca y despliega el lanzador.
2026-11-03 feat(misil): bajar de un vehículo y subir a otro (fases 5.2 y 5.3)
2026-11-03 chore(release): Orvy 1.1.19
    Subida de versión en los tres ficheros (package.json, tauri.conf.json,
    Cargo.toml) y Cargo.lock para la release con Misil ampliado.
2026-11-03 docs(misil): plan de mejoras de Air Strike (nombre, derrota, explosiones, cráteres, aviso, misil enemigo y pantalla 9)
2026-11-05 feat: Blackjack y mandos que desplazan hacia donde se giran (fw 4.31, Orvy 1.1.20)
    Juego nuevo, Blackjack: diez manos contra la banca empezando con 100 fichas.
    Fila de arriba la banca, la del medio el jugador y abajo pedir, plantarse y
    doblar; la apuesta con la rueda o las teclas 7 y 9. Seis barajas, la banca se
    planta en 17 y el blackjack paga 3:2. Icono de naipes (#BLACKJ).
    Con un encoder en desplazamiento horizontal, girar en sentido horario lleva a
    la derecha. La inversión de fábrica del paneo estaba en WheelOut::add_pan y
    arrastraba a los encoders; ahora solo la aplica la rueda magnética en
    wheel_accumulate, que sigue igual.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
2026-11-05 feat(fw): Air Strike en el menú (tools y datos regenerados)
    La etiqueta de #MISIL pasa a «Air Strike» (43 px, cabe en una línea de 72).
    Regenerados oled_ui_data.h y oled-ui-data.mjs con build.py.
2026-11-05 feat(misil): el juego pasa a llamarse Air Strike (el id sigue siendo misil)
2026-11-05 feat(fw): reinit de pantallas y L1 de volcado (4.31)
    Fase 6 de PLAN_AIRSTRIKE, lo que se puede hacer sin medir:
    - paint_screen manda 0x20 0x00 (modo horizontal) antes de 0x21/0x22.
    - reinit_screen(n): secuencia de arranque a una pantalla, sin tocar RST.
    - OLED_REINIT[:n] (sin n, las diez): lo ejecuta Core 1, que repinta la
    pantalla; contesta con las veces pedidas por pantalla. Bandera OLEDREINIT=1.
    - device.reinitScreens y botón «Reiniciar pantallas» en la Consola.
    - Firmware 4.31 en orby_version.h, compat.js, compat.json y COMPATIBILIDAD.md.
2026-11-05 feat(misil): explosiones al destruir (bola de fuego, estallidos escalonados, humo)
2026-11-05 feat(misil): cráteres de mancha punteada que no se confunden con tanques ni depósitos
2026-11-05 feat(misil): antiaéreo legible, marco de blanco y señal de peligro en la mira y el marcador
2026-11-05 feat(misil): misil enemigo, TE HAN DADO y vida que parpadea
2026-11-05 feat(fw): pantallas que se recuperan solas (fase 6 de PLAN_AIRSTRIKE, 4.32)
    - 74HC595 con margen entre flancos (~48 ns en vez de ~8): un flanco perdido
    corría la máscara y mandaba comandos a otra pantalla (un 0xAE la apaga).
    El bit-bang queda en shift_mask().
    - L2: con todo quieto, cada 250 ms una pantalla en rueda recibe otra vez su
    configuración (sin 0xAE, no parpadea) y su imagen.
    - L4: reset completo de las diez al entrar en un juego y al aparecer la app.
    - OLED_REINIT:OK añade los resets completos; device.js y la Consola lo leen.
    - PLAN_AIRSTRIKE marcado como terminado.
2026-11-05 feat(skills): publicar, nuevo-juego, teclado y comprobar para Claude Code
    - publicar: releases de firmware (prerelease) y de la app (latest) con firma
    en el servidor, latest.json sin BOM y .sig sin salto final; scripts
    crear_release.py y latest_json.py.
    - nuevo-juego: contrato de engine.js, dibujo.mjs, icono, catálogo y tests.
    - teclado: versión por ACK y flasheo por BOOTSEL; el puerto sale del registro
    porque Get-CimInstance falla en algunos Windows.
    - comprobar: tests de la app y del firmware de una vez, con msys64 al frente
    del PATH (si no, g++ falla sin error) y los tools/test/*.exe restaurados.
2026-11-06 feat(perfiles): copiar y pegar varias teclas entre perfiles con Ctrl+clic
    - Con las teclas ampliadas en el Inicio, Ctrl+clic (Cmd en Mac) elige varias;
    Copiar y Pegar (o Ctrl+C / Ctrl+V) llevan acción, etiqueta e icono de todas.
    - Una copiada se pega en la elegida o en todas las elegidas; varias, en orden si
    hay tantas elegidas como copiadas, y si no en sus mismas posiciones, así se
    copia media rejilla a otro perfil tal cual. Reglas en clipboard.mjs, con tests.
    - El portapapeles sobrevive al cambio de perfil; la selección múltiple no.
    - SUPER y la de menú no se copian ni se pisan. Si un icono propio aún no ha
    llegado del teclado, no se copia a medias: avisa.
    - Un pegado múltip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
2026-11-06 fix(juegos): partidas en la WebGUI que no se cuelgan ni piden abrir Orvy (4.33)
    - Web Serial abría el puerto con 255 B de búfer: cada fotograma (hasta 3,6 KB)
    salía a trozos, el firmware lo daba por perdido a los 20 ms
    (ERR:GAME_BIN_TIMEOUT), leía el resto como texto y la partida se congelaba
    hasta que el teclado salía solo por GAME:TIMEOUT. Ahora bufferSize 16384.
    - La cabecera GAME_BIN va precedida de \n, que resincroniza al teclado si un
    fotograma se corta; tras ERR:GAME_BIN_TIMEOUT el motor reenvía las diez.
    - En web, un oyente que lanzaba una excepción cortaba la lectura del puerto y
    la conexión entera; ahora se registra y sigue.
    - Firmware 4.33: al entrar en Juegos co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
2026-11-06 fix(autoarranque): la entrada de Windows sigue a la copia instalada de Orvy
    Al pasar de «OrbyGUI» a «Orvy» el instalador puso la app en otra carpeta y la
    entrada Run «OrbyGUI» siguió apuntando a la vieja: cada arranque de Windows abría
    la versión antigua, que se actualizaba en la carpeta nueva y volvía a salir
    antigua al día siguiente. normalizar() ya solo reparaba la falta de --hidden;
    ahora también lleva la entrada al ejecutable que corre, salvo que sea una
    compilación local (bajo target\).
2026-11-06 fix(tests): npm test funciona en Node 24
    El flag --experimental-default-type lo eliminó Node 24 ("bad option") y solo hacía
    falta en Node 20/21. Ahora se pasa únicamente si esta versión de Node lo admite.
2026-11-06 feat(blackjack): sin tope de manos, el saldo se guarda por jugador y el récord es el máximo de fichas (Orvy 1.1.22)
2026-11-06 feat(blackjack): cartas más lentas, la tapada de la banca se da la vuelta y el resultado se queda más (Orvy 1.1.22)
2026-11-06 docs(skills): publicar explica cómo fijar la cuenta de git para hacer push desde Claude
2026-11-06 docs: el código se mudó a Orvy; aquí solo releases y lo que baja la app
    AGENTS.md nuevo y aviso al principio de los dos CLAUDE.md y del README para
    que ningún agente vuelva a subir código a scroll_wheel: cómo pasar el clon a
    Orvy, qué ficheros siguen aquí porque la app instalada los descarga
    (releases, compat.json, tips-video, gh-pages) y qué versiones están cogidas.
2026-11-08 compat.json y consejos copiados de orvy.es (para apps <= 1.1.26)
